ut-ras/rm_electrical-supercap_v2/UT Robomasters – Supercap System Overview.pptx

## UT Robomasters – Supercap System

Egan Wang (ew23776)
Presented 2/10/2026

## Power OR-ing

Power

Time

90W

Objectives:
- Draw excess power from battery in low-load periods
- Provide supplementary power to robot during high-load periods
- Avoid exceeding 90W power budget

## Supercaps

598-DSF117Q3R0
0-3V
110F

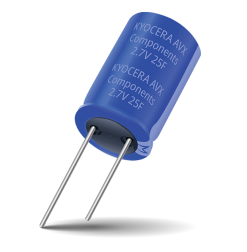
[picture p1: figure]

Objectives:
- Draw excess power from battery in low-load periods
- Provide supplementary power to robot during high-load periods
- Avoid exceeding 90W power budget

x4

## General Design & Problem Statement

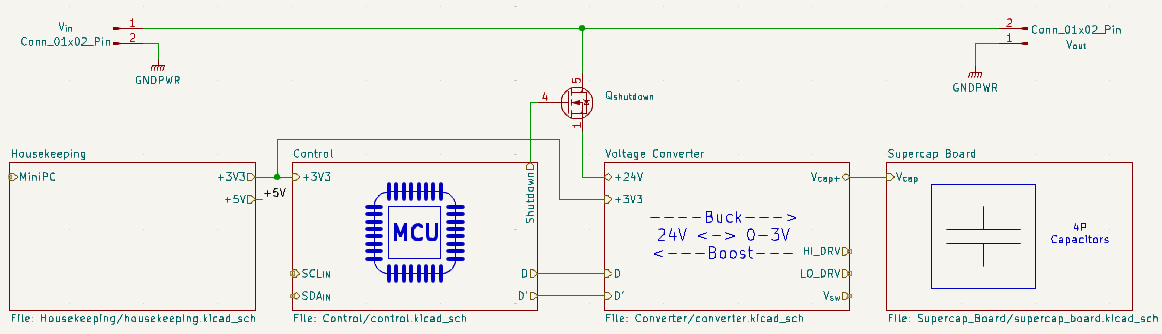
[picture p2: figure]

Problem Statement

Can directly control: duty cycle
Want to control: current coming from battery, set constant
Inputs: voltages, currents

## Converter Design – “Full-bridge Buck Converter”

- Voltage gain of 2D-1 when operated as shown in diagram
- Avoids extreme duty cycles for conversion from 22-26V to 0-3V
- Should be bidirectional

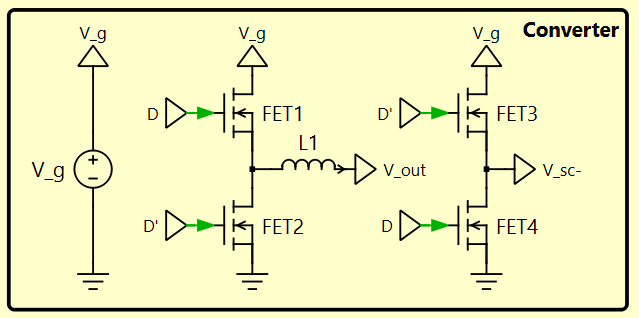
[picture p3: figure]

## Controls Design

- Assumes converter to be ideal transformer
- Closed-loop system to set battery current equal to reference calculated using 90W power budget and battery voltage measurement
- Specific design of compensator still under development

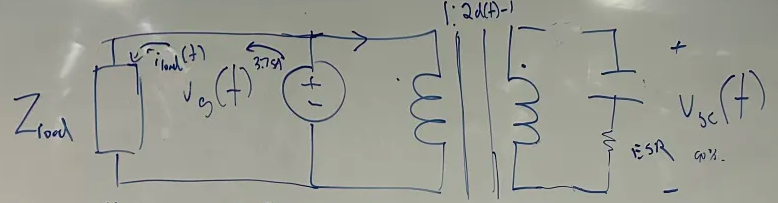
[picture p4: figure]

## Kalman Filtering – Current Sensing

- Create linearized model of circuit to calculate supercap voltage and input current
- Reduce noise of input measurements
- Requires profiling to determine if useful
