ut-ras/rm_electrical-supercap_v2/UT Robomasters – Supercap Power Stage Modeling.pptx

## UT Robomasters – Supercap Power Stage Modeling

Supercap Technical Lead: Egan Wang (ew23776)
Contributing Members: Timothy Yeap, Ethan Chu, Heath Luebsen

## PLECS Analysis: Toy Models

Toy Model Simulation as of Making These Slides

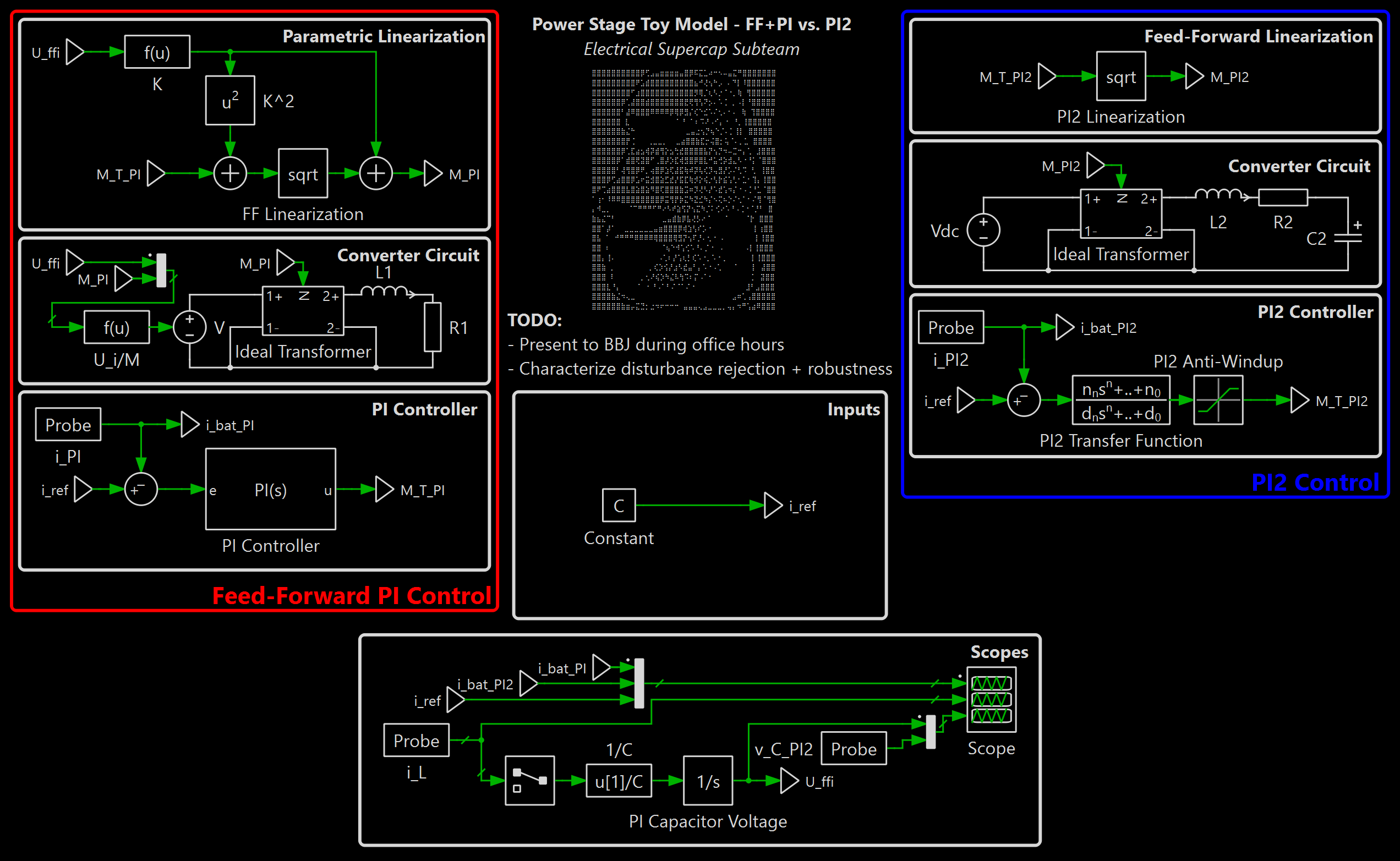
[picture p5: figure]

Power Stage Simulation - Toy Model.plecs

In case you didn’t know yet, this is what everything is about

In GitHub repository, under Sims_and_Design folder

Message me (Egan) if you don’t understand a section of this model

## List of Topics Relevant to This Presentation

Make sure you have at least basic knowledge of these concepts so that you can understand the content in this presentation:
- SRA calculations
- Ideal transformer modeling
- Laplace transforms
- Transfer functions and closed-loop systems
Make sure you are very familiar with these concepts:
- KVL and KCL
- Algebraic manipulation
- Differential and integral calculus

## Section 1: Basics of The Converter

- take notes if you have to

## Overview of Topology

- H-Bridge Converter
- 4 switches
- 2 half-bridges
- Full-bridge analogue to buck converter
- Voltage across switched nodes can be +Vg, 0, or +Vg

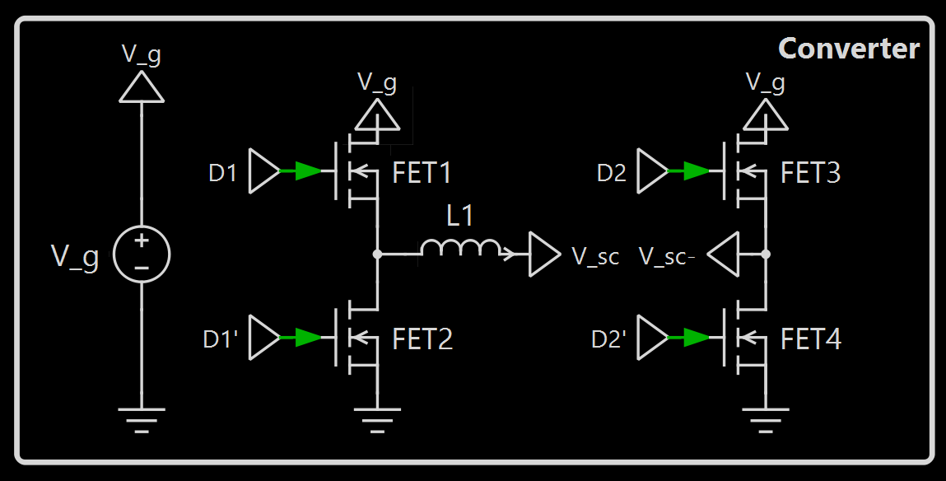
[picture p6: figure]

1 high, 2 low

1 high, 2 high

+

+Vg

+

0

1 low, 2 low

1 low, 2 high

+

0

+

-Vg

Possible Voltages

## Duty Cycle Control

- Half-bridges 1 and 2 are independent
- Both high and both low result in 0 voltage across switch nodes
- Duty ratios <2.5% and >97.5% are risky because MOSFETs take time to turn on and off
- H-bridge topology allows finer control
- Control scheme shown on right
- Duty cycle “seen” across switch nodes labelled as M(t)

Halfway point (50% duty cycle)

Half-bridge 1 duty ratio: 0.5 + doff(t)
Half-bridge 2 duty ratio: 0.5 – doff(t)
Duty cycle “seen” by inductive tank: 2*doff(t)

Scope Reading

Half-bridge 1
Half-bridge 2

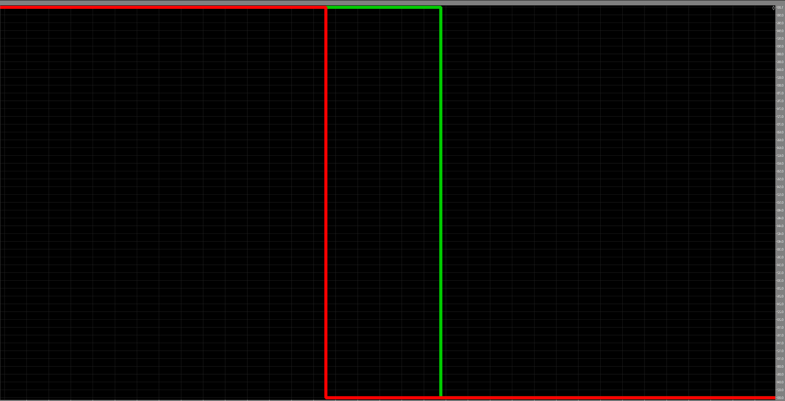
[picture p7: figure]

doff(t)

doff(t)

## Transformer Equivalent

- Use SRA analysis and derive KCL- and KVL-like equations
- Convert into loops and create ideal transformer model of circuit with gain 1:M(t)
- Transformer model will be useful for reflection math tricks

Ideal Transformer Model

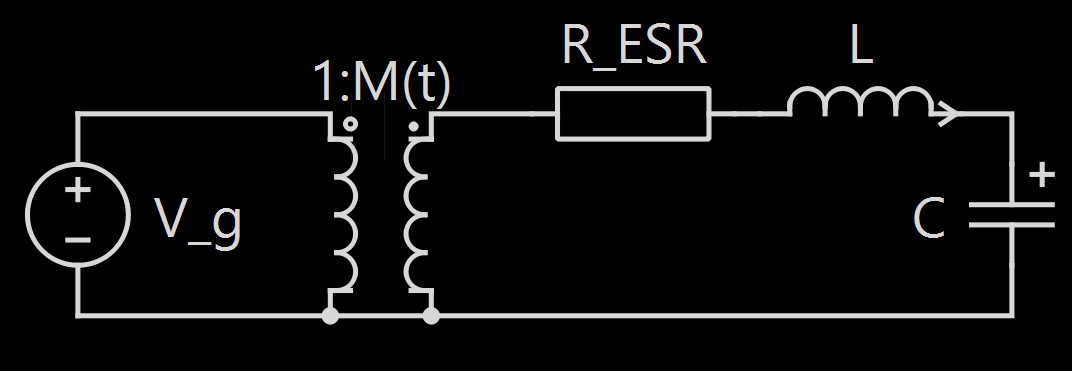
[picture p8: figure]

Voltage/Current Source Model

read it if you don’t know what transformer reflection is

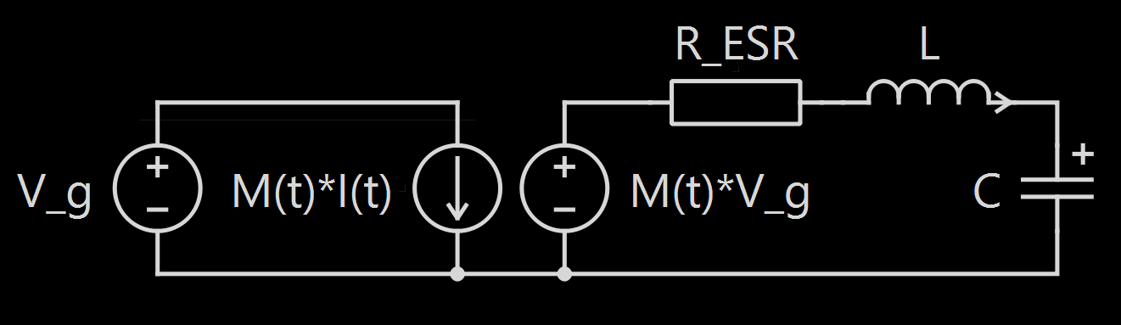
[picture p9: figure]

## Capacitor Feed-Forward Correction

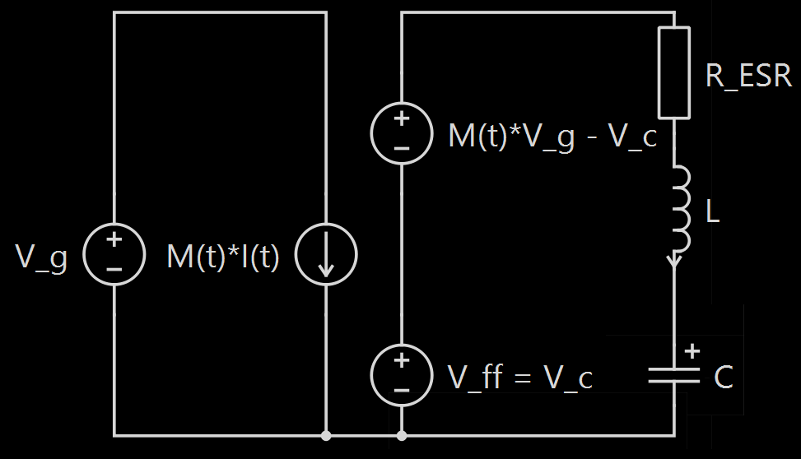
[picture p10: figure]

Separated Voltages

- Split the voltage source on the right into a Vc(t) component and remainder
- Remainder voltage has to be equal to voltage across RL branch
- Current is conserved - take note of the current/voltage behavior of the transformer
- “Cut out” the capacitor and focus on the RL branch
- Even though Vc(t) is time-variant, it changes very slowly and can be treated as constant
- Remember to adjust the voltage source on the left side to compensate – reflect the new voltage source by dividing by M(t)

Isolated RL Branch

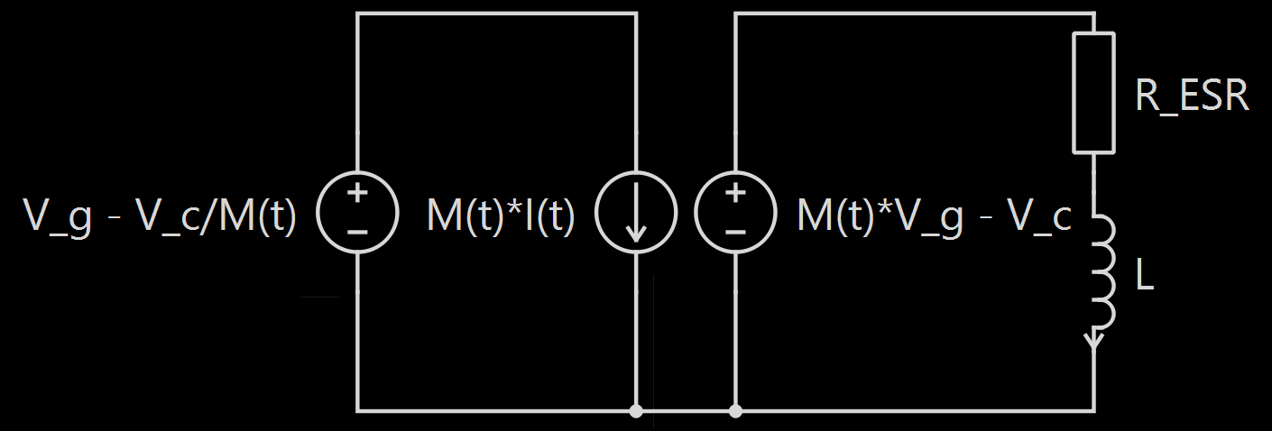
[picture p11: figure]

## Battery Current Reflection

Complete Toy Model

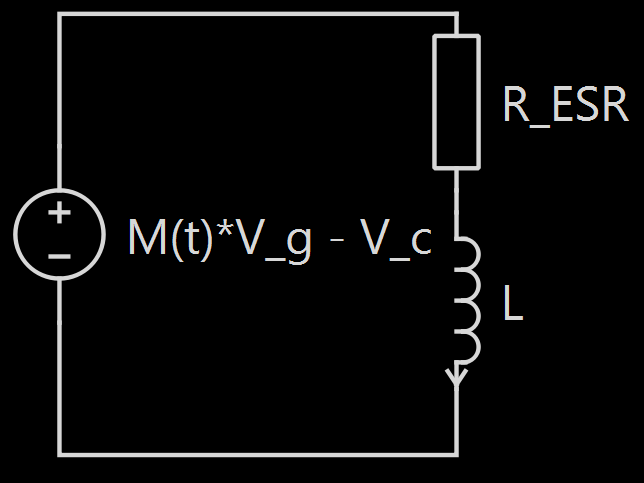
[picture p12: figure]

- Reflect the voltage source across the transformer
- In previous diagram, this is basically already done
- Battery current needs to be scaled by turns ratio
- We have our toy model!
- Write the KVL equation*:
- M(t)∗V_g −V_c =(R_(ESR))/(M(t))∗I_(bat) (t)+L/(M(t))∗d/(dt)I_(bat) (t)
- *before you ask, yes, this calculation ignores the (dM(t))/(dt) term that appears when doing the product rule for d/(dt)I_(RL) (t) . It is possible to account for this by doing another pair of transformer voltage/current reflections, but this presentation is long enough, and we find out that the term is negligible anyway. Consider this an exercise for the reader to prove, if you will.

IRL(t) = Ibat(t)/M(t)

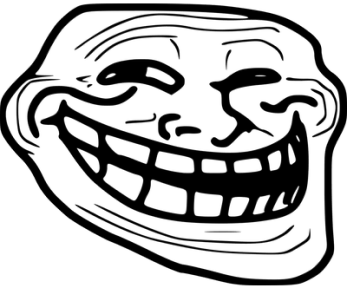
[picture p13: figure]
trollface - Wiktionary, the free dictionary

## Algebraic Manipulation & Linearization

From the equation:
M(t)∗V_g −V_c =(R_(ESR))/(M(t))∗I_(bat) (t)+L/(M(t))∗d/(dt)I_(bat) (t)
Multiply by M(t):
M(t)^2 ∗V_g −M(t)∗V_c =R_(ESR) ∗I_(bat) (t)+L∗d/(dt)I_(bat) (t)
This is quite the nasty equation. It has quadratic terms and a derivative. Let’s define a new variable for the LHS of the equation,
M_T (t)=M(t)^2 −M(t)∗(V_c)/(V_g)
labelled MT(t) due to being roughly equivalent to the “transformer reflection” of the voltage gain M(t).
We complete the square and rewrite:
M_T (t)=(M(t)−(V_c)/(2V_g))^2 −((V_c)/(2V_g))^2

We can then define an auxiliary variable:
M_T (t)=(M(t)−K_T )^2 −K_T^2 ,K_T =(V_c)/(2V_g)
Rewrite the KVL equation:
V_g ∗M_T (t)=R_(ESR) ∗I_(bat) (t)+L∗d/(dt)I_(bat) (t)
By encapsulating the quadratic term within a new variable, we now have only additions, scalar multiplications, and derivatives – the equation is linear! We can now convert to s-domain:
V_g ∗M_T (s)=R_(ESR) ∗I_(bat) (s)+sL∗I_(bat) (s)
Rewrite as a transfer function:
G_(I_(bat) ,M_T) (s)=(V_g)/(sL+R)
We have a proper transfer function now!

## Overall System Design – FF+PI

We go back to our definition of MT(t):
M_T (t)=(M(t)−K_T )^2 −K_T^2 ,K_T =(V_c)/(2V_g)
Solve for M(t):
M(t)=K_T ±√(M_T (t)+K_T^2)
We will be using the solution with both terms added. (The subtractive solution produces identical behavior. Proof is left as exercise to the reader.)
We can thus design our system as a linear black box composed of the linearization above combined with the physical circuitry.

u(t)⇔M_T (s)

Linearization + Circuit

I_(bat) (s)
=G_(I_(bat) ,M_T) (s)∗M_T (s)
=(V_g)/(sL+R)M_T (s)

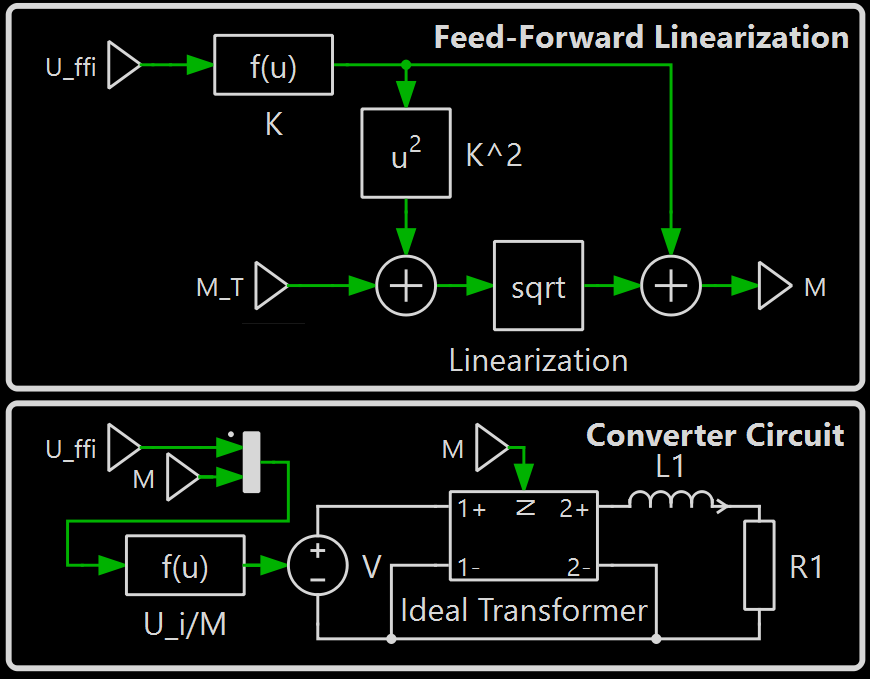
[picture p14: figure]

## Alternative Design – PI² Control

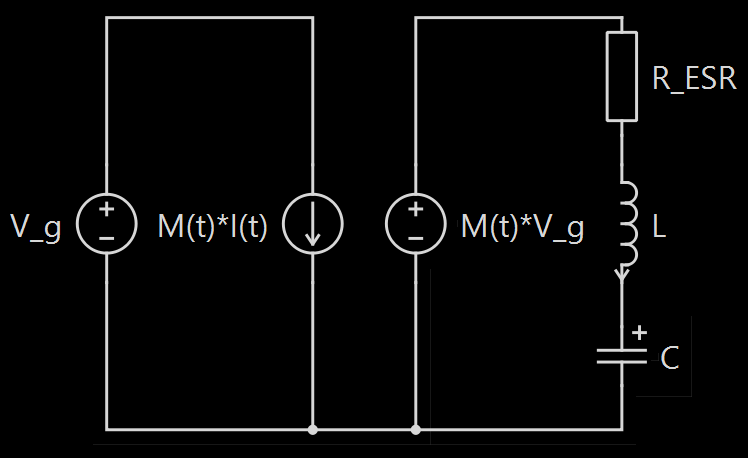
[picture p15: figure]

Singular RLC Branch

- Math trick of defining auxiliary variable can be done earlier
- No need to split apart voltage source on right side of transformer
- Reflect battery current to right side once again
- New toy model appears analogous to the one in the FF+PI model
- Write new KVL loop equation*:
- M(t)∗V_g =(R_(ESR))/(M(t))∗I_(bat) (t)+L/(M(t))∗d/(dt)I_(bat) (t)+1/(C∗M(t))∫ I_(bat) (t)dt
- *Remember that caveat in small print from before? Exercise for the reader: can we ignore this imperfection in our calculus now?

Complete Toy Model

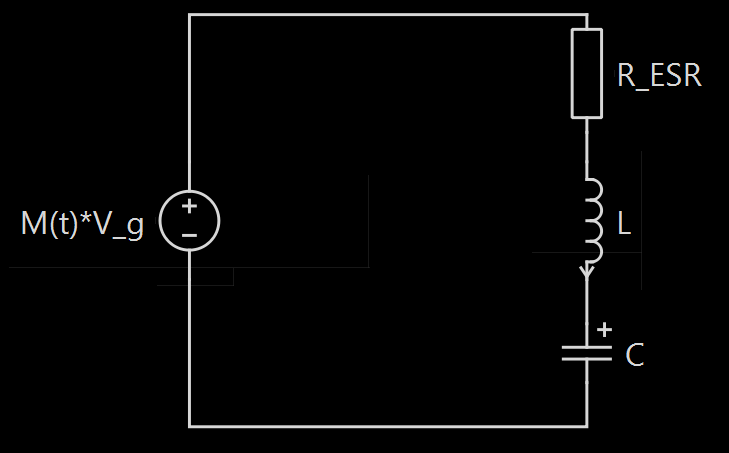
[picture p16: figure]

IRL(t) = Ibat(t)/M(t)

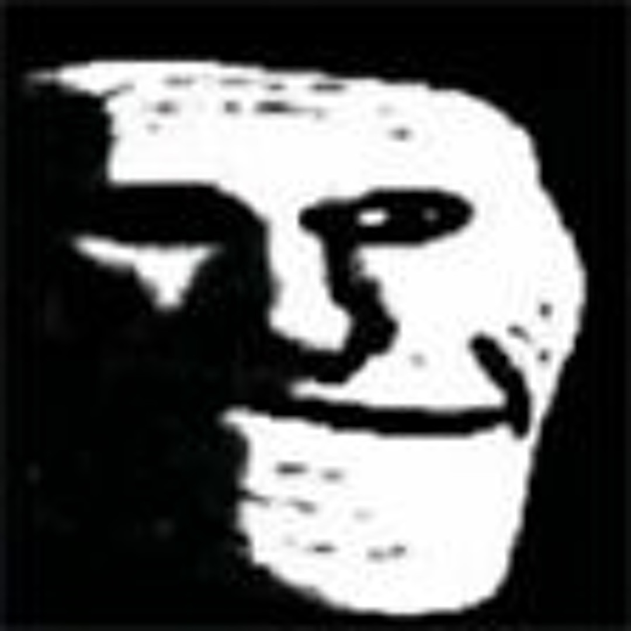
[picture p17: figure]
Stream i miss LSDvlad trolldespair (old hardtekk mix) by Flerian | Listen online for free on SoundCloud

## PI² Control Linearization

From the equation:
M(t)∗V_g =(R_(ESR))/(M(t))∗I_(bat) (t)+L/(M(t))∗d/(dt)I_(bat) (t)+1/(C∗M(t))∫ I_(bat) (t)dt
Multiply by M(t):
M(t)^2 ∗V_g =R_(ESR) ∗I_(bat) (t)+L∗d/(dt)I_(bat) (t)+1/C∫ I_(bat) (t)dt
Our algebra trick is a lot simpler now, and we don’t need to complete the square or define a new auxiliary variable:
M_T (t)=M(t)^2 , M(t)= ±√(M_T (t))
Our KVL equation is now:
V_g ∗M_T (t)=R_(ESR) ∗I_(bat) (t)+L∗d/(dt)I_(bat) (t)+1/C∫ I_(bat) (t)dt
Converting to s-domain:
V_g ∗M_T (s)=R_(ESR) ∗I_(bat) (s)+sL∗I_(bat) (s)+1/(sC)∗I_(bat) (s)

Rewrite as a transfer function:
G_(I_(bat) ,M_T) (s)=(sV_g C)/(s^2 LC+sRC+1)
A little messier, but this is once again a proper transfer function. Note the factor of s in the numerator.
Once again, we can combine the MT(t) to M(t) transformation and the electrical circuitry together and treat it as a singular linear system.
While I was able to skip over many steps since the approach is similar, this idea of PI² control seems to be significantly simpler, even if the transfer function looks more complicated. So why not use this method? Let’s test them out…

## Time-Domain Simulation (0s<t<100s)

Response to 3.75A step input
FF+PI performance is in green
PI² performance is in red

Constant Target Current

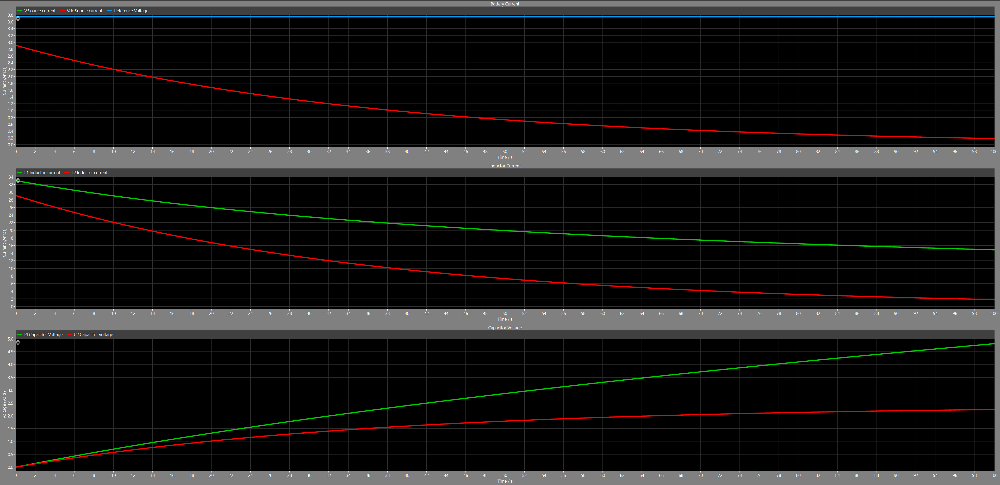
[picture p18: figure]

You can’t see it here, but the FF+PI current waveform is overlapping the target current

## Time-Domain Analysis

- Remember that asterisk? What we did was assume that
- 1/C∫ (I_(bat) (t))/(M(t))dt=1/(C∗M(t))∫ I_(bat) (t)dt
- We can’t actually do this since M(t) is not a scalar value, and this has come back to bite us. Notice that this integral term corresponds precisely to the voltage term that was accounted for with a feed-forward signal!
- Therefore, going forward, our best bet is to stick with FF+PI control.
- Note: If y’all can figure out a way to get a more accurate representation of the system and get a feasible implementation of PI² control, please let me know

## Addendum: On Feed-Forward Systems

In general, feed-forward systems are a way to perform disturbance rejection, where extraneous signals that result from interactions of the system with itself and surroundings (known as disturbances) have their undesirable effects minimized. This particular approach directly measures the quantity in question (capacitor voltage) and subtracts it – pretty intuitive.
A question I answered and found pertinent to include: Why not feed-forward the inductor current? The inductor current is the “through” variable for the entire RLC branch, so performing feed-forward cancellation would result in a controlled current of 0.

## Section 2: Reverse Charging and Boost Mode

- PLECs moment

## Overall System Review: Reverse Charging

- Whole system works as parallel sources
- Nodes between battery, converter, and load use KCL to divide current
- No qualitative distinction between forward charging (storing excess energy) and reverse charging (releasing needed energy)
- System must work seamlessly between both forward and reverse to allow current control behavior

Battery

Load

Converter

Basic Full System Model

## Reverse Charging: Maximum Reverse Current

- Formula for M(t) has limits:
- M(t)=K_T ±√(M_T (t)+K_T^2)
- M_T (t)<−K_T^2 results in non-real M(t)
- Sets limit on maximum reverse current using M_T (t) math trick
- Minimum M_T (t) corresponds to M(t)=K_T , greater than minimum M(t) realizable
- Look back on model with RL branch – possible to attain higher reverse current?
- I_(bat) (t)=I_L (t)∗M(t)<0 requires either I_L (t)<0, M(t)>0 or I_L (t)>0, M(t)<0

Negative current means current flows into battery
Either current flows in reverse from inductor or transformer polarity flips

Isolated RL Branch

## Maximum Reverse Current, Continued

I_L (t)>0, M(t)<0

I_L (t)<0, M(t)>0

1 high, 2 low

1 high, 2 high

+

+Vg

+

0

1 low, 2 low

1 low, 2 high

+

0

+

-Vg

M(t)<0 corresponds to a change to −V_g regime
Current flowing out of capacitor results in negative inductor current
Thus I_L (t)<0, M(t)<0 , I_(bat) (t)>0
Reverse charging not possible!

Possible Voltages

Isolated RL Branch

I_L (t)<0 corresponds to negative inductor current
Steady-state negative inductor current requires M(t)∗V_g −V_c <0 due to RL branch impedance
Thus M(t)∗V_g <V_c , M(t)>0 , I_(bat) (t)<0
Reverse charging is possible!

## Maximum Reverse Current, Continued

To find steady-state maximum reverse current, we approximate the inductor as having 0 impedance. Negative voltage across resistor in RL branch causes negative current which is then reflected across ideal transformer. We can thus derive an expression for reverse current:
I_(bat) (t)=(V_G ∗M(t)^2 −V_C ∗M(t))/R
Apply optimization for maximum reverse current:
I_(bat,max) =(V_C^2)/(4V_G R),M(t)=(V_C)/(2V_G)=K
A familiar constant appears! Let’s see if a corresponding M_T (t) appears:
M_T (t)=(M(t)−K_T )^2 −K_T^2
∴M_T (t)=−K_T^2
This is precisely the minimum value we saw earlier!

This conclusion tells us that our control scheme should (at least theoretically) work in with both forward and reverse currents. All we need to do is make sure that M_T (t) never drops below its minimum value of −K_T^2 , and we should be able to see a smooth transition between the two domains!
To find out, we simply leave everything as-is and see what happens when we set the reference current to a negative value.

## Time-Domain Simulation (0s<t<????)

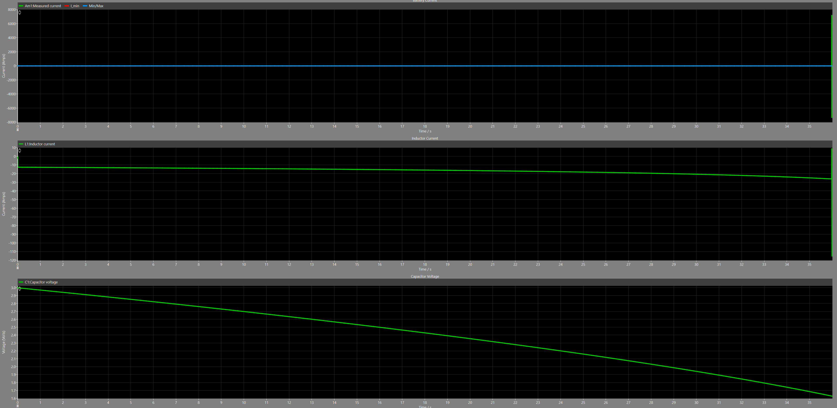
[picture p19: figure]
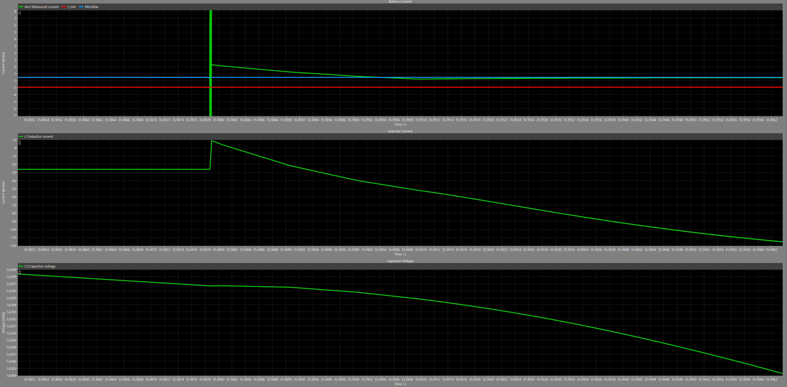
[picture p20: figure]

## Modeling Schema – State-Space Model

Start with KCL and KVL equations for RLC branch:
M(t)∗V_g (t)−R∗i(t)−v_c (t)−L∗(di(t))/(dt)=0
i(t)=C∗(dv_c (t))/(dt)
Rearrange to solve for derivates of state variables ( i(t), v_c (t) ) and output i_(bat) (t) :
d/(dt)[i(t)v_c (t)]=[1/L∗(M(t)∗V_g (t)−R∗i(t)−v_c (t))1/C∗i(t)]
i_(bat) =M(t)∗i(t)
Note the combination of state variables into a state vector – this forms the state-space model. Take integral of both sides of first equation to arrive at new mathematical model of system (bottom image)

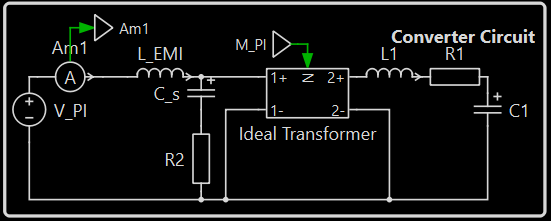
[picture p21: figure]
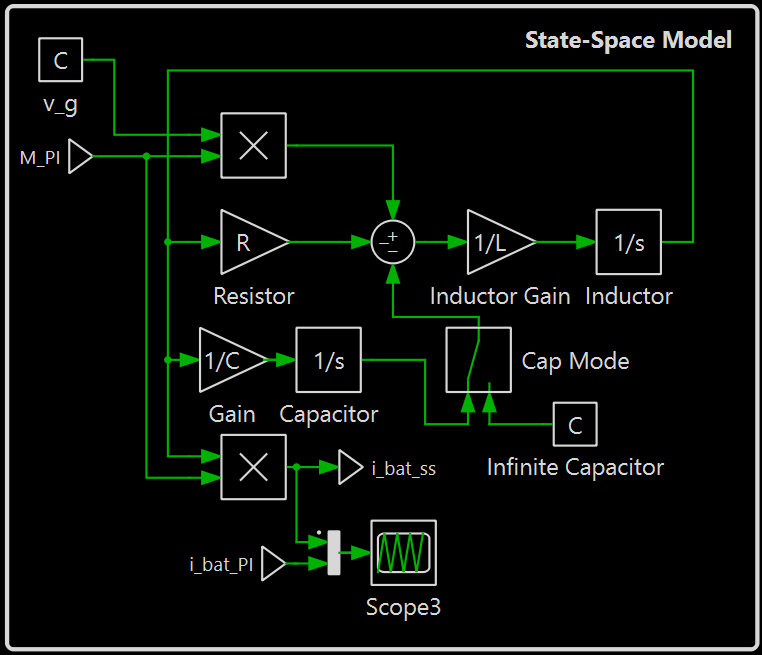
[picture p22: figure]

KVL

## New Time-Domain Simulation (0<t<100)

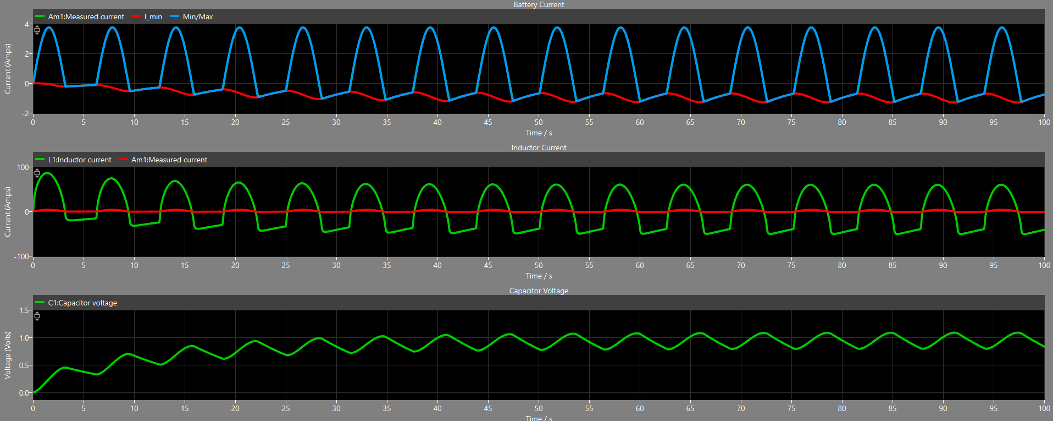
[picture p23: figure]

With this new model, everything works!

## Addendum: Resistance and Inductor Characteristics

3/28/2026:

4/1/2026:

First-order estimates for R approximate its value at 83 mΩ, making the maximum reverse current roughly 1.2A at full capacitor charge. Considering that the maximum reverse current scales with stored capacitor voltage and the capacitor is not expected to be at full charge during operation, this results in even lower maximum reverse current during expected operation conditions.
To ameliorate this limitation, increasing reverse current would require lower resistance across the RL branch, the lion’s share of which is from the inductor. Maximizing copper area and mitigating skin effects are of utmost importance to optimize performance.

The switched-cycle average model used to calculate maximum reverse current uses switch-cycle average voltages and currents for its modeling of system dynamics, meaning it disregards effects at the converter’s 120kHz switching frequency. Average signals can be treated as low-frequency and skin effects can be discarded.
Experimentally, the inductor was rewound to optimize DC resistance instead of AC resistance and a new resistance value of 4 mΩ was measured.

## Section 3: Disturbance Rejection & Robustness

- alright guys ill need yall to pitch in now

## Sources of Inaccuracies: Examples

Average Inductor Current

<iL(t)>

Inductor current graph:

Resistance

R

First-order calculation:
R_(eq) =2∗R_(on) +R_L +(R_C)/4

All dependent on temperature

<iL(t)> is not even directly measurable*

Noise on each switch transition

Current ripple introduces AC component

(+ R_(board) )
PCB trace resistances are hard to measure

<iL(t)>

iL(t)

MOSFET resistance dependent on gate voltage

Inductor resistance dependent on frequency due to skin effect**

Both signals and system parameters will not behave exactly as in the model

*It is possible to get a good guess of <iL(t)> by measuring exactly between switch transitions. However, these transitions can appear arbitrarily close together due to the soft-starting capability of the H-bridge, and the AC component of the signal will introduce extra complications beyond this simplified model.
**While frequency is fixed for this application, the LCR meter in the solar lab only measures impedance at 100kHz, so it’s possible for measurement error to creep in as a result.

## Disturbance Rejection - Noise

- Linear systems can be represented by block diagrams and transfer functions
- Disturbances enter at different points of the loop
- Control disturbance W(s) , sensor noise N(s) , rounding error D(s) all considered disturbances
- Simplify feedback to single disturbance source with unity feedback
- Rounding error ignored/bundled into sensor noise
- Note that controller cannot tell the difference between N(s)∗H(s) and R(s)

W(s)

Linear System With Noise

R(s)

+

+

PI Controller
D(s)

+

Plant
G(s)

Y(s)

Scaling
H(s)

+

Sensor gain
H^(−1) (s)

D(s)

N(s)

W(s)

Simplified UFB System

R(s)

PI Controller
D(s)

Plant
G(s)

Y(s)

+

+

+

N(s)∗H(s)

## Disturbance Rejection – Full Model

w(t)

Full UFB System

e(s)

PI Controller
D(s)

M_T (s)

Linearized Plant
G_(iM_T) (s)

Linearization
M_T (t)→M(t)

M(t)

Plant
G_(iM) (t)

I_(ref) (s)

+

+

I_(bat) (s)

I_(bat,sense) (s)

+

N(s)∗H(s)

Key Takeaway: Disturbance w(t) is inserted into the nonlinear control signal M(t) and cannot be analyzed using typical tools
Can trivially calculate transfer function (I_(bat) (s))/(N(s))=H(s)∗(D(s)G_(iM_T) (s))/(1+D(s)G_(iM_T) (s))

## Model Robustness - Sensitivity

- Definition: Change in output behavior of a system relative to change in parameter
- Relative change determined in proportion to parameter size
- Can use simple calculus and algebra
- Very useful metric to evaluate robustness of closed-loop control systems
- Accounts for numerical stability issues like small-difference-of-large-numbers and division by small numbers

S_G^T =((ΔT)/T)/((ΔG)/G)
S_G^T =(ΔT)/(ΔG)∗G/T
S_G^T =(dT)/(dG)∗G/T

“Sensitivity of T to G”

Can be done relative to the entire plant G(s) or to specific parameters in the closed-loop system

## Sensitivity

S_(V_g)^T =(sL+R)/(sL+R+DV_g)
S_R^T =R/(sL+R+DV_g)
S_L^T =(sL)/(sL+R+DV_g)

R=0.08233Ω
V_g =24V
L=28.306μF
K_p =2.13422
K_i =6207.54

E_(V_g) =R/(K_i V_g)
E_R =R/(K_i V_g)
E_L =0

E_(V_g) =0.55262∗10^(−6)
E_R =0.55262∗10^(−6)
E_L =0

## Sensor White Noise

It was empirically found that the MSPM0-G3507 12-bit ADC’s error has SD of 14 (decimal).

SD_E _(reading) =1/(gain_(sensor))∗3.3/4095∗14

SD_(E_(i, Inductor)) =(1000 A)/(80 V)∗(3.3 V)/4095∗14=0.141 A

SD_(E_(i, Battery)) =(1000 A)/(132 V)∗(3.3 V)/4095∗14=0.0855 A

SD_(E_(v,Capacitor)) =(10 V)/(11 V)∗(3.3V)/4095∗14=0.0103 V

SD_(E_(v,Battery)) =(8 V)/(1 V)∗(3.3 V)/4095∗14=0.0903 V
