ut-ras/rm_electrical-supercap_v2/Sims_and_Design/Sensitivity Equations (RM Electrical).pdf

SVg

T =

sL + R
sL + R + DVg

SR

T = −

R
R + sL + DVg

SL

T = −

sL
R + sL + DVG
