ut-ras/rm_electrical-supercap_v2/Sims_and_Design/Pi Filter/PI Filter Values (RM_Electrical '26).xlsx

L | C | R | a | L (uH) | C (uF) | R (kΩ) | f (Hz) | 1/(RC)
2.7e-05 | 1.007e-05 | 1317.074 | 48780443.13 | 27 | 10.07 | 1.317074 | 7763877.628 | 75.39809146
2.7e-05 | 1.044e-05 | 1270.396162 | 47051634.33 | 27 | 10.44 | 1.270396162 | 7488721.045 | 75.39808718
2.7e-05 | 1.066e-05 | 1244.177897 | 46080587.46 | 27 | 10.66 | 1.244177897 | 7334169.579 | 75.39808464
2.7e-05 | 1.088e-05 | 1219.019929 | 45148810.88 | 27 | 10.88 | 1.219019929 | 7185868.356 | 75.39808209
2.7e-05 | 1.108e-05 | 1197.015996 | 44333850.39 | 27 | 11.08 | 1.197015996 | 7056159.541 | 75.39807977
2.7e-05 | 1.109e-05 | 1195.936633 | 44293873.97 | 27 | 11.09 | 1.195936633 | 7049796.908 | 75.39807966
2.7e-05 | 1.197e-05 | 1108.014958 | 41037515.65 | 27 | 11.97 | 1.108014958 | 6531516.099 | 75.39806948
2.7e-05 | 1.248e-05 | 1062.735584 | 39360501.79 | 27 | 12.48 | 1.062735584 | 6264603.182 | 75.39806357
2.7e-05 | 1.264e-05 | 1049.283261 | 38862267.59 | 27 | 12.64 | 1.049283261 | 6185304.407 | 75.39806172
2.7e-05 | 1.267e-05 | 1046.798775 | 38770249.59 | 27 | 12.67 | 1.046798775 | 6170658.856 | 75.39806137
2.7e-05 | 1.271e-05 | 1043.504371 | 38648234.65 | 27 | 12.71 | 1.043504371 | 6151239.001 | 75.39806091
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
