ut-ras/rm_electrical-supercap_v2/Sims_and_Design/Pi Filter/pi_filter_solutions.xlsx

L_uH | C_uF | R_kOhm | f_Hz | zero | gain
2 | 10.1980198 | 1.300538387 | 8624463.833 | 75.39819926 | 0.9999998841
2 | 10.2070207 | 1.299391528 | 8616858.486 | 75.39819925 | 0.999999884
2 | 11.04410441 | 1.200904651 | 7963746.962 | 75.39819853 | 0.9999998744
2 | 11.05310531 | 1.199926715 | 7957261.827 | 75.39819852 | 0.9999998743
2 | 11.06210621 | 1.198950372 | 7950787.244 | 75.39819852 | 0.9999998742
2 | 12.05220522 | 1.100455581 | 7297623.243 | 75.39819767 | 0.999999863
2 | 12.06120612 | 1.099634346 | 7292177.256 | 75.39819766 | 0.9999998629
2 | 12.07020702 | 1.098814335 | 7286739.391 | 75.39819765 | 0.9999998628
2 | 13.25832583 | 1.000346262 | 6633752.561 | 75.39819663 | 0.9999998493
2 | 13.26732673 | 0.9996676008 | 6629252.051 | 75.39819663 | 0.9999998492
2.383838384 | 10.1980198 | 1.300538416 | 7235778.979 | 75.39819758 | 0.9999998618
2.383838384 | 10.2070207 | 1.299391557 | 7229398.221 | 75.39819757 | 0.9999998617
2.383838384 | 11.04410441 | 1.20090468 | 6681448.723 | 75.39819672 | 0.9999998503
2.383838384 | 11.05310531 | 1.199926744 | 6676007.804 | 75.39819671 | 0.9999998502
2.383838384 | 11.06210621 | 1.198950401 | 6670575.739 | 75.3981967 | 0.9999998501
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
