ut-ras/rm_electrical-supercap_v2/Sims_and_Design/Power Consumption, Efficiency.xlsx

+3V3 |  | Total Current: | 117.5mA | +12V |  | Total Current: | 75.9mA | 24+V |  | Total Current: | 0mA | Total Power Draw: | 1.3W | 0.05A @ 24V
Component | Supply Current | Quantity | Sum Current | Component | Supply Current | Quantity | Sum Current | Component | Supply Current | Quantity | Sum Current | Switching frequency: | Gate charge:
U_iL | 0.0055 | 1 | 0.0055 | MOSFET | 0.0171 | 4 | 0.0684 | U_vc | 8e-09 | 1 | 8e-09 | 150000 | 1.14e-07
U_ig | 0.012 | 1 | 0.012 | Gate Driver | 0.00375 | 2 | 0.0075 | U_vg | 2.8e-09 | 1 | 2.8e-09
MSPM0 | 0.1 | 1 | 0.1
Best: | N7803-1PV |  |  | Best: | P7812B-1000 |  |  | Best: | SCT01F12S3V3
+1V65 Reference Voltage Circuit
Label | Value | Units | Procedure
Desired Vz | 1.65 | volts | 1) pick a desired reference voltage Vz (volts)
Vref | 1.233 | volts | LM4041 parameter
R1 | 47 | kohm | 2) choose a standard resistance value (kohm)
best R2 | 15.89537713 | kohm | 2.5) Note this value for binning imperfect resistances
Pick R2 | 16 | kohm | 3) pick a standard value for R2 close to best R2
Actual Vref | 1.652744681 | volts | Vz=Vref(1+R2/R1)
Vs | 3.3 | volts | V supply
Rin | 10 | kohm | 4) estimate input impedence on Vz (e.g., to DAC)
Iz | 0.08 | mA | LM4041 parameter
Iref | 0.02623404255 | mA | Vz/(R1+R2), Ohms Law, current through R1,R2
IL | 0.1652744681 | mA | Vz/Rin, Ohms Law, current through Rin
I total | 0.2715085106 | mA | Iz+Iref+IL
max Rs | 6.067048562 | kohm | (Vs-Vz)/Itotal
 | 5.6 | kohm | 5) choose Rs less than max Rs
