ut-ras/rm_electrical-supercap_v2/Sims_and_Design/Inductor Design & Selection/3A Isat.xlsx

Selected | Order Code | Series | Size | Spec | Type | L0 | RDC,typ | IR | Isat | fres | Vop | L | W | HMax | Top | Shielded | AEC-Q | Automotive | Material | Assembling Technology | EmptyProperty
 | 74437529203681 | WE-HCF | 2920 Round | https://www.we-online.com/katalog/en/datasheet/74437529203681 | Single | 0.00068 | 0.1183 | 4.3 | 3 | 1133000 | 250 | 0.025 | 0.028 | 0.0205 | 125 | Shielded | 1 | FALSE | MnZn | SMT
 | 74437529203471 | WE-HCF | 2920 Round | https://www.we-online.com/katalog/en/datasheet/74437529203471 | Single | 0.00047 | 0.08345 | 5.2 | 3.7 | 1695000 | 250 | 0.025 | 0.028 | 0.0205 | 125 | Shielded | 1 | FALSE | MnZn | SMT
 | 74437529203331 | WE-HCF | 2920 Round | https://www.we-online.com/katalog/en/datasheet/74437529203331 | Single | 0.00033 | 0.07045 | 5.75 | 4.3 | 2395000 | 250 | 0.025 | 0.028 | 0.0205 | 125 | Shielded | 1 | FALSE | MnZn | SMT
 | 74437529203221 | WE-HCF | 2920 Round | https://www.we-online.com/katalog/en/datasheet/74437529203221 | Single | 0.00022 | 0.03645 | 8.15 | 5.3 | 2818000 | 250 | 0.025 | 0.028 | 0.0205 | 125 | Shielded | 1 | FALSE | MnZn | SMT
 | 74437429203151 | WE-HCF | 2920 Litz | https://www.we-online.com/katalog/en/datasheet/74437429203151 | Single | 0.00015 | 0.03885 | 7.9 | 7.8 | 3758000 | 250 | 0.025 | 0.028 | 0.0205 | 125 | Shielded | 1 | FALSE | MnZn | SMT
 | 74437529203151 | WE-HCF | 2920 Round | https://www.we-online.com/katalog/en/datasheet/74437529203151 | Single | 0.00015 | 0.0306 | 9 | 7.2 | 3186000 | 250 | 0.025 | 0.028 | 0.0205 | 125 | Shielded | 1 | FALSE | MnZn | SMT
 | 74437636351012 | WE-HCFT | 3635 | https://www.we-online.com/katalog/en/datasheet/74437636351012 | Single | 0.00011 | 0.00628 | 23.7 | 27.2 | 5106750.313 | 400 | 0.036 | 0.0357 | 0.0342 | 155 | Shielded | 0 | FALSE | Metal Alloy | THT
 | 7447707101 | WE-PD | 1280 | https://www.we-online.com/katalog/en/datasheet/7447707101 | Single | 0.0001 | 0.105 | 2.1 | 3.5 | 4300000 | 120 | 0.012 | 0.012 | 0.008 | 150 | Shielded | 1 | FALSE | MnZn / NiZn | SMT
 | 7447709101 | WE-PD | 1210 | https://www.we-online.com/katalog/en/datasheet/7447709101 | Single | 0.0001 | 0.1 | 2.5 | 3.1 | 4300000 | 120 | 0.012 | 0.012 | 0.01 | 125 | Shielded | 1 | TRUE | NiZn | SMT
 | 744373965101 | WE-LHMI | 1365 | https://www.we-online.com/katalog/en/datasheet/744373965101 | Single | 0.0001 | 0.1408 | 3.2 | 6.8 | 2400000 | 120 | 0.0135 | 0.0125 | 0.0065 | 125 | Shielded | 1 | FALSE | Iron Powder | SMT
 | 7447231101 | WE-TI | 1018 | https://www.we-online.com/katalog/en/datasheet/7447231101 | Single | 0.0001 | 0.075 | 2.6 | 3.1 | 3577319.5 | 120 | 0.01 | 0.01 | 0.019 | 125 | Unshielded | No | FALSE | NiZn | THT
 | 74437429203101 | WE-HCF | 2920 Litz | https://www.we-online.com/katalog/en/datasheet/74437429203101 | Single | 0.0001 | 0.0359 | 8.2 | 9.7 | 4260000 | 250 | 0.025 | 0.028 | 0.0205 | 125 | Shielded | 1 | FALSE | MnZn | SMT
 | 74437529203101 | WE-HCF | 2920 Round | https://www.we-online.com/katalog/en/datasheet/74437529203101 | Single | 0.0001 | 0.0229 | 10.5 | 9.4 | 4260000 | 250 | 0.025 | 0.028 | 0.0205 | 125 | Shielded | 1 | FALSE | MnZn | SMT
 | 7447709820 | WE-PD | 1210 | https://www.we-online.com/katalog/en/datasheet/7447709820 | Single | 8.2e-05 | 0.0905 | 2.75 | 3.4 | 4500000 | 120 | 0.012 | 0.012 | 0.01 | 125 | Shielded | 1 | TRUE | NiZn | SMT
 | 74435588200 | WE-HCI | 2212 | https://www.we-online.com/katalog/en/datasheet/74435588200 | Single | 8.2e-05 | 0.0304 | 6.6 | 8.5 | 5000000 | 80 | 0.0225 | 0.022 | 0.0124 | 125 | Shielded | 1 | FALSE | MnZn | SMT
 | 784373170820 | WE-LHCA | 1770 | https://www.we-online.com/katalog/en/datasheet/784373170820 | Single | 8.2e-05 | 0.09 | 4.9 | 9.6 | 2633700 | 120 | 0.01745 | 0.01695 | 0.007 | 155 | Shielded | 0 | TRUE | Metal Alloy | SMT
 | 7447707680 | WE-PD | 1280 | https://www.we-online.com/katalog/en/datasheet/7447707680 | Single | 6.8e-05 | 0.078 | 2.45 | 4.2 | 5500000 | 120 | 0.012 | 0.012 | 0.008 | 150 | Shielded | 1 | FALSE | MnZn / NiZn | SMT
 | 7447709680 | WE-PD | 1210 | https://www.we-online.com/katalog/en/datasheet/7447709680 | Single | 6.8e-05 | 0.0686 | 3.2 | 3.6 | 6000000 | 120 | 0.012 | 0.012 | 0.01 | 125 | Shielded | 1 | TRUE | NiZn | SMT
 | 74435586800 | WE-HCI | 2212 | https://www.we-online.com/katalog/en/datasheet/74435586800 | Single | 6.8e-05 | 0.0273 | 6.9 | 9.5 | 5800000 | 80 | 0.0225 | 0.022 | 0.0124 | 125 | Shielded | 1 | FALSE | MnZn | SMT
 | 74437349680 | WE-LHMI | 7050 | https://www.we-online.com/katalog/en/datasheet/74437349680 | Single | 6.8e-05 | 0.386 | 1.65 | 3.8 | 3500000 | 120 | 0.0073 | 0.0066 | 0.005 | 125 | Shielded | 1 | FALSE | Iron Powder | SMT
 | 7447480680 | WE-TI | 1014 | https://www.we-online.com/katalog/en/datasheet/7447480680 | Single | 6.8e-05 | 0.063 | 2.9 | 3.5 | 6071060.577 | 120 | 0.01 | 0.01 | 0.0145 | 125 | Unshielded | No | FALSE | NiZn | THT
 | 744870680 | WE-DD | 1280 | https://www.we-online.com/katalog/en/datasheet/744870680 | Coupled | 6.8e-05 | 0.17 | 1.35 | 3 |  | 80 | 0.012 | 0.012 | 0.0085 | 125 | Shielded | No | FALSE | NiZn | SMT
 | 74437429203680 | WE-HCF | 2920 Litz | https://www.we-online.com/katalog/en/datasheet/74437429203680 | Single | 6.8e-05 | 0.0222 | 10.8 | 10.7 | 5309000 | 250 | 0.025 | 0.028 | 0.0205 | 125 | Shielded | 1 | FALSE | MnZn | SMT
 | 74437529203680 | WE-HCF | 2920 Round | https://www.we-online.com/katalog/en/datasheet/74437529203680 | Single | 6.8e-05 | 0.0103 | 16 | 10.6 | 5663000 | 250 | 0.025 | 0.028 | 0.0205 | 125 | Shielded | 1 | FALSE | MnZn | SMT
 | 7447706680 | WE-PD | 1260 | https://www.we-online.com/katalog/en/datasheet/7447706680 | Single | 6.8e-05 | 0.082 | 2.3 | 3 | 6500000 | 120 | 0.012 | 0.012 | 0.006 | 150 | Shielded | 1 | FALSE | MnZn / NiZn | SMT
 | 784373680680 | WE-LHCA | 1040 | https://www.we-online.com/katalog/en/datasheet/784373680680 | Single | 6.8e-05 | 0.215 | 2.6 | 4.85 | 4124700 | 120 | 0.01085 | 0.01 | 0.004 | 155 | Shielded | 0 | TRUE | Metal Alloy | SMT
 | 784373170680 | WE-LHCA | 1770 | https://www.we-online.com/katalog/en/datasheet/784373170680 | Single | 6.8e-05 | 0.075 | 5.9 | 8.2 | 2334000 | 120 | 0.01745 | 0.01695 | 0.007 | 155 | Shielded | 0 | TRUE | Metal Alloy | SMT
 | 7443783533650 | WE-HCFT | 3533 | https://www.we-online.com/katalog/en/datasheet/7443783533650 | Single | 6.5e-05 | 0.01313 | 17.2 | 26.6 | 4282000 | 250 | 0.0345 | 0.036 | 0.035 | 125 | Shielded | 1 | FALSE | MnZn | THT
 | 74437636356203 | WE-HCFT | 3635 | https://www.we-online.com/katalog/en/datasheet/74437636356203 | Single | 6.2e-05 | 0.00522 | 26.3 | 43.1 | 6194997.856 | 400 | 0.036 | 0.0357 | 0.0342 | 155 | Shielded | 0 | FALSE | Metal Alloy | THT
 | 744770156 | WE-PD | 1280 | https://www.we-online.com/katalog/en/datasheet/744770156 | Single | 5.6e-05 | 0.059 | 2.8 | 3 | 7100000 | 120 | 0.012 | 0.012 | 0.008 | 125 | Shielded | 1 | TRUE | NiZn | SMT
 | 74437636355602 | WE-HCFT | 3635 | https://www.we-online.com/katalog/en/datasheet/74437636355602 | Single | 5.6e-05 | 0.00319 | 32.8 | 36.9 | 7413102.413 | 400 | 0.036 | 0.0357 | 0.0342 | 155 | Shielded | 0 | FALSE | Metal Alloy | THT
 | 784373680560 | WE-LHCA | 1040 | https://www.we-online.com/katalog/en/datasheet/784373680560 | Single | 5.6e-05 | 0.17 | 3 | 5.5 | 4419100 | 120 | 0.01085 | 0.01 | 0.004 | 155 | Shielded | 0 | TRUE | Metal Alloy | SMT
 | 784373170560 | WE-LHCA | 1770 | https://www.we-online.com/katalog/en/datasheet/784373170560 | Single | 5.6e-05 | 0.052 | 7.1 | 10.3 | 2633200 | 120 | 0.01745 | 0.01695 | 0.007 | 155 | Shielded | 0 | TRUE | Metal Alloy | SMT
 | 744770147 | WE-PD | 1280 | https://www.we-online.com/katalog/en/datasheet/744770147 | Single | 4.7e-05 | 0.053 | 3 | 3.3 | 7900000 | 120 | 0.012 | 0.012 | 0.008 | 125 | Shielded | 1 | TRUE | NiZn | SMT
 | 7447707470 | WE-PD | 1280 | https://www.we-online.com/katalog/en/datasheet/7447707470 | Single | 4.7e-05 | 0.055 | 2.9 | 5.1 | 7200000 | 120 | 0.012 | 0.012 | 0.008 | 150 | Shielded | 1 | FALSE | MnZn / NiZn | SMT
 | 7447709470 | WE-PD | 1210 | https://www.we-online.com/katalog/en/datasheet/7447709470 | Single | 4.7e-05 | 0.0459 | 3.8 | 4.5 | 6500000 | 120 | 0.012 | 0.012 | 0.01 | 125 | Shielded | 1 | TRUE | NiZn | SMT
 | 74435574700 | WE-HCI | 1890 | https://www.we-online.com/katalog/en/datasheet/74435574700 | Single | 4.7e-05 | 0.0335 | 6.4 | 7 | 7500000 | 80 | 0.0183 | 0.0182 | 0.0092 | 125 | Shielded | 1 | FALSE | MnZn | SMT
 | 74435584700 | WE-HCI | 2212 | https://www.we-online.com/katalog/en/datasheet/74435584700 | Single | 4.7e-05 | 0.0192 | 8.4 | 12 | 6500000 | 80 | 0.0225 | 0.022 | 0.0124 | 125 | Shielded | 1 | FALSE | MnZn | SMT
 | 7443634700 | WE-HCF | 2013 | https://www.we-online.com/katalog/en/datasheet/7443634700 | Single | 4.7e-05 | 0.0122 | 12.8 | 8.5 | 9157462.861 | 150 | 0.0208 | 0.0205 | 0.0145 | 125 | Shielded | 1 | FALSE | MnZn | SMT
 | 7443783533470 | WE-HCFT | 3533 | https://www.we-online.com/katalog/en/datasheet/7443783533470 | Single | 4.7e-05 | 0.0118 | 19.3 | 32.3 | 5103000 | 250 | 0.0345 | 0.036 | 0.035 | 125 | Shielded | 1 | FALSE | MnZn | THT
 | 7443763540470 | WE-HCFT | 3540 | https://www.we-online.com/katalog/en/datasheet/7443763540470 | Single | 4.7e-05 | 0.00567 | 32 | 31 | 6081000 | 250 | 0.041 | 0.036 | 0.035 | 125 | Shielded | 1 | FALSE | MnZn | THT
 | 74437429203470 | WE-HCF | 2920 Litz | https://www.we-online.com/katalog/en/datasheet/74437429203470 | Single | 4.7e-05 | 0.0193 | 11.65 | 13.5 | 7499000 | 250 | 0.025 | 0.028 | 0.0205 | 125 | Shielded | 1 | FALSE | MnZn | SMT
 | 74437529203470 | WE-HCF | 2920 Round | https://www.we-online.com/katalog/en/datasheet/74437529203470 | Single | 4.7e-05 | 0.0088 | 17.5 | 13 | 6725000 | 250 | 0.025 | 0.028 | 0.0205 | 125 | Shielded | 1 | FALSE | MnZn | SMT
 | 74437349470 | WE-LHMI | 7050 | https://www.we-online.com/katalog/en/datasheet/74437349470 | Single | 4.7e-05 | 0.29 | 1.9 | 3.4 | 7300000 | 120 | 0.0073 | 0.0066 | 0.005 | 125 | Shielded | 1 | FALSE | Iron Powder | SMT
 | 74437368470 | WE-LHMI | 1040 | https://www.we-online.com/katalog/en/datasheet/74437368470 | Single | 4.7e-05 | 0.145 | 2.95 | 6.7 | 5000000 | 120 | 0.011 | 0.01 | 0.0042 | 125 | Shielded | 1 | FALSE | Iron Powder | SMT
 | 744373965470 | WE-LHMI | 1365 | https://www.we-online.com/katalog/en/datasheet/744373965470 | Single | 4.7e-05 | 0.0746 | 4.4 | 13.1 | 3800000 | 120 | 0.0135 | 0.0125 | 0.0065 | 125 | Shielded | 1 | FALSE | Iron Powder | SMT
 | 7447471470 | WE-TIS | 1111 | https://www.we-online.com/katalog/en/datasheet/7447471470 | Single | 4.7e-05 | 0.086 | 2.3 | 3 | 6450000 | 120 | 0.0105 | 0.0105 | 0.0115 | 125 | Shielded | 1 | FALSE | NiZn | THT
 | 744873470 | WE-DD | 1280 | https://www.we-online.com/katalog/en/datasheet/744873470 | Coupled | 4.7e-05 | 0.11 | 2.02 | 3.1 |  | 80 | 0.012 | 0.012 | 0.0085 | 125 | Shielded | No | FALSE | NiZn | SMT
 | 744870470 | WE-DD | 1280 | https://www.we-online.com/katalog/en/datasheet/744870470 | Coupled | 4.7e-05 | 0.125 | 1.45 | 3.1 |  | 80 | 0.012 | 0.012 | 0.0085 | 125 | Shielded | No | FALSE | NiZn | SMT
 | 7448709470 | WE-DD | 1210 | https://www.we-online.com/katalog/en/datasheet/7448709470 | Coupled | 4.7e-05 | 0.106 | 1.9 | 3.6 |  | 80 | 0.012 | 0.012 | 0.0105 | 125 | Shielded | No | FALSE | NiZn | SMT
 | 7447706470 | WE-PD | 1260 | https://www.we-online.com/katalog/en/datasheet/7447706470 | Single | 4.7e-05 | 0.0612 | 2.7 | 3.6 | 7500000 | 120 | 0.012 | 0.012 | 0.006 | 150 | Shielded | 1 | FALSE | MnZn / NiZn | SMT
 | 7448990470 | WE-MCRI | 1090 | https://www.we-online.com/katalog/en/datasheet/7448990470 | Coupled | 4.7e-05 | 0.216 | 2.3 | 6 | 4500000 | 60 | 0.011 | 0.0102 | 0.009 | 125 | Shielded | No | FALSE | Iron Powder | SMT
 | 7448991470 | WE-MCRI | 1040 | https://www.we-online.com/katalog/en/datasheet/7448991470 | Coupled | 4.7e-05 | 0.312 | 1.5 | 4.4 | 3900000 | 60 | 0.011 | 0.0102 | 0.0041 | 125 | Shielded | No | FALSE | Iron Powder | SMT
 | 7448992470 | WE-MCRI | 1090HL | https://www.we-online.com/katalog/en/datasheet/7448992470 | Coupled | 4.7e-05 | 0.206 | 2.9 | 4.5 | 4100000 | 60 | 0.0115 | 0.01 | 0.009 | 125 | Shielded | No | FALSE | Metal Alloy | SMT
 | 784373680470 | WE-LHCA | 1040 | https://www.we-online.com/katalog/en/datasheet/784373680470 | Single | 4.7e-05 | 0.14 | 3.4 | 5.85 | 5143730 | 120 | 0.01085 | 0.01 | 0.004 | 155 | Shielded | 0 | TRUE | Metal Alloy | SMT
 | 784373170470 | WE-LHCA | 1770 | https://www.we-online.com/katalog/en/datasheet/784373170470 | Single | 4.7e-05 | 0.048 | 7.5 | 13.05 | 3159400 | 120 | 0.01745 | 0.01695 | 0.007 | 155 | Shielded | 0 | TRUE | Metal Alloy | SMT
 | 784373865470 | WE-LHCA | 1365 | https://www.we-online.com/katalog/en/datasheet/784373865470 | Single | 4.7e-05 | 0.072 | 5.1 | 6.5 | 4566400 | 120 | 0.01345 | 0.0126 | 0.0065 | 155 | Shielded | 0 | TRUE | Metal Alloy | SMT
 | 7843763540470 | WE-HCFAT | 3540 | https://www.we-online.com/katalog/en/datasheet/7843763540470 | Single | 4.7e-05 | 0.00567 | 32 | 31 | 7737927.104 | 80 | 0.0315 | 0.036 | 0.041 | 150 | Shielded | 1 | TRUE | MnZn | THT
 | 744770139 | WE-PD | 1280 | https://www.we-online.com/katalog/en/datasheet/744770139 | Single | 3.9e-05 | 0.047 | 3.3 | 3.6 | 8200000 | 120 | 0.012 | 0.012 | 0.008 | 125 | Shielded | 1 | TRUE | NiZn | SMT
 | 7447709390 | WE-PD | 1210 | https://www.we-online.com/katalog/en/datasheet/7447709390 | Single | 3.9e-05 | 0.0439 | 4.1 | 5 | 6000000 | 120 | 0.012 | 0.012 | 0.01 | 125 | Shielded | 1 | TRUE | NiZn | SMT
 | 74437636353703 | WE-HCFT | 3635 | https://www.we-online.com/katalog/en/datasheet/74437636353703 | Single | 3.7e-05 | 0.00319 | 32.8 | 56.3 | 8874514.926 | 400 | 0.036 | 0.0357 | 0.0342 | 155 | Shielded | 0 | FALSE | Metal Alloy | THT
 | 744771133 | WE-PD | 1260 | https://www.we-online.com/katalog/en/datasheet/744771133 | Single | 3.3e-05 | 0.049 | 2.8 | 3 | 10000000 | 120 | 0.012 | 0.012 | 0.006 | 125 | Shielded | 1 | FALSE | NiZn | SMT
 | 744770133 | WE-PD | 1280 | https://www.we-online.com/katalog/en/datasheet/744770133 | Single | 3.3e-05 | 0.044 | 3.6 | 3.9 | 8500000 | 120 | 0.012 | 0.012 | 0.008 | 125 | Shielded | 1 | TRUE | NiZn | SMT
 | 7447707330 | WE-PD | 1280 | https://www.we-online.com/katalog/en/datasheet/7447707330 | Single | 3.3e-05 | 0.0465 | 3.15 | 6.1 | 8300000 | 120 | 0.012 | 0.012 | 0.008 | 150 | Shielded | 1 | FALSE | MnZn / NiZn | SMT
 | 7447709330 | WE-PD | 1210 | https://www.we-online.com/katalog/en/datasheet/7447709330 | Single | 3.3e-05 | 0.0368 | 4.2 | 5.5 | 8500000 | 120 | 0.012 | 0.012 | 0.01 | 125 | Shielded | 1 | TRUE | NiZn | SMT
 | 7447704330 | WE-PD | 1510 | https://www.we-online.com/katalog/en/datasheet/7447704330 | Single | 3.3e-05 | 0.035 | 5.2 | 6 | 8000000 | 120 | 0.015 | 0.0155 | 0.0095 | 125 | Shielded | 1 | FALSE | NiZn | SMT
 | 7443551331 | WE-HCI | 1365 | https://www.we-online.com/katalog/en/datasheet/7443551331 | Single | 3.3e-05 | 0.0305 | 6.6 | 5.5 | 11000000 | 80 | 0.0132 | 0.0128 | 0.0065 | 155 | Shielded | 1 | FALSE | WE-PERM | SMT
 | 74435573300 | WE-HCI | 1890 | https://www.we-online.com/katalog/en/datasheet/74435573300 | Single | 3.3e-05 | 0.0217 | 8.7 | 9 | 9500000 | 80 | 0.0183 | 0.0182 | 0.0092 | 125 | Shielded | 1 | FALSE | MnZn | SMT
 | 74435583300 | WE-HCI | 2212 | https://www.we-online.com/katalog/en/datasheet/74435583300 | Single | 3.3e-05 | 0.0132 | 10.6 | 15 | 8000000 | 80 | 0.0225 | 0.022 | 0.0124 | 125 | Shielded | 1 | FALSE | MnZn | SMT
 | 7443633300 | WE-HCF | 2013 | https://www.we-online.com/katalog/en/datasheet/7443633300 | Single | 3.3e-05 | 0.0114 | 13.3 | 11 | 11199341.15 | 150 | 0.0208 | 0.0205 | 0.0145 | 125 | Shielded | 1 | FALSE | MnZn | SMT
 | 74436413300 | WE-HCF | 2815 | https://www.we-online.com/katalog/en/datasheet/74436413300 | Single | 3.3e-05 | 0.00133 | 44 | 6 | 6290000 | 250 | 0.0274 | 0.0191 | 0.0154 | 125 | Shielded | 1 | FALSE | MnZn | SMT
 | 7443643300 | WE-HCF | 2818 | https://www.we-online.com/katalog/en/datasheet/7443643300 | Single | 3.3e-05 | 0.0024 | 34.95 | 11.5 | 7000000 | 250 | 0.0274 | 0.0191 | 0.0185 | 125 | Shielded | 1 | FALSE | MnZn | SMT
 | 7443783533330 | WE-HCFT | 3533 | https://www.we-online.com/katalog/en/datasheet/7443783533330 | Single | 3.3e-05 | 0.009 | 22 | 39.2 | 6081000 | 250 | 0.0345 | 0.036 | 0.035 | 125 | Shielded | 1 | FALSE | MnZn | THT
 | 7443763540330 | WE-HCFT | 3540 | https://www.we-online.com/katalog/en/datasheet/7443763540330 | Single | 3.3e-05 | 0.00567 | 32 | 38.9 | 6836000 | 250 | 0.041 | 0.036 | 0.035 | 125 | Shielded | 1 | FALSE | MnZn | THT
 | 78439370330 | WE-XHMA | 1510 | https://www.we-online.com/katalog/en/datasheet/78439370330 | Single | 3.3e-05 | 0.018 | 10.8 | 18.15 | 5000000 | 120 | 0.0164 | 0.0154 | 0.011 | 125 | Shielded | 1 | TRUE | Hyperflux | SMT
 | 74439369330 | WE-XHMI | 1090 | https://www.we-online.com/katalog/en/datasheet/74439369330 | Single | 3.3e-05 | 0.0362 | 7.1 | 11.7 | 7000000 | 120 | 0.0116 | 0.0105 | 0.0091 | 125 | Shielded | 1 | FALSE | Hyperflux | SMT
 | 74439370330 | WE-XHMI | 1510 | https://www.we-online.com/katalog/en/datasheet/74439370330 | Single | 3.3e-05 | 0.018 | 10.8 | 18.15 | 5000000 | 120 | 0.0164 | 0.0154 | 0.011 | 125 | Shielded | 1 | FALSE | Hyperflux | SMT
 | 74437349330 | WE-LHMI | 7050 | https://www.we-online.com/katalog/en/datasheet/74437349330 | Single | 3.3e-05 | 0.173 | 2.45 | 4.75 | 7360000 | 120 | 0.0073 | 0.0066 | 0.005 | 125 | Shielded | 1 | FALSE | Iron Powder | SMT
 | 74437368330 | WE-LHMI | 1040 | https://www.we-online.com/katalog/en/datasheet/74437368330 | Single | 3.3e-05 | 0.092 | 3.75 | 7.4 | 6000000 | 120 | 0.011 | 0.01 | 0.0042 | 125 | Shielded | 1 | FALSE | Iron Powder | SMT
 | 744373965330 | WE-LHMI | 1365 | https://www.we-online.com/katalog/en/datasheet/744373965330 | Single | 3.3e-05 | 0.0487 | 5.45 | 13.2 | 4400000 | 120 | 0.0135 | 0.0125 | 0.0065 | 125 | Shielded | 1 | FALSE | Iron Powder | SMT
 | 7447471330 | WE-TIS | 1111 | https://www.we-online.com/katalog/en/datasheet/7447471330 | Single | 3.3e-05 | 0.057 | 3 | 3.6 | 9850000 | 120 | 0.0105 | 0.0105 | 0.0115 | 125 | Shielded | 1 | FALSE | NiZn | THT
 | 744873330 | WE-DD | 1280 | https://www.we-online.com/katalog/en/datasheet/744873330 | Coupled | 3.3e-05 | 0.087 | 2.25 | 3.9 |  | 80 | 0.012 | 0.012 | 0.0085 | 125 | Shielded | No | FALSE | NiZn | SMT
 | 7448709330 | WE-DD | 1210 | https://www.we-online.com/katalog/en/datasheet/7448709330 | Coupled | 3.3e-05 | 0.08 | 2 | 4.4 |  | 80 | 0.012 | 0.012 | 0.0105 | 125 | Shielded | No | FALSE | NiZn | SMT
 | 74437429203330 | WE-HCF | 2920 Litz | https://www.we-online.com/katalog/en/datasheet/74437429203330 | Single | 3.3e-05 | 0.0153 | 13.25 | 16.3 | 7999000 | 250 | 0.025 | 0.028 | 0.0205 | 125 | Shielded | 1 | FALSE | MnZn | SMT
 | 74437529203330 | WE-HCF | 2920 Round | https://www.we-online.com/katalog/en/datasheet/74437529203330 | Single | 3.3e-05 | 0.0069 | 20.05 | 15.4 | 7079000 | 250 | 0.025 | 0.028 | 0.0205 | 125 | Shielded | 1 | FALSE | MnZn | SMT
 | 7447706330 | WE-PD | 1260 | https://www.we-online.com/katalog/en/datasheet/7447706330 | Single | 3.3e-05 | 0.0508 | 3 | 4.2 | 9200000 | 120 | 0.012 | 0.012 | 0.006 | 150 | Shielded | 1 | FALSE | MnZn / NiZn | SMT
 | 7448990330 | WE-MCRI | 1090 | https://www.we-online.com/katalog/en/datasheet/7448990330 | Coupled | 3.3e-05 | 0.13 | 2.9 | 6.8 | 5500000 | 60 | 0.011 | 0.0102 | 0.009 | 125 | Shielded | No | FALSE | Iron Powder | SMT
 | 7448991330 | WE-MCRI | 1040 | https://www.we-online.com/katalog/en/datasheet/7448991330 | Coupled | 3.3e-05 | 0.207 | 2.05 | 5 | 4700000 | 60 | 0.011 | 0.0102 | 0.0041 | 125 | Shielded | No | FALSE | Iron Powder | SMT
 | 7448992330 | WE-MCRI | 1090HL | https://www.we-online.com/katalog/en/datasheet/7448992330 | Coupled | 3.3e-05 | 0.128 | 3.6 | 6.4 | 5200000 | 60 | 0.0115 | 0.01 | 0.009 | 125 | Shielded | No | FALSE | Metal Alloy | SMT
 | 784373680330 | WE-LHCA | 1040 | https://www.we-online.com/katalog/en/datasheet/784373680330 | Single | 3.3e-05 | 0.087 | 4.1 | 6.5 | 6153400 | 120 | 0.01085 | 0.01 | 0.004 | 155 | Shielded | 0 | TRUE | Metal Alloy | SMT
 | 784373170330 | WE-LHCA | 1770 | https://www.we-online.com/katalog/en/datasheet/784373170330 | Single | 3.3e-05 | 0.03 | 9.1 | 15.6 | 3830300 | 120 | 0.01745 | 0.01695 | 0.007 | 155 | Shielded | 0 | TRUE | Metal Alloy | SMT
 | 784373865330 | WE-LHCA | 1365 | https://www.we-online.com/katalog/en/datasheet/784373865330 | Single | 3.3e-05 | 0.06 | 5.7 | 8.45 | 5951470 | 120 | 0.01345 | 0.0126 | 0.0065 | 155 | Shielded | 0 | TRUE | Metal Alloy | SMT
 | 7843763540330 | WE-HCFAT | 3540 | https://www.we-online.com/katalog/en/datasheet/7843763540330 | Single | 3.3e-05 | 0.00567 | 32 | 38.9 | 8933959.212 | 80 | 0.0315 | 0.036 | 0.041 | 150 | Shielded | 1 | TRUE | MnZn | THT
 | 74437632313002 | WE-HCFT | 3231 | https://www.we-online.com/katalog/en/datasheet/74437632313002 | Single | 3e-05 | 0.00242 | 30.8 | 48.7 | 11377905.18 | 300 | 0.032 | 0.032 | 0.03 | 155 | Shielded | 0 | FALSE | Metal Alloy | THT
 | 74437632313003 | WE-HCFT | 3231 | https://www.we-online.com/katalog/en/datasheet/74437632313003 | Single | 3e-05 | 0.00311 | 32.2 | 62.6 | 9573314.142 | 300 | 0.0322 | 0.0315 | 0.0305 | 155 | Shielded | 0 | FALSE | Metal Alloy | THT
 | 7447714270 | WE-PD | 1050 | https://www.we-online.com/katalog/en/datasheet/7447714270 | Single | 2.7e-05 | 0.063 | 2.6 | 3.4 | 13966934.87 | 120 | 0.01 | 0.01 | 0.005 | 150 | Shielded | 1 | FALSE | MnZn / NiZn | SMT
 | 744771127 | WE-PD | 1260 | https://www.we-online.com/katalog/en/datasheet/744771127 | Single | 2.7e-05 | 0.037 | 3.3 | 3.5 | 11600000 | 120 | 0.012 | 0.012 | 0.006 | 125 | Shielded | 1 | FALSE | NiZn | SMT
 | 744770127 | WE-PD | 1280 | https://www.we-online.com/katalog/en/datasheet/744770127 | Single | 2.7e-05 | 0.031 | 4.2 | 4.3 | 10000000 | 120 | 0.012 | 0.012 | 0.008 | 125 | Shielded | 1 | TRUE | NiZn | SMT
 | 7447709270 | WE-PD | 1210 | https://www.we-online.com/katalog/en/datasheet/7447709270 | Single | 2.7e-05 | 0.03 | 4.6 | 5.8 | 8000000 | 120 | 0.012 | 0.012 | 0.01 | 125 | Shielded | 1 | TRUE | NiZn | SMT
 | 7447798271 | WE-PDF | 1064 | https://www.we-online.com/katalog/en/datasheet/7447798271 | Single | 2.7e-05 | 0.0376 | 4.3 | 3.1 | 15000000 | 120 | 0.0102 | 0.0102 | 0.0064 | 150 | Shielded | No | FALSE | NiZn | SMT
 | 7447714270 | WE-PD | 1050 | https://www.we-online.com/katalog/en/datasheet/7447714270 | Single | 2.7e-05 | 0.063 | 2.6 | 3.4 | 13966934.87 | 120 | 0.01 | 0.01 | 0.005 | 150 | Shielded | 1 | FALSE | MnZn / NiZn | SMT
 | 744771127 | WE-PD | 1260 | https://www.we-online.com/katalog/en/datasheet/744771127 | Single | 2.7e-05 | 0.037 | 3.3 | 3.5 | 11600000 | 120 | 0.012 | 0.012 | 0.006 | 125 | Shielded | 1 | FALSE | NiZn | SMT
 | 744770127 | WE-PD | 1280 | https://www.we-online.com/katalog/en/datasheet/744770127 | Single | 2.7e-05 | 0.031 | 4.2 | 4.3 | 10000000 | 120 | 0.012 | 0.012 | 0.008 | 125 | Shielded | 1 | TRUE | NiZn | SMT
 | 7447709270 | WE-PD | 1210 | https://www.we-online.com/katalog/en/datasheet/7447709270 | Single | 2.7e-05 | 0.03 | 4.6 | 5.8 | 8000000 | 120 | 0.012 | 0.012 | 0.01 | 125 | Shielded | 1 | TRUE | NiZn | SMT
 | 7447798271 | WE-PDF | 1064 | https://www.we-online.com/katalog/en/datasheet/7447798271 | Single | 2.7e-05 | 0.0376 | 4.3 | 3.1 | 15000000 | 120 | 0.0102 | 0.0102 | 0.0064 | 150 | Shielded | No | FALSE | NiZn | SMT
 | 74437636352702 | WE-HCFT | 3635 | https://www.we-online.com/katalog/en/datasheet/74437636352702 | Single | 2.7e-05 | 0.00148 | 49.3 | 52.1 | 10334001.37 | 400 | 0.036 | 0.0357 | 0.0342 | 155 | Shielded | 0 | FALSE | Metal Alloy | THT
 | 7447798241 | WE-PDF | 1064 | https://www.we-online.com/katalog/en/datasheet/7447798241 | Single | 2.4e-05 | 0.035 | 4.5 | 3.25 | 16000000 | 120 | 0.0102 | 0.0102 | 0.0064 | 150 | Shielded | No | FALSE | NiZn | SMT
 | 74404084220 | WE-LQS | 8040 | https://www.we-online.com/katalog/en/datasheet/74404084220 | Single | 2.2e-05 | 0.069 | 2.1 | 3 | 15000000 | 120 | 0.008 | 0.008 | 0.0042 | 125 | Semi Shielded | 1 | FALSE | NiZn | SMT
 | 744874220 | WE-DD | 1260 | https://www.we-online.com/katalog/en/datasheet/744874220 | Coupled | 2.2e-05 | 0.067 | 2.47 | 3.3 |  | 80 | 0.012 | 0.012 | 0.0065 | 125 | Shielded | No | FALSE | NiZn | SMT
 | 74441521220 | WE-HIDA | 1521 | https://www.we-online.com/katalog/en/datasheet/74441521220 | Dual | 2.2e-05 | 0.0136 | 7 | 7 | 11571966.91 | 80 | 0.0145 | 0.021 | 0.0152 | 125 | Shielded | 1 | FALSE | MnZn | THT
 | 7447714220 | WE-PD | 1050 | https://www.we-online.com/katalog/en/datasheet/7447714220 | Single | 2.2e-05 | 0.042 | 3 | 3.6 | 14500000 | 120 | 0.01 | 0.01 | 0.005 | 150 | Shielded | 1 | FALSE | MnZn / NiZn | SMT
 | 7447715220 | WE-PD | 1245 | https://www.we-online.com/katalog/en/datasheet/7447715220 | Single | 2.2e-05 | 0.045 | 2.9 | 3.1 | 15500000 | 120 | 0.012 | 0.012 | 0.0045 | 125 | Shielded | 1 | FALSE | NiZn | SMT
 | 744771122 | WE-PD | 1260 | https://www.we-online.com/katalog/en/datasheet/744771122 | Single | 2.2e-05 | 0.03 | 3.5 | 3.7 | 13000000 | 120 | 0.012 | 0.012 | 0.006 | 125 | Shielded | 1 | FALSE | NiZn | SMT
 | 744770122 | WE-PD | 1280 | https://www.we-online.com/katalog/en/datasheet/744770122 | Single | 2.2e-05 | 0.029 | 4.6 | 5 | 12000000 | 120 | 0.012 | 0.012 | 0.008 | 125 | Shielded | 1 | TRUE | NiZn | SMT
 | 7447707220 | WE-PD | 1280 | https://www.we-online.com/katalog/en/datasheet/7447707220 | Single | 2.2e-05 | 0.0315 | 4 | 7.4 | 10200000 | 120 | 0.012 | 0.012 | 0.008 | 150 | Shielded | 1 | FALSE | MnZn / NiZn | SMT
 | 7447709220 | WE-PD | 1210 | https://www.we-online.com/katalog/en/datasheet/7447709220 | Single | 2.2e-05 | 0.0233 | 5.3 | 6.5 | 10000000 | 120 | 0.012 | 0.012 | 0.01 | 125 | Shielded | 1 | TRUE | NiZn | SMT
 | 7447704220 | WE-PD | 1510 | https://www.we-online.com/katalog/en/datasheet/7447704220 | Single | 2.2e-05 | 0.025 | 6.2 | 7.2 | 11500000 | 120 | 0.015 | 0.0155 | 0.0095 | 125 | Shielded | 1 | FALSE | NiZn | SMT
 | 7447798221 | WE-PDF | 1064 | https://www.we-online.com/katalog/en/datasheet/7447798221 | Single | 2.2e-05 | 0.033 | 4.7 | 3.5 | 17000000 | 120 | 0.0102 | 0.0102 | 0.0064 | 150 | Shielded | No | FALSE | NiZn | SMT
 | 7443551221 | WE-HCI | 1365 | https://www.we-online.com/katalog/en/datasheet/7443551221 | Single | 2.2e-05 | 0.0247 | 7.1 | 6.5 | 14000000 | 80 | 0.0132 | 0.0128 | 0.0065 | 155 | Shielded | 1 | FALSE | WE-PERM | SMT
 | 74435572200 | WE-HCI | 1890 | https://www.we-online.com/katalog/en/datasheet/74435572200 | Single | 2.2e-05 | 0.0146 | 10.9 | 11 | 10500000 | 80 | 0.0183 | 0.0182 | 0.0092 | 125 | Shielded | 1 | FALSE | MnZn | SMT
 | 74435582200 | WE-HCI | 2212 | https://www.we-online.com/katalog/en/datasheet/74435582200 | Single | 2.2e-05 | 0.007 | 15.6 | 18 | 8500000 | 80 | 0.0225 | 0.022 | 0.0124 | 125 | Shielded | 1 | FALSE | MnZn | SMT
 | 7443632200 | WE-HCF | 2013 | https://www.we-online.com/katalog/en/datasheet/7443632200 | Single | 2.2e-05 | 0.01065 | 13.8 | 15 | 15500553.5 | 150 | 0.0208 | 0.0205 | 0.0145 | 125 | Shielded | 1 | FALSE | MnZn | SMT
 | 74436412200 | WE-HCF | 2815 | https://www.we-online.com/katalog/en/datasheet/74436412200 | Single | 2.2e-05 | 0.00133 | 44 | 9.5 | 8060000 | 250 | 0.0274 | 0.0191 | 0.0154 | 125 | Shielded | 1 | FALSE | MnZn | SMT
 | 7443642200 | WE-HCF | 2818 | https://www.we-online.com/katalog/en/datasheet/7443642200 | Single | 2.2e-05 | 0.0024 | 34.95 | 18 | 9000000 | 250 | 0.0274 | 0.0191 | 0.0185 | 125 | Shielded | 1 | FALSE | MnZn | SMT
 | 7443783533220 | WE-HCFT | 3533 | https://www.we-online.com/katalog/en/datasheet/7443783533220 | Single | 2.2e-05 | 0.008 | 23.2 | 49.4 | 8147000 | 250 | 0.0345 | 0.036 | 0.035 | 125 | Shielded | 1 | FALSE | MnZn | THT
 | 7443763540220 | WE-HCFT | 3540 | https://www.we-online.com/katalog/en/datasheet/7443763540220 | Single | 2.2e-05 | 0.00263 | 40.6 | 42 | 9157000 | 250 | 0.041 | 0.036 | 0.035 | 125 | Shielded | 1 | FALSE | MnZn | THT
 | 78439370220 | WE-XHMA | 1510 | https://www.we-online.com/katalog/en/datasheet/78439370220 | Single | 2.2e-05 | 0.0125 | 13.35 | 22.35 | 7000000 | 120 | 0.0164 | 0.0154 | 0.01 | 125 | Shielded | 1 | TRUE | Hyperflux | SMT
 | 744393305220 | WE-XHMI | 5050 | https://www.we-online.com/katalog/en/datasheet/744393305220 | Single | 2.2e-05 | 0.075 | 3.5 | 4 | 10000000 | 80 | 0.00555 | 0.00535 | 0.0051 | 125 | Shielded | 1 | FALSE | Hyperflux | SMT
 | 74439358220 | WE-XHMI | 8080 | https://www.we-online.com/katalog/en/datasheet/74439358220 | Single | 2.2e-05 | 0.0307 | 7.1 | 8.3 | 8000000 | 120 | 0.0088 | 0.0083 | 0.008 | 125 | Shielded | 1 | FALSE | Hyperflux | SMT
 | 74439369220 | WE-XHMI | 1090 | https://www.we-online.com/katalog/en/datasheet/74439369220 | Single | 2.2e-05 | 0.021 | 9.7 | 13.8 | 8000000 | 120 | 0.0116 | 0.0105 | 0.0091 | 125 | Shielded | 1 | FALSE | Hyperflux | SMT
 | 74439370220 | WE-XHMI | 1510 | https://www.we-online.com/katalog/en/datasheet/74439370220 | Single | 2.2e-05 | 0.0125 | 13.35 | 22.35 | 7000000 | 120 | 0.0164 | 0.0154 | 0.01 | 125 | Shielded | 1 | FALSE | Hyperflux | SMT
 | 744393605220 | WE-XHMI P | 1010 | https://www.we-online.com/katalog/en/datasheet/744393605220 | Single | 2.2e-05 | 0.0187 | 11.6 | 15.5 | 6000000 | 120 | 0.0113 | 0.01 | 0.01 | 150 | Shielded | 0 | FALSE | Metal Alloy | SMT
 | 744393465220 | WE-XHMI P | 6060 | https://www.we-online.com/katalog/en/datasheet/744393465220 | Single | 2.2e-05 | 0.042 | 5.3 | 6.7 | 8000000 | 80 | 0.0066 | 0.0064 | 0.0061 | 150 | Shielded | 0 | FALSE | Metal Alloy | SMT
 | 74437346220 | WE-LHMI | 7030 | https://www.we-online.com/katalog/en/datasheet/74437346220 | Single | 2.2e-05 | 0.165 | 2.5 | 5.95 | 9920000 | 120 | 0.0073 | 0.0066 | 0.003 | 125 | Shielded | 1 | FALSE | Iron Powder | SMT
 | 74437349220 | WE-LHMI | 7050 | https://www.we-online.com/katalog/en/datasheet/74437349220 | Single | 2.2e-05 | 0.14 | 2.75 | 8.5 | 7920000 | 120 | 0.0073 | 0.0066 | 0.005 | 125 | Shielded | 1 | FALSE | Iron Powder | SMT
 | 74437368220 | WE-LHMI | 1040 | https://www.we-online.com/katalog/en/datasheet/74437368220 | Single | 2.2e-05 | 0.064 | 4.5 | 10.8 | 7000000 | 120 | 0.011 | 0.01 | 0.0042 | 125 | Shielded | 1 | FALSE | Iron Powder | SMT
 | 744373965220 | WE-LHMI | 1365 | https://www.we-online.com/katalog/en/datasheet/744373965220 | Single | 2.2e-05 | 0.0345 | 6.5 | 13.9 | 5400000 | 120 | 0.0135 | 0.0125 | 0.0065 | 125 | Shielded | 1 | FALSE | Iron Powder | SMT
 | 744750460220 | WE-FAMI | 1215 | https://www.we-online.com/katalog/en/datasheet/744750460220 | Single | 2.2e-05 | 0.0124 | 6.9 | 7.5 | 10300000 | 80 | 0.0128 | 0.0128 | 0.0158 | 125 | Shielded | No | FALSE | Ferrite / Metal Alloy | THT
 | 744750420220 | WE-FAMI | 1280 | https://www.we-online.com/katalog/en/datasheet/744750420220 | Single | 2.2e-05 | 0.0309 | 4.1 | 6.7 | 12137564.06 | 80 | 0.0128 | 0.0128 | 0.009 | 125 | Shielded | No | FALSE | Ferrite / Metal Alloy | THT
 | 744750560220 | WE-FAMI | 1415 | https://www.we-online.com/katalog/en/datasheet/744750560220 | Single | 2.2e-05 | 0.0126 | 7.7 | 8.9 | 8946627.781 | 80 | 0.0148 | 0.0148 | 0.0158 | 125 | Shielded | No | FALSE | Ferrite / Metal Alloy | THT
 | 7447720220 | WE-TI | 8095 | https://www.we-online.com/katalog/en/datasheet/7447720220 | Single | 2.2e-05 | 0.046 | 3 | 3.3 | 13176776.86 | 120 | 0.0078 | 0.0078 | 0.01 | 125 | Unshielded | No | FALSE | NiZn | THT
 | 7447471220 | WE-TIS | 1111 | https://www.we-online.com/katalog/en/datasheet/7447471220 | Single | 2.2e-05 | 0.035 | 3.8 | 4.4 | 16270000 | 120 | 0.0105 | 0.0105 | 0.0115 | 125 | Shielded | 1 | FALSE | NiZn | THT
 | 78404084220 | WE-LQSA | 8040 | https://www.we-online.com/katalog/en/datasheet/78404084220 | Single | 2.2e-05 | 0.071 | 3.2 | 3.2 | 14626963.27 | 120 | 0.008 | 0.008 | 0.0042 | 150 | Semi Shielded | 0 | TRUE | NiZn | SMT
 | 7847714220 | WE-PDA | 1050 | https://www.we-online.com/katalog/en/datasheet/7847714220 | Single | 2.2e-05 | 0.048 | 3.22 | 3.4 |  |  | 0.01 | 0.01 | 0.005 | 150 | Shielded | 0 | TRUE | MnZn / NiZn | SMT
 | 784771220 | WE-PDA | 1260 | https://www.we-online.com/katalog/en/datasheet/784771220 | Single | 2.2e-05 | 0.0335 | 3.2 | 3.5 | 14922129.8 | 80 | 0.012 | 0.012 | 0.0063 | 125 | Shielded | 1 | TRUE | NiZn | SMT
 | 7448709220 | WE-DD | 1210 | https://www.we-online.com/katalog/en/datasheet/7448709220 | Coupled | 2.2e-05 | 0.064 | 3.5 | 5 |  | 80 | 0.012 | 0.012 | 0.0105 | 125 | Shielded | No | FALSE | NiZn | SMT
 | 744873220 | WE-DD | 1280 | https://www.we-online.com/katalog/en/datasheet/744873220 | Coupled | 2.2e-05 | 0.058 | 2.79 | 5 |  | 80 | 0.012 | 0.012 | 0.0085 | 125 | Shielded | No | FALSE | NiZn | SMT
 | 744871220 | WE-DD | 1260 | https://www.we-online.com/katalog/en/datasheet/744871220 | Coupled | 2.2e-05 | 0.067 | 1.85 | 3 |  | 80 | 0.012 | 0.012 | 0.0065 | 125 | Shielded | No | FALSE | NiZn | SMT
 | 744870220 | WE-DD | 1280 | https://www.we-online.com/katalog/en/datasheet/744870220 | Coupled | 2.2e-05 | 0.062 | 2.45 | 5.2 |  | 80 | 0.012 | 0.012 | 0.0085 | 125 | Shielded | No | FALSE | NiZn | SMT
 | 74437529203220 | WE-HCF | 2920 Round | https://www.we-online.com/katalog/en/datasheet/74437529203220 | Single | 2.2e-05 | 0.0049 | 24.05 | 21.7 | 9000000 | 250 | 0.025 | 0.028 | 0.0205 | 125 | Shielded | 1 | FALSE | MnZn | SMT
 | 7447706220 | WE-PD | 1260 | https://www.we-online.com/katalog/en/datasheet/7447706220 | Single | 2.2e-05 | 0.0343 | 3.7 | 5.2 | 11000000 | 120 | 0.012 | 0.012 | 0.006 | 150 | Shielded | 1 | FALSE | MnZn / NiZn | SMT
 | 7448990220 | WE-MCRI | 1090 | https://www.we-online.com/katalog/en/datasheet/7448990220 | Coupled | 2.2e-05 | 0.095 | 3.4 | 8.1 | 6500000 | 60 | 0.011 | 0.0102 | 0.009 | 125 | Shielded | No | FALSE | Iron Powder | SMT
 | 7448991220 | WE-MCRI | 1040 | https://www.we-online.com/katalog/en/datasheet/7448991220 | Coupled | 2.2e-05 | 0.144 | 2.2 | 6.1 | 5800000 | 60 | 0.011 | 0.0102 | 0.0041 | 125 | Shielded | No | FALSE | Iron Powder | SMT
 | 7448992220 | WE-MCRI | 1090HL | https://www.we-online.com/katalog/en/datasheet/7448992220 | Coupled | 2.2e-05 | 0.093 | 4.2 | 7.7 | 7200000 | 60 | 0.0115 | 0.01 | 0.009 | 125 | Shielded | No | FALSE | Metal Alloy | SMT
 | 7444211415220 | WE-HIDA | 1415 | https://www.we-online.com/katalog/en/datasheet/7444211415220 | Dual | 2.2e-05 | 0.0148 | 5.7 | 7 | 10870906.08 | 80 | 0.014 | 0.0155 | 0.016 | 125 | Shielded | 1 | FALSE | MnZn | THT
 | 7444011480220 | WE-HIDA | 1480 | https://www.we-online.com/katalog/en/datasheet/7444011480220 | Single | 2.2e-05 | 0.01 | 8 | 6.5 | 10442773.15 | 80 | 0.014 | 0.008 | 0.016 | 125 | Shielded | 1 | FALSE | MnZn | THT
 | 7444011715220 | WE-HIDA | 1715 | https://www.we-online.com/katalog/en/datasheet/7444011715220 | Single | 2.2e-05 | 0.007 | 10 | 12 | 12755364.69 | 80 | 0.0175 | 0.015 | 0.0195 | 125 | Shielded | 1 | FALSE | MnZn | THT
 | 7444013119220 | WE-HIDA | 3119 | https://www.we-online.com/katalog/en/datasheet/7444013119220 | Single | 2.2e-05 | 0.0053 | 10 | 33 | 10273407.4 | 80 | 0.031 | 0.019 | 0.035 | 125 | Shielded | 1 | FALSE | MnZn | THT
 | 74434301008220 | WE-LHMD | 1008 | https://www.we-online.com/katalog/en/datasheet/74434301008220 | Dual | 2.2e-05 | 0.104 | 3.473 | 13 | 6429958.632 | 120 | 0.011 | 0.01 | 0.0042 | 125 | Shielded | 1 | TRUE | Iron Powder | SMT
 | 74434301213220 | WE-LHMD | 1213 | https://www.we-online.com/katalog/en/datasheet/74434301213220 | Dual | 2.2e-05 | 0.05 | 5.337 | 15 | 5612028.406 | 120 | 0.0138 | 0.01285 | 0.0065 | 125 | Shielded | 1 | TRUE | Iron Powder | SMT
 | 74437632312202 | WE-HCFT | 3231 | https://www.we-online.com/katalog/en/datasheet/74437632312202 | Single | 2.2e-05 | 0.00181 | 36.9 | 56.2 | 12795025.64 | 300 | 0.032 | 0.032 | 0.03 | 155 | Shielded | 0 | FALSE | Metal Alloy | THT
 | 784373680220 | WE-LHCA | 1040 | https://www.we-online.com/katalog/en/datasheet/784373680220 | Single | 2.2e-05 | 0.059 | 5.2 | 7.5 | 7774500 | 120 | 0.01085 | 0.01 | 0.004 | 155 | Shielded | 0 | TRUE | Metal Alloy | SMT
 | 784373865220 | WE-LHCA | 1365 | https://www.we-online.com/katalog/en/datasheet/784373865220 | Single | 2.2e-05 | 0.035 | 7.1 | 10.75 | 5951470 | 120 | 0.01345 | 0.0126 | 0.0065 | 155 | Shielded | 0 | TRUE | Metal Alloy | SMT
 | 784373460220 | WE-LHCA | 7030 | https://www.we-online.com/katalog/en/datasheet/784373460220 | Single | 2.2e-05 | 0.163 | 2.5 | 4.5 | 10486400 | 120 | 0.00695 | 0.0066 | 0.003 | 155 | Shielded | 0 | TRUE | Metal Alloy | SMT
 | 784373170220 | WE-LHCA | 1770 | https://www.we-online.com/katalog/en/datasheet/784373170220 | Single | 2.2e-05 | 0.022 | 10.9 | 17.15 | 4941800 | 120 | 0.01745 | 0.01695 | 0.007 | 155 | Shielded | 0 | TRUE | Metal Alloy | SMT
 | 7843763540220 | WE-HCFAT | 3540 | https://www.we-online.com/katalog/en/datasheet/7843763540220 | Single | 2.2e-05 | 0.00263 | 40.6 | 42 | 10486423.83 | 80 | 0.0315 | 0.036 | 0.041 | 150 | Shielded | 1 | TRUE | MnZn | THT
 | 7447720200 | WE-TI | 8095 | https://www.we-online.com/katalog/en/datasheet/7447720200 | Single | 2e-05 | 0.044 | 3.1 | 3.5 | 15402000 | 120 | 0.0078 | 0.0078 | 0.01 | 125 | Unshielded | No | FALSE | NiZn | THT
 | 7843332000 | WE-CHSA | 1011 | https://www.we-online.com/katalog/en/datasheet/7843332000 | Single | 2e-05 | 0.0508 | 4.3 | 7 | 20754056.2 | 80 | 0.0106 | 0.0106 | 0.011 | 150 | Shielded | 0 | TRUE | MnZn | SMT
 | 7843322000 | WE-CHSA | 1212 | https://www.we-online.com/katalog/en/datasheet/7843322000 | Single | 2e-05 | 0.0359 | 5.4 | 7 | 18836000 | 80 | 0.0122 | 0.0122 | 0.01175 | 150 | Shielded | 0 | TRUE | MnZn | SMT
