ut-ras/rm_electrical-supercap_v2/Sims_and_Design/Inductor Design & Selection/Power_Inductor.xlsx

Search Type | Inductance Lower (μH) | Inductance Upper (μH)
Search for L @ I | 0.001 | 10000
Part Number | L nominal (μH) | Isat @ 25°C (A) | Irms 40°C rise @ 25°C (A) | DCR typ @ 25°C (mΩ) | Max Temp Rating (°C) | Voltage Rating (V) | Length (mm) | Width (mm) | Height (mm) | Mount | Shielded | Core material | AEC grade | Price ($)
XGL3020-101 | 0.1 | 14.8 | 28 | 2 | 165 | 80 | 3.2 | 3.2 | 2 | SM | Yes | Composite | 1 | $0.65
KTA3030-131 | 0.13 | 36 | 31.8 | 1.4 | 165 | 100 | 3.4 | 3.2 | 3.2 | SM | Yes | Composite | 1 | $0.67
KTA3030-241 | 0.24 | 26.5 | 23.6 | 2.5 | 165 | 100 | 3.4 | 3.2 | 3.2 | SM | Yes | Composite | 1 | $0.67
KTA3030-391 | 0.39 | 20 | 16.3 | 4.6 | 165 | 100 | 3.4 | 3.2 | 3.2 | SM | Yes | Composite | 1 | $0.67
KTA3030-400 | 0.04 | 56 | 41.6 | 0.83 | 165 | 100 | 3.4 | 3.2 | 3.2 | SM | Yes | Composite | 1 | $0.67
KTA3030-620 | 0.062 | 50 | 41.6 | 0.83 | 165 | 100 | 3.4 | 3.2 | 3.2 | SM | Yes | Composite | 1 | $0.67
KTA3030-820 | 0.082 | 46 | 31.8 | 1.4 | 165 | 100 | 3.4 | 3.2 | 3.2 | SM | Yes | Composite | 1 | $0.67
XGL3509-900 | 0.09 | 13.9 | 13.8 | 5.9 | 165 | 80 | 3.65 | 3.35 | 0.9 | SM | Yes | Composite | 1 | $0.63
XGL3510-900 | 0.09 | 14.7 | 17.4 | 4.5 | 165 | 80 | 3.65 | 3.35 | 1 | SM | Yes | Composite | 1 | $0.63
XEL3515-151 | 0.15 | 12.5 | 17.5 | 4.8 | 165 | 80 | 3.65 | 3.35 | 1.5 | SM | Yes | Composite | 1 | $0.66
XEL3515-720 | 0.072 | 16 | 23.6 | 2.9 | 165 | 80 | 3.65 | 3.35 | 1.5 | SM | Yes | Composite | 1 | $0.66
XGL3515-101 | 0.1 | 16.8 | 23.4 | 2.4 | 165 | 80 | 3.65 | 3.35 | 1.5 | SM | Yes | Composite | 1 | $0.63
XGL3515-181 | 0.18 | 12.4 | 20.4 | 3.5 | 165 | 80 | 3.65 | 3.35 | 1.5 | SM | Yes | Composite | 1 | $0.63
XGL3515-900 | 0.09 | 17.8 | 26.6 | 2.2 | 165 | 80 | 3.65 | 3.35 | 1.5 | SM | Yes | Composite | 1 | $0.63
XEL3520-131 | 0.13 | 13.8 | 25.4 | 3.5 | 165 | 80 | 3.65 | 3.35 | 2 | SM | Yes | Composite | 1 | $0.69
XEL3520-700 | 0.07 | 18.5 | 27.2 | 2.4 | 165 | 80 | 3.65 | 3.35 | 2 | SM | Yes | Composite | 1 | $0.69
XGL3520-101 | 0.1 | 15.9 | 26.2 | 2.3 | 165 | 80 | 3.65 | 3.35 | 2 | SM | Yes | Composite | 1 | $0.66
XGL3530-101 | 0.1 | 16.5 | 27.5 | 2.1 | 165 | 80 | 3.65 | 3.35 | 3 | SM | Yes | Composite | 1 | $0.66
SLR4040-220 | 0.022 | 78 | 40 | 0.32 | 125 |  | 4 | 4 | 4 | SM | Yes | Ferrite |  | $0.80
SLR4040-500 | 0.05 | 39 | 40 | 0.32 | 125 |  | 4 | 4 | 4 | SM | Yes | Ferrite |  | $0.80
SLR4040-650 | 0.065 | 31 | 40 | 0.32 | 125 |  | 4 | 4 | 4 | SM | Yes | Ferrite |  | $0.80
XEL4012-221 | 0.22 | 16 | 9 | 9.7 | 165 | 80 | 4.3 | 4.3 | 1.2 | SM | Yes | Composite | 1 | $0.69
XEL4012-920 | 0.092 | 24 | 16.5 | 5.2 | 165 | 80 | 4.3 | 4.3 | 1.2 | SM | Yes | Composite | 1 | $0.69
XEL4012V-221 | 0.22 | 16 | 9 | 9.7 | 165 | 120 | 4.3 | 4.3 | 1.2 | SM | Yes | Composite | 1 | $0.72
XEL4012V-920 | 0.092 | 24 | 16.5 | 5.2 | 165 | 120 | 4.3 | 4.3 | 1.2 | SM | Yes | Composite | 1 | $0.72
XGL4012-330 | 0.033 | 31.5 | 32 | 1.2 | 165 | 80 | 4.3 | 4.3 | 1.2 | SM | Yes | Composite | 1 | $0.66
XEL4014-221 | 0.22 | 18.2 | 12 | 7.5 | 165 | 80 | 4.3 | 4.3 | 1.4 | SM | Yes | Composite | 1 | $0.64
XEL4014-331 | 0.33 | 14.6 | 9 | 9.9 | 165 | 80 | 4.3 | 4.3 | 1.4 | SM | Yes | Composite | 1 | $0.64
XEL4014V-221 | 0.22 | 18.2 | 12 | 7.5 | 165 | 120 | 4.3 | 4.3 | 1.4 | SM | Yes | Composite | 1 | $0.72
XEL4014V-331 | 0.33 | 14.6 | 9 | 9.9 | 165 | 120 | 4.3 | 4.3 | 1.4 | SM | Yes | Composite | 1 | $0.72
XGL4015-101 | 0.1 | 24.5 | 25.9 | 1.8 | 165 | 80 | 4.3 | 4.3 | 1.5 | SM | Yes | Composite | 1 | $0.65
XGL4015-121 | 0.12 | 22 | 20.2 | 2.3 | 165 | 80 | 4.3 | 4.3 | 1.5 | SM | Yes | Composite | 1 | $0.65
XGL4015-301 | 0.3 | 12.9 | 15.3 | 4.7 | 165 | 80 | 4.3 | 4.3 | 1.5 | SM | Yes | Composite | 1 | $0.65
XGL4018-121 | 0.12 | 24.5 | 27.2 | 1.6 | 165 | 80 | 4.3 | 4.3 | 1.8 | SM | Yes | Composite | 1 | $0.65
XGL4018-221 | 0.22 | 16.1 | 21.7 | 2.6 | 165 | 80 | 4.3 | 4.3 | 1.8 | SM | Yes | Composite | 1 | $0.65
XGL4018-271 | 0.27 | 14.7 | 18.4 | 3.3 | 165 | 80 | 4.3 | 4.3 | 1.8 | SM | Yes | Composite | 1 | $0.65
XGL4018-361 | 0.36 | 12 | 16.4 | 4.3 | 165 | 80 | 4.3 | 4.3 | 1.8 | SM | Yes | Composite | 1 | $0.65
XGL4018-471 | 0.47 | 11.4 | 15.2 | 5.1 | 165 | 80 | 4.3 | 4.3 | 1.8 | SM | Yes | Composite | 1 | $0.65
XAL4020-221 | 0.22 | 18.7 | 16.8 | 5.8 | 165 | 60 | 4.3 | 4.3 | 2.1 | SM | Yes | Composite | 1 | $0.70
XAL4020-401 | 0.4 | 12.5 | 14 | 7.6 | 165 | 60 | 4.3 | 4.3 | 2.1 | SM | Yes | Composite | 1 | $0.70
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
SLC7649S-700 | 0.07 | 65 | 74 | 0.17 | 125 |  | 7.6 | 6.95 | 4.9 | SM | Yes | Ferrite | 3 | $0.58
XGL7015-102 | 1 | 13.2 | 14.1 | 10.3 | 165 | 80 | 8 | 8 | 1.5 | SM | Yes | Composite | 1 | $0.81
XGL7015-201 | 0.2 | 33 | 24.8 | 3 | 165 | 80 | 8 | 8 | 1.5 | SM | Yes | Composite | 1 | $0.81
XGL7015-381 | 0.38 | 23.2 | 20.4 | 4.3 | 165 | 80 | 8 | 8 | 1.5 | SM | Yes | Composite | 1 | $0.81
XGL7015-561 | 0.56 | 17.7 | 17.6 | 6.3 | 165 | 80 | 8 | 8 | 1.5 | SM | Yes | Composite | 1 | $0.81
XGL7015-821 | 0.82 | 14.6 | 14.7 | 9.4 | 165 | 80 | 8 | 8 | 1.5 | SM | Yes | Composite | 1 | $0.81
XAL7020-102 | 1 | 18 | 11 | 9.8 | 165 | 60 | 8 | 8 | 2 | SM | Yes | Composite | 1 | $0.92
XAL7020-122 | 1.2 | 17.6 | 10 | 11.5 | 165 | 60 | 8 | 8 | 2 | SM | Yes | Composite | 1 | $0.92
XAL7020-151 | 0.15 | 46 | 24 | 1.9 | 165 | 60 | 8 | 8 | 2 | SM | Yes | Composite | 1 | $0.92
XAL7020-152 | 1.5 | 15 | 9 | 17.6 | 165 | 60 | 8 | 8 | 2 | SM | Yes | Composite | 1 | $0.92
XAL7020-222 | 2.2 | 13.6 | 7 | 28.7 | 165 | 60 | 8 | 8 | 2 | SM | Yes | Composite | 1 | $0.92
XAL7020-271 | 0.27 | 30 | 21 | 2.9 | 165 | 60 | 8 | 8 | 2 | SM | Yes | Composite | 1 | $0.92
XAL7020-331 | 0.33 | 28 | 20 | 4 | 165 | 60 | 8 | 8 | 2 | SM | Yes | Composite | 1 | $0.92
XAL7020-471 | 0.47 | 24.3 | 17 | 5.3 | 165 | 60 | 8 | 8 | 2 | SM | Yes | Composite | 1 | $0.92
XAL7020-681 | 0.68 | 22.3 | 13 | 7.9 | 165 | 60 | 8 | 8 | 2 | SM | Yes | Composite | 1 | $0.92
XAL7030-102 | 1 | 28 | 21.8 | 4.5 | 165 | 60 | 8 | 8 | 3.1 | SM | Yes | Composite | 1 | $0.93
XAL7030-152 | 1.5 | 23.5 | 15 | 7.6 | 165 | 60 | 8 | 8 | 3.1 | SM | Yes | Composite | 1 | $0.93
XAL7030-161 | 0.16 | 60 | 32.5 | 1.1 | 165 | 60 | 8 | 8 | 3.1 | SM | Yes | Composite | 1 | $0.93
XAL7030-222 | 2.2 | 18 | 12.9 | 13.7 | 165 | 60 | 8 | 8 | 3.1 | SM | Yes | Composite | 1 | $0.93
XAL7030-272 | 2.7 | 12.8 | 11.4 | 15.7 | 165 | 60 | 8 | 8 | 3.1 | SM | Yes | Composite | 1 | $0.93
XAL7030-301 | 0.3 | 41 | 27.6 | 1.8 | 165 | 60 | 8 | 8 | 3.1 | SM | Yes | Composite | 1 | $0.93
XAL7030-332 | 3.3 | 12.3 | 10 | 19.5 | 165 | 60 | 8 | 8 | 3.1 | SM | Yes | Composite | 1 | $0.93
XAL7030-601 | 0.6 | 36 | 23 | 3 | 165 | 60 | 8 | 8 | 3.1 | SM | Yes | Composite | 1 | $0.93
XGL7030-102 | 1 | 21 | 22.9 | 3.8 | 165 | 80 | 8 | 8 | 3.1 | SM | Yes | Composite | 1 | $0.89
XGL7030-152 | 1.5 | 17.6 | 19.3 | 5.3 | 165 | 80 | 8 | 8 | 3.1 | SM | Yes | Composite | 1 | $0.89
XGL7030-222 | 2.2 | 14.5 | 16.3 | 7.3 | 165 | 80 | 8 | 8 | 3.1 | SM | Yes | Composite | 1 | $0.89
XGL7030-241 | 0.24 | 46 | 37.2 | 1.1 | 165 | 80 | 8 | 8 | 3.1 | SM | Yes | Composite | 1 | $0.89
XGL7030-332 | 3.3 | 12 | 13.8 | 10.4 | 165 | 80 | 8 | 8 | 3.1 | SM | Yes | Composite | 1 | $0.89
XGL7030-471 | 0.47 | 32 | 29.4 | 1.9 | 165 | 80 | 8 | 8 | 3.1 | SM | Yes | Composite | 1 | $0.89
XGL7030-681 | 0.68 | 27 | 26 | 2.5 | 165 | 80 | 8 | 8 | 3.1 | SM | Yes | Composite | 1 | $0.89
XAL7070-102 | 1 | 34.8 | 25 | 2.6 | 165 | 60 | 8 | 7.7 | 7 | SM | Yes | Composite | 1 | $1.41
XAL7070-122 | 1.2 | 31.2 | 21.6 | 3.1 | 165 | 60 | 8 | 7.7 | 7 | SM | Yes | Composite | 1 | $1.41
XAL7070-161 | 0.16 | 78 | 36.1 | 0.75 | 165 | 60 | 8 | 7.7 | 7 | SM | Yes | Composite | 1 | $1.41
XAL7070-182 | 1.8 | 25 | 21 | 4 | 165 | 60 | 8 | 7.7 | 7 | SM | Yes | Composite | 1 | $1.41
XAL7070-222 | 2.2 | 19.6 | 17.8 | 5.7 | 165 | 60 | 8 | 7.7 | 7 | SM | Yes | Composite | 1 | $1.41
XAL7070-301 | 0.3 | 55.6 | 33.4 | 1.1 | 165 | 60 | 8 | 7.7 | 7 | SM | Yes | Composite | 1 | $1.41
XAL7070-332 | 3.3 | 19.4 | 15.1 | 8.6 | 165 | 60 | 8 | 7.7 | 7 | SM | Yes | Composite | 1 | $1.41
XAL7070-472 | 4.7 | 15.2 | 13.6 | 13 | 165 | 60 | 8 | 7.7 | 7 | SM | Yes | Composite | 1 | $1.41
XAL7070-551 | 0.55 | 43 | 29 | 1.4 | 165 | 60 | 8 | 7.7 | 7 | SM | Yes | Composite | 1 | $1.41
XAL7070-562 | 5.6 | 13 | 11.4 | 13.7 | 165 | 60 | 8 | 7.7 | 7 | SM | Yes | Composite | 1 | $1.41
XAL7070-651 | 0.65 | 40 | 26.5 | 1.8 | 165 | 60 | 8 | 7.7 | 7 | SM | Yes | Composite | 1 | $1.41
XAL7070-682 | 6.8 | 12.8 | 9.2 | 17.8 | 165 | 60 | 8 | 7.7 | 7 | SM | Yes | Composite | 1 | $1.41
XAL7070-801 | 0.8 | 37.8 | 25.8 | 2.1 | 165 | 60 | 8 | 7.7 | 7 | SM | Yes | Composite | 1 | $1.41
SER8050-451 | 0.45 | 31.1 | 11.7 | 3.2 | 125 |  | 8.8 | 8.5 | 5 | SM | Yes | Ferrite |  | $0.99
XAL8080-102 | 1 | 31.3 | 34.1 | 2.1 | 165 | 60 | 8.8 | 8.3 | 8 | SM | Yes | Composite | 1 | $3.62
XAL8080-222 | 2.2 | 24 | 21.5 | 4.1 | 165 | 60 | 8.8 | 8.3 | 8 | SM | Yes | Composite | 1 | $3.62
XAL8080-472 | 4.7 | 17.4 | 14.6 | 8.9 | 165 | 60 | 8.8 | 8.3 | 8 | SM | Yes | Composite | 1 | $3.62
XAL8080-681 | 0.68 | 43 | 37 | 1.4 | 165 | 60 | 8.8 | 8.3 | 8 | SM | Yes | Composite | 1 | $3.62
XAL8080-682 | 6.8 | 14 | 11.3 | 13.2 | 165 | 60 | 8.8 | 8.3 | 8 | SM | Yes | Composite | 1 | $3.62
XAL8080-841 | 0.84 | 41 | 35 | 1.6 | 165 | 60 | 8.8 | 8.3 | 8 | SM | Yes | Composite | 1 | $3.62
XAR7030-102 | 1 | 28 | 14 | 4.5 | 165 |  | 9 | 9 | 5 | SM | Yes | Composite |  | $1.53
XAR7030-132 | 1.3 | 23.5 | 11 | 7.6 | 165 |  | 9 | 9 | 5 | SM | Yes | Composite |  | $1.53
XAR7030-161 | 0.16 | 60 | 18.6 | 1.3 | 165 |  | 9 | 9 | 5 | SM | Yes | Composite |  | $1.53
XAR7030-222 | 2.2 | 18 | 8.7 | 13.7 | 165 |  | 9 | 9 | 5 | SM | Yes | Composite |  | $1.53
XAR7030-272 | 2.7 | 12.8 | 7.1 | 15.7 | 165 |  | 9 | 9 | 5 | SM | Yes | Composite |  | $1.53
XAR7030-301 | 0.3 | 41 | 18.6 | 1.8 | 165 |  | 9 | 9 | 5 | SM | Yes | Composite |  | $1.53
XAR7030-332 | 3.3 | 12.3 | 6.5 | 19.5 | 165 |  | 9 | 9 | 5 | SM | Yes | Composite |  | $1.53
XAR7030-472 | 4.7 | 10.1 | 5.7 | 26.1 | 165 |  | 9 | 9 | 5 | SM | Yes | Composite |  | $1.53
XAR7030-501 | 0.5 | 36 | 17.5 | 3 | 165 |  | 9 | 9 | 5 | SM | Yes | Composite |  | $1.53
SLV9080-101 | 0.1 | 73 | 54.5 | 0.19 | 125 |  | 9.15 | 6.4 | 8.5 | SM | Yes | Ferrite | 3 | Quote
SLV9080-121 | 0.12 | 60 | 54.5 | 0.19 | 125 |  | 9.15 | 6.4 | 8.5 | SM | Yes | Ferrite | 3 | Quote
SLV9080-151 | 0.15 | 47 | 54.5 | 0.19 | 125 |  | 9.15 | 6.4 | 8.5 | SM | Yes | Ferrite | 3 | Quote
SLV9080-181 | 0.18 | 41 | 54.5 | 0.19 | 125 |  | 9.15 | 6.4 | 8.5 | SM | Yes | Ferrite | 3 | Quote
SLV9080-201 | 0.2 | 37 | 54.5 | 0.19 | 125 |  | 9.15 | 6.4 | 8.5 | SM | Yes | Ferrite | 3 | Quote
SLV9080-500 | 0.05 | 120 | 54.5 | 0.19 | 125 |  | 9.15 | 6.4 | 8.5 | SM | Yes | Ferrite | 3 | Quote
SLV9080-700 | 0.07 | 94 | 54.5 | 0.19 | 125 |  | 9.15 | 6.4 | 8.5 | SM | Yes | Ferrite | 3 | Quote
SLR7010-101 | 0.1 | 113 | 92 | 0.17 | 145 |  | 10 | 7 | 10 | SM | Yes | Ferrite | 2 | $0.90
SLR7010-121 | 0.12 | 98 | 92 | 0.17 | 145 |  | 10 | 7 | 10 | SM | Yes | Ferrite | 2 | $0.90
SLR7010-151 | 0.15 | 75 | 92 | 0.17 | 145 |  | 10 | 7 | 10 | SM | Yes | Ferrite | 2 | $0.90
SLR7010-201 | 0.2 | 62 | 92 | 0.17 | 145 |  | 10 | 7 | 10 | SM | Yes | Ferrite | 2 | $0.90
SLR7010-251 | 0.25 | 44 | 92 | 0.17 | 145 |  | 10 | 7 | 10 | SM | Yes | Ferrite | 2 | $0.90
SLR7010-331 | 0.33 | 32 | 92 | 0.17 | 145 |  | 10 | 7 | 10 | SM | Yes | Ferrite | 2 | $0.90
SLR1050A-101 | 0.1 | 78 | 77.1 | 0.39 | 125 |  | 10.2 | 7 | 4.95 | SM | Yes | Ferrite |  | $0.54
SLR1050A-121 | 0.12 | 65 | 77.1 | 0.39 | 125 |  | 10.2 | 7 | 4.95 | SM | Yes | Ferrite |  | $0.54
SLR1050A-151 | 0.15 | 51 | 77.1 | 0.39 | 125 |  | 10.2 | 7 | 4.95 | SM | Yes | Ferrite |  | $0.54
SLR1050A-221 | 0.22 | 35 | 77.1 | 0.39 | 125 |  | 10.2 | 7 | 4.95 | SM | Yes | Ferrite |  | $0.54
SLR1050A-850 | 0.085 | 86 | 77.1 | 0.39 | 125 |  | 10.2 | 7 | 4.95 | SM | Yes | Ferrite |  | $0.54
SLR1050B-101 | 0.1 | 78 | 67.2 | 0.47 | 125 |  | 10.2 | 7 | 4.95 | SM | Yes | Ferrite |  | $0.54
SLR1050B-121 | 0.12 | 65 | 67.2 | 0.47 | 125 |  | 10.2 | 7 | 4.95 | SM | Yes | Ferrite |  | $0.54
SLR1050B-151 | 0.15 | 51 | 67.2 | 0.47 | 125 |  | 10.2 | 7 | 4.95 | SM | Yes | Ferrite |  | $0.54
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
SLV1211-121 | 0.12 | 105 | 60 | 0.125 | 85 |  | 12.2 | 6.2 | 11.3 | SM | Yes | Ferrite |  | Quote
SLV1211-161 | 0.16 | 77 | 60 | 0.125 | 85 |  | 12.2 | 6.2 | 11.3 | SM | Yes | Ferrite |  | Quote
SLV1211-181 | 0.18 | 69 | 60 | 0.125 | 85 |  | 12.2 | 6.2 | 11.3 | SM | Yes | Ferrite |  | Quote
SLV1211-201 | 0.2 | 59 | 60 | 0.125 | 85 |  | 12.2 | 6.2 | 11.3 | SM | Yes | Ferrite |  | Quote
SLV1211-700 | 0.07 | 152 | 60 | 0.125 | 85 |  | 12.2 | 6.2 | 11.3 | SM | Yes | Ferrite |  | Quote
MSS1278-142 | 1.4 | 30.6 | 10 | 8.8 | 125 |  | 12.3 | 12.3 | 8.05 | SM | Yes | Ferrite | 3 | $0.77
MSS1278H-821 | 0.82 | 31 | 10.5 | 3.7 | 165 | 400 | 12.3 | 12.3 | 8.05 | SM | Yes | Ferrite | 1 | $0.89
MSS1278T-102 | 1 | 36.8 | 10.1 | 6.3 | 165 |  | 12.3 | 12.3 | 8.05 | SM | Yes | Ferrite | 1 | $0.89
SER1360-102 | 1 | 33.5 | 13 | 2.4 | 125 |  | 13 | 12.9 | 5.8 | SM | Yes | Ferrite | 3 | $0.90
SER1360-331 | 0.33 | 43 | 16.9 | 0.77 | 125 |  | 13 | 12.9 | 5.8 | SM | Yes | Ferrite | 3 | $0.90
DO3340H-271 | 0.27 | 56 | 30 | 1.3 | 125 |  | 13.21 | 9.91 | 11.94 | SM | No | Ferrite | 3 | $1.24
DO3340H-471 | 0.47 | 44 | 22.5 | 1.8 | 125 |  | 13.21 | 9.91 | 11.94 | SM | No | Ferrite | 3 | $1.24
SLC1480-111 | 0.11 | 130 | 83 | 0.18 | 125 |  | 13.46 | 12.95 | 8 | SM | Yes | Ferrite |  | $0.95
SLC1480-131 | 0.13 | 112 | 83 | 0.18 | 125 |  | 13.46 | 12.95 | 8 | SM | Yes | Ferrite |  | $0.95
SLC1480-151 | 0.15 | 97 | 83 | 0.18 | 125 |  | 13.46 | 12.95 | 8 | SM | Yes | Ferrite |  | $0.95
SLC1480-171 | 0.17 | 90 | 83 | 0.18 | 125 |  | 13.46 | 12.95 | 8 | SM | Yes | Ferrite |  | $0.95
SLC1480-201 | 0.2 | 76 | 83 | 0.18 | 125 |  | 13.46 | 12.95 | 8 | SM | Yes | Ferrite |  | $0.95
SLC1480-231 | 0.23 | 67 | 83 | 0.18 | 125 |  | 13.46 | 12.95 | 8 | SM | Yes | Ferrite |  | $0.95
SLC1480-261 | 0.26 | 61 | 83 | 0.18 | 125 |  | 13.46 | 12.95 | 8 | SM | Yes | Ferrite |  | $0.95
SLC1480-301 | 0.3 | 52 | 83 | 0.18 | 125 |  | 13.46 | 12.95 | 8 | SM | Yes | Ferrite |  | $0.95
SLC1480-321 | 0.32 | 48 | 83 | 0.18 | 125 |  | 13.46 | 12.95 | 8 | SM | Yes | Ferrite |  | $0.95
SLC1480-441 | 0.44 | 35 | 83 | 0.18 | 125 |  | 13.46 | 12.95 | 8 | SM | Yes | Ferrite |  | $0.95
MLC1555-551 | 0.55 | 35.7 | 22.3 | 1.3 | 125 |  | 13.8 | 13.2 | 5.6 | SM | Yes | Powdered iron | 3 | $1.12
CU8838 | 1 | 63 | 26 | 1.8 | 125 |  | 14 | 13.2 | 6.5 | SM | Yes | Powdered iron |  | $1.43
MLC1565-142 | 1.4 | 30.1 | 19.9 | 2.2 | 125 |  | 14 | 13.2 | 6.5 | SM | Yes | Powdered iron | 3 | $1.26
MLC1565-451 | 0.45 | 54 | 25.6 | 0.864 | 125 |  | 14 | 13.2 | 6.5 | SM | Yes | Powdered iron | 3 | $1.26
MLC1565-501 | 0.5 | 38.1 | 26.9 | 0.864 | 125 |  | 14 | 13.2 | 6.5 | SM | Yes | Powdered iron | 3 | $1.26
MLC1565-801 | 0.8 | 47.4 | 24.6 | 1.2 | 125 |  | 14 | 13.2 | 6.5 | SM | Yes | Powdered iron | 3 | $1.26
XAL1350-132 | 1.3 | 56 | 32 | 2.5 | 165 | 60 | 14.2 | 13.2 | 5 | SM | Yes | Composite | 1 | $3.33
XAL1350-222 | 2.2 | 46 | 24 | 4.2 | 165 | 60 | 14.2 | 13.2 | 5 | SM | Yes | Composite | 1 | $3.33
XAL1350-302 | 3 | 37 | 21 | 5.9 | 165 | 60 | 14.2 | 13.2 | 5 | SM | Yes | Composite | 1 | $3.33
XAL1350-631 | 0.63 | 74 | 38 | 1.5 | 165 | 60 | 14.2 | 13.2 | 5 | SM | Yes | Composite | 1 | $3.33
XAL1350-931 | 0.93 | 60 | 33 | 2 | 165 | 60 | 14.2 | 13.2 | 5 | SM | Yes | Composite | 1 | $3.33
XGL1313-103 | 10 | 23 | 26 | 5.5 | 165 | 60 | 15.2 | 13.6 | 13 | SM | Yes | Composite | 1 | $2.70
XGL1313-152 | 1.5 | 53 | 48.7 | 1 | 165 | 60 | 15.2 | 13.6 | 13 | SM | Yes | Composite | 1 | $2.70
XGL1313-153 | 15 | 17.5 | 21.3 | 8 | 165 | 60 | 15.2 | 13.6 | 13 | SM | Yes | Composite | 1 | $2.70
XGL1313-222 | 2.2 | 46 | 45.1 | 1.4 | 165 | 60 | 15.2 | 13.6 | 13 | SM | Yes | Composite | 1 | $2.70
XGL1313-223 | 22 | 15.4 | 17.2 | 11.6 | 165 | 60 | 15.2 | 13.6 | 13 | SM | Yes | Composite | 1 | $2.70
XGL1313-332 | 3.3 | 40 | 39.7 | 2 | 165 | 60 | 15.2 | 13.6 | 13 | SM | Yes | Composite | 1 | $2.70
XGL1313-472 | 4.7 | 35 | 36.7 | 2.5 | 165 | 60 | 15.2 | 13.6 | 13 | SM | Yes | Composite | 1 | $2.70
XGL1313-682 | 6.8 | 26.5 | 31 | 3.8 | 165 | 60 | 15.2 | 13.6 | 13 | SM | Yes | Composite | 1 | $2.70
XGL1313-822 | 8.2 | 25 | 28.7 | 4.4 | 165 | 60 | 15.2 | 13.6 | 13 | SM | Yes | Composite | 1 | $2.70
ZE2652-AE | 2.2 | 44 | 46.5 | 1.3 | 165 | 60 | 15.2 | 13.6 | 13 | SM | Yes | Composite | 1 | Quote
SER1408-301 | 0.3 | 53 | 42 | 0.48 | 165 |  | 15.24 | 12 | 8.26 | SM | Yes | Ferrite | 1 | $2.62
SER1408-501 | 0.5 | 31.4 | 42 | 0.48 | 165 |  | 15.24 | 12 | 8.26 | SM | Yes | Ferrite | 1 | $2.62
SER1412-102 | 1 | 32.2 | 37 | 1.3 | 165 |  | 15.24 | 12 | 12.66 | SM | Yes | Ferrite | 1 | $2.36
SER1412-301 | 0.3 | 106 | 37 | 1.3 | 165 |  | 15.24 | 12 | 12.66 | SM | Yes | Ferrite | 1 | $2.36
SER1412-501 | 0.5 | 62.5 | 37 | 1.3 | 165 |  | 15.24 | 12 | 12.66 | SM | Yes | Ferrite | 1 | $2.36
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
SER2012-681 | 0.68 | 85 | 35 | 1.4 | 125 |  | 19.69 | 19.56 | 11.94 | SM | Yes | Ferrite | 3 | $1.46
SER2012-801 | 0.8 | 75 | 35 | 1.4 | 125 |  | 19.69 | 19.56 | 11.94 | SM | Yes | Ferrite | 3 | $1.46
SER2012-901 | 0.9 | 69 | 35 | 1.4 | 125 |  | 19.69 | 19.56 | 11.94 | SM | Yes | Ferrite | 3 | $1.46
SER2013-102 | 1 | 68 | 30 | 1.7 | 125 |  | 19.69 | 19.56 | 12.95 | SM | Yes | Ferrite | 3 | $1.94
SER2013-122 | 1.2 | 58 | 30 | 1.7 | 125 |  | 19.69 | 19.56 | 12.95 | SM | Yes | Ferrite | 3 | $1.94
SER2013-202 | 2 | 40 | 30 | 1.7 | 125 |  | 19.69 | 19.56 | 12.95 | SM | Yes | Ferrite | 3 | $1.94
SER2013-681 | 0.68 | 98 | 30 | 1.7 | 125 |  | 19.69 | 19.56 | 12.95 | SM | Yes | Ferrite | 3 | $1.94
SER2013-801 | 0.8 | 85 | 30 | 1.7 | 125 |  | 19.69 | 19.56 | 12.95 | SM | Yes | Ferrite | 3 | $1.94
SER2013-901 | 0.9 | 73 | 30 | 1.7 | 125 |  | 19.69 | 19.56 | 12.95 | SM | Yes | Ferrite | 3 | $1.94
SER2014-102 | 1 | 70 | 27 | 1.9 | 125 |  | 19.69 | 19.56 | 13.97 | SM | Yes | Ferrite | 3 | $1.57
SER2014-122 | 1.2 | 63 | 27 | 1.9 | 125 |  | 19.69 | 19.56 | 13.97 | SM | Yes | Ferrite | 3 | $1.57
SER2014-202 | 2 | 45 | 27 | 1.9 | 125 |  | 19.69 | 19.56 | 13.97 | SM | Yes | Ferrite | 3 | $1.57
SER2014-801 | 0.8 | 98 | 27 | 1.9 | 125 |  | 19.69 | 19.56 | 13.97 | SM | Yes | Ferrite | 3 | $1.57
SER2014-901 | 0.9 | 87 | 27 | 1.9 | 125 |  | 19.69 | 19.56 | 13.97 | SM | Yes | Ferrite | 3 | $1.57
DO5040H-282 | 2.8 | 33.4 | 12.1 | 4.7 | 125 |  | 22.35 | 16.25 | 12 | SM | No | Ferrite | 3 | $1.50
AGM2222-103 | 10 | 37 | 30 | 2.1 | 165 |  | 23 | 23 | 23 | TH | Yes | Powdered iron | 1 | $5.73
AGM2222-192 | 1.9 | 110 | 54 | 0.62 | 165 |  | 23 | 23 | 23 | TH | Yes | Powdered iron | 1 | $5.73
AGM2222-222 | 2.2 | 84 | 54 | 0.62 | 165 |  | 23 | 23 | 23 | TH | Yes | Powdered iron | 1 | $5.73
AGM2222-282 | 2.8 | 93.5 | 47 | 0.74 | 165 |  | 23 | 23 | 23 | TH | Yes | Powdered iron | 1 | $5.73
AGM2222-322 | 3.2 | 71 | 47 | 0.74 | 165 |  | 23 | 23 | 23 | TH | Yes | Powdered iron | 1 | $5.73
AGM2222-392 | 3.9 | 80 | 45 | 0.77 | 165 |  | 23 | 23 | 23 | TH | Yes | Powdered iron | 1 | $5.73
AGM2222-432 | 4.3 | 57 | 45 | 0.77 | 165 |  | 23 | 23 | 23 | TH | Yes | Powdered iron | 1 | $5.73
AGM2222-512 | 5.1 | 71 | 40 | 1.1 | 165 |  | 23 | 23 | 23 | TH | Yes | Powdered iron | 1 | $5.73
AGM2222-562 | 5.6 | 55 | 40 | 1.1 | 165 |  | 23 | 23 | 23 | TH | Yes | Powdered iron | 1 | $5.73
AGM2222-652 | 6.5 | 62 | 35 | 1.8 | 165 |  | 23 | 23 | 23 | TH | Yes | Powdered iron | 1 | $5.73
AGM2222-712 | 7.1 | 46 | 35 | 1.8 | 165 |  | 23 | 23 | 23 | TH | Yes | Powdered iron | 1 | $5.73
AGM2222-802 | 8 | 56 | 32 | 1.7 | 165 |  | 23 | 23 | 23 | TH | Yes | Powdered iron | 1 | $5.73
AGM2222-882 | 8.8 | 42 | 32 | 1.7 | 165 |  | 23 | 23 | 23 | TH | Yes | Powdered iron | 1 | $5.73
VER2923-103 | 10 | 37 | 26 | 2.3 | 125 |  | 27.08 | 16.97 | 22.74 | TH | Yes | Ferrite |  | $3.56
VER2923-332 | 3.3 | 108 | 26 | 2.3 | 125 |  | 27.08 | 16.97 | 22.74 | TH | Yes | Ferrite |  | $3.56
VER2923-472 | 4.7 | 72 | 26 | 2.3 | 125 |  | 27.08 | 16.97 | 22.74 | TH | Yes | Ferrite |  | $3.56
VER2923-682 | 6.8 | 56 | 26 | 2.3 | 125 |  | 27.08 | 16.97 | 22.74 | TH | Yes | Ferrite |  | $3.56
HA3588 | 10 | 37 | 26 | 2.3 | 125 |  | 27.08 | 16.97 | 22.76 | TH | Yes | Ferrite |  | $4.23
AGP2923-103 | 10 | 37 | 26 | 2.3 | 180 |  | 27.43 | 16.97 | 23.75 | TH | Yes | Ferrite | 1 | $3.69
AGP2923-332 | 3.3 | 108 | 26 | 2.3 | 180 |  | 27.43 | 16.97 | 23.75 | TH | Yes | Ferrite | 1 | $3.69
AGP2923-472 | 4.7 | 72 | 26 | 2.3 | 180 |  | 27.43 | 16.97 | 23.75 | TH | Yes | Ferrite | 1 | $3.69
AGP2923-682 | 6.8 | 56 | 26 | 2.3 | 180 |  | 27.43 | 16.97 | 23.75 | TH | Yes | Ferrite | 1 | $3.69
SER2915H-222 | 2.2 | 100 | 30 | 1.9 | 125 |  | 27.94 | 27.9 | 15.36 | SM | Yes | Ferrite | 3 | $2.34
SER2915H-332 | 3.3 | 68.4 | 30 | 1.9 | 125 |  | 27.94 | 27.9 | 15.36 | SM | Yes | Ferrite | 3 | $2.34
SER2915H-472 | 4.7 | 50.1 | 30 | 1.9 | 125 |  | 27.94 | 27.9 | 15.36 | SM | Yes | Ferrite | 3 | $2.34
SER2915H-682 | 6.8 | 36.2 | 30 | 1.9 | 125 |  | 27.94 | 27.9 | 15.36 | SM | Yes | Ferrite | 3 | $2.34
SER2915L-152 | 1.5 | 100 | 30 | 1.5 | 125 |  | 27.94 | 27.9 | 15.36 | SM | Yes | Ferrite | 3 | $2.26
SER2915L-222 | 2.2 | 84.8 | 30 | 1.5 | 125 |  | 27.94 | 27.9 | 15.36 | SM | Yes | Ferrite | 3 | $2.26
SER2915L-332 | 3.3 | 57 | 30 | 1.5 | 125 |  | 27.94 | 27.9 | 15.36 | SM | Yes | Ferrite | 3 | $2.26
SER2915L-472 | 4.7 | 39 | 30 | 1.5 | 125 |  | 27.94 | 27.9 | 15.36 | SM | Yes | Ferrite | 3 | $2.26
SER2918H-103 | 10 | 32.1 | 28 | 2.6 | 125 |  | 27.94 | 27.9 | 17.78 | SM | Yes | Ferrite | 3 | $3.18
SER2918H-332 | 3.3 | 93.6 | 28 | 2.6 | 125 |  | 27.94 | 27.9 | 17.78 | SM | Yes | Ferrite | 3 | $3.18
SER2918H-472 | 4.7 | 62.4 | 28 | 2.6 | 125 |  | 27.94 | 27.9 | 17.78 | SM | Yes | Ferrite | 3 | $3.18
SER2918H-682 | 6.8 | 45.9 | 28 | 2.6 | 125 |  | 27.94 | 27.9 | 17.78 | SM | Yes | Ferrite | 3 | $3.18
SER3018H-103 | 10 | 32.1 | 28 | 2.6 | 125 | 400 | 27.94 | 27.94 | 17.78 | SM | Yes | Ferrite |  | $2.85
SER3018H-332 | 3.3 | 93.6 | 28 | 2.6 | 125 | 400 | 27.94 | 27.94 | 17.78 | SM | Yes | Ferrite |  | $2.85
SER3018H-472 | 4.7 | 62.4 | 28 | 2.6 | 125 | 400 | 27.94 | 27.94 | 17.78 | SM | Yes | Ferrite |  | $2.85
SER3018H-682 | 6.8 | 45.9 | 28 | 2.6 | 125 | 400 | 27.94 | 27.94 | 17.78 | SM | Yes | Ferrite |  | $2.85
MA5172 | 10 | 45 | 8.2 | 23.4 | 125 |  | 28.6 | 12.3 | 28.6 | TH | Yes | Powdered iron |  | $3.83
MA5173 | 7 | 54 |  | 19.3 |  |  | 28.6 | 12.3 | 28.6 | TH | Yes | Powdered iron |  | $2.87
ED0006 | 20 | 36 | 7.2 | 37.8 | 125 |  | 32 | 15 | 32 | TH | Yes | Ferrite |  | $3.12
AGP4233-103 | 10 | 63 | 34 | 2.8 | 165 |  | 40.3 | 36.8 | 28 | TH | Yes | Ferrite | 1 | $9.35
AGP4233-153 | 15 | 49 | 34 | 2.8 | 165 |  | 40.3 | 36.8 | 28 | TH | Yes | Ferrite | 1 | $9.35
AGP4233-223 | 22 | 36.6 | 34 | 2.8 | 165 |  | 40.3 | 36.8 | 28 | TH | Yes | Ferrite | 1 | $9.35
AGP4233-332 | 3.3 | 98 | 44 | 0.67 | 165 |  | 40.3 | 36.8 | 28 | TH | Yes | Ferrite | 1 | $9.35
AGP4233-562 | 5.6 | 67 | 44 | 0.67 | 165 |  | 40.3 | 36.8 | 28 | TH | Yes | Ferrite | 1 | $9.35
AGP4233-682 | 6.8 | 102 | 34 | 2.8 | 165 |  | 40.3 | 36.8 | 28 | TH | Yes | Ferrite | 1 | $9.35
Link to results page: | https://www.coilcraft.com/en-us/tools/power-inductor-finder/
