ut-ras/rm_electrical-supercap_v2/Fabrication_and_Testing/Bringup_Guide/Fall 2026 Bringup Notes.txt

XT30 Footprint are wrong
+ - labels on minipc XT30 are swapped
Both voltage regulators works as expected
No test point for voltage regulators
Better clarity on Launchpad orientation
Gate drivers are working
