ut-ras/rm_electrical-supercap_v2/Fabrication_and_Testing/Bringup_Guide/Bringup_Guide.pdf

# Bringup Guide

Egan Wang

September 15, 2026

# Contents

1 Before Beginning | 2
2 Voltage Regulators | 4
3 Gate Driver Functionality | 6
4 Open-Loop Power Stage Testing | 8
5 Closed-Loop Control | 9

1

# Chapter 1

# Before Beginning

The goal of this paper is to provide a summary of the procedures required to fabricate the supercapacitor system and validate function. At the time of the writing of this document, this author will not be in Austin for the duration of the supercapacitor system’s fabrication and testing, making direct supervision impossible. While videocalls and frequent communication can allow for an indirect approach to system bringup, the associated requirement for synchronicity causes reduced responsiveness due to internet latency as well as difficulties in scheduling testing time. By creating documentation for testing procedures, this document will both improve procedural efficiency as well as create institutional knowledge for future Robomaster teams to reference.

## 1.1 Priorities

While a smooth system bringup is both not impossible and ideal, shortcomings in design and in procedure can force tradeoffs to be made. Following is a list of the priorities to be made when following the instructions in this document:

1. Safety. This item is trivial. The supercapacitor system can store a maximum of 2 kJ of energy at full charge, sufficient to cause serious injury in the case of a failure. Furthermore, supercapacitor failures in particular carry the risk of hydrogen explosions in both overheating and overvoltage scenarios [1]. Utmost care should be taken to protect Robomaster team members from harm in every circumstance.
2. Overall Robot Functionality. The supercapacitor system should not impede the functionality of the other system functions within the robot, including during failure modes. Given that the supercapacitor converter PCB routes chassis power from the PMM to the rest of the robot, this concern is particularly salient.
3. Discharging Behavior. The supercapacitor system is designed first and foremost to supplement battery power in situations where battery power

2

alone is not sufficient to meet the energy demands of the chassis. A supercapacitor system capable of charging but not discharging functionality is no better than no supercapacitor system at all.

4. Full Supercapacitor System Functionality. The importance of this priority is obvious, notable only in its relative position in this list.
5. Efficiency. Further improvements to aspects of the design can be considered at this point.

This prioritization should serve as a guide for handling situations in which this guide does not provide a clear answer. Great care should be taken to ensure that a lower priority does not take precedence over a higher priority.

## 1.2 Requirements for Testing

At the time of this writing, system fabrication and characterization is expected to occur during 2026 summer, with the solar power labs in the EER being closed to students. The Texas Inventionworks Center in the same building will still be open, but its facilities may yet be limited. Following is a list of required equipment for fabrication and testing:

| 2 channels of 24VDC power to simulate +24V and MiniPC from the PMM
| A 2-channel oscilloscope with either:
| – 1 set of differential probes – 2 oscilloscope channels with a ”Math” functionality
| Hot air soldering station
| Soldering iron
| Supplemental soldering equipment (wire cutters/strippers, tweezers)

Each Chapter of this work will include a list of required parts to be used for that specific Chapter, allowing fabrication and testing to begin even without all parts arriving.
The following equipment is not required, but its presence will greatly ease the fabrication process:
| A multimeter
| A 4-channel oscilloscope instead of a 2-channel oscilloscope
| A current measurement oscilloscope probe
| Passive oscilloscope probes
| A 3V3-capable signal generator (2 synchronized channels even better)

3

# Chapter 2

# Voltage Regulators

Being the components that power the rest of the system, the voltage regulators’ proper function must be confirmed before other components can be connected to their outputs. It should be noted that this Chapter can be completed second instead of first in the case of shipping delays for the voltage regulator. Refer to Section 2.2 for testing before gate drivers and Section 2.3 for if testing and integration must occur after the steps of Chapter 3 are completed.

## 2.1 Required Components

Component Name | Component Number | Quantity
Horizontal XT30 input connector | - | 2
12V voltage regulator | P7812B-1000 | 1
3V3 voltage regulator | P7803B-1000 | 1

## 2.2 Bringup With PCB Connection

1. Solder horizontal XT30 connectors to MiniPC and Vin
2. Solder regulators to board
3. Supply +24V to MiniPC and Vin, confirm 12V and 3V3 voltage regulator output

## 2.3 Bringup Without PCB Connection

1. Attach power supply to voltage regulators via alligator clips or other solderless attachment
2. Confirm 12V and 3V3 voltage regulator output
3. Solder regulators to PCB

4

4. Solder horizontal XT30 connectors to PCB

5

# Chapter 3

# Gate Driver Functionality

The next most common cause of failure in a power converter comes from shootthrough, which occurs when both switches in a half-bridge are on simultaneously, resulting in a short between input voltage and ground. (Not good!) This Chapter will focus on ensuring proper gate driver functionality to prevent switch failures.

## 3.1 Required Components

Component Name | Component Number | Quantity
Gate Driver | NCP5109ADR2G | 2
Bootstrap Diode | V1P22HM3 A/H | 2
Bootstrap Capacitor | MAJCT168BB7105KTEA01 | 2
Decoupling Capacitor | CL10A475KO8NNNC | 2
MOSFET | IQDH35N03LM5CGSC | 4
2x10 Pin Header | TODO: add part number | 1

## 3.2 Procedure: Fabrication Without Switches

Gate drivers are fickle creatures. Some devices will work with incomplete bootstrap circuitry, some don’t, and some require the MOSFETs to be installed too. Expect to be chained to the oscilloscope.

1. Solder gate drivers, bootstrap capacitors/diodes, and decoupling capacitors to PCB. (Make sure bootstrap diodes are installed in the correct direction!)
2. Depending on regulator status:
(a) If regulators are not installed, jumper +12V to DC power supply set to 12VDC output.

6

(b) If regulators are installed, connect Vin to DC power supply set to 24VDC output.
3. Depending on MCU status:
(a) If MCU is available, solder 2x10 header pin to top side of board and connect MCU.
(b) If MCU is unavailable, temporarily connect signal generator to Lin and Hin nets.
4. Configure the signal output (MCU or signal generator) to output a 50% duty cycle square wave at 120kHz. (If possible, make Hin and Lin complementary square waves.)

Measure the output of each gate driver.

## 3.3 Gate Driver Bringup: Debugging

It is quite likely that the gate driver does not operate properly. Unfortunately, it is not feasible to include specific instructions for every possible issue that could arise during gate driver debugging. Consider the following:

| Read the datasheet!
| Some gate drivers are ”too smart for their own good” and do not function unless connected to a MOSFET to drive. Try attaching the MOSFETs as a first resort.
| Make sure the bootstrap diodes are oriented correctly!
| Check part numbers and ensure that all component values match.
| Check if input signals are staying consistent.
| Gate drivers can take suprising amounts of current. Ensure the DC power supply isn’t current-limited.

Anything beyond this will have to be improvised. Make hypotheses, read datasheets, and devise experiments to make progress towards successful gate driver function. It would be particularly helpful to understand gate driver loops and the inner workings of gate drivers, especially the level shifters that allow high-side operation.

7

# Chapter 4

# Open-Loop Power Stage Testing

Time to test the power stage.

## 4.1 Required Components

Component Name | Component Number | Quantity
Power Inductor (ETD44 Core) | - | 1
Filter Inductor (ETD29 Core) | - | 1
Filter Capacitor | GRM188R6YA106MA73D | 4
Filter Resistor | ERJ-H3QD3R30V | 1
Current Sensor | ACS71240KEXBLT-010B3 | 1

## 4.2 Separate DC Load

8

# Chapter 5

# Closed-Loop Control

Closed-loop control brings it all together.

9

# Bibliography

[1] K. Mazloomian, T. R. Dore, M. Buckwell, L. Bird, P. R. Shearing, and T. S. Miller, “Supercapacitor safety: Temperature driven instability and failure of electrochemical double layer capacitors,” Energy Storage Materials, vol. 76, p. 104115, 2025. [Online]. Available: https://www.sciencedirect.com/science/article/pii/S2405829725001151

10
