ut-ras/rm_electrical-supercap_v2/KiCAD/Supercap.kicad_pcb

## KiCad design KiCAD/Supercap.kicad_pcb (2026-11-11)

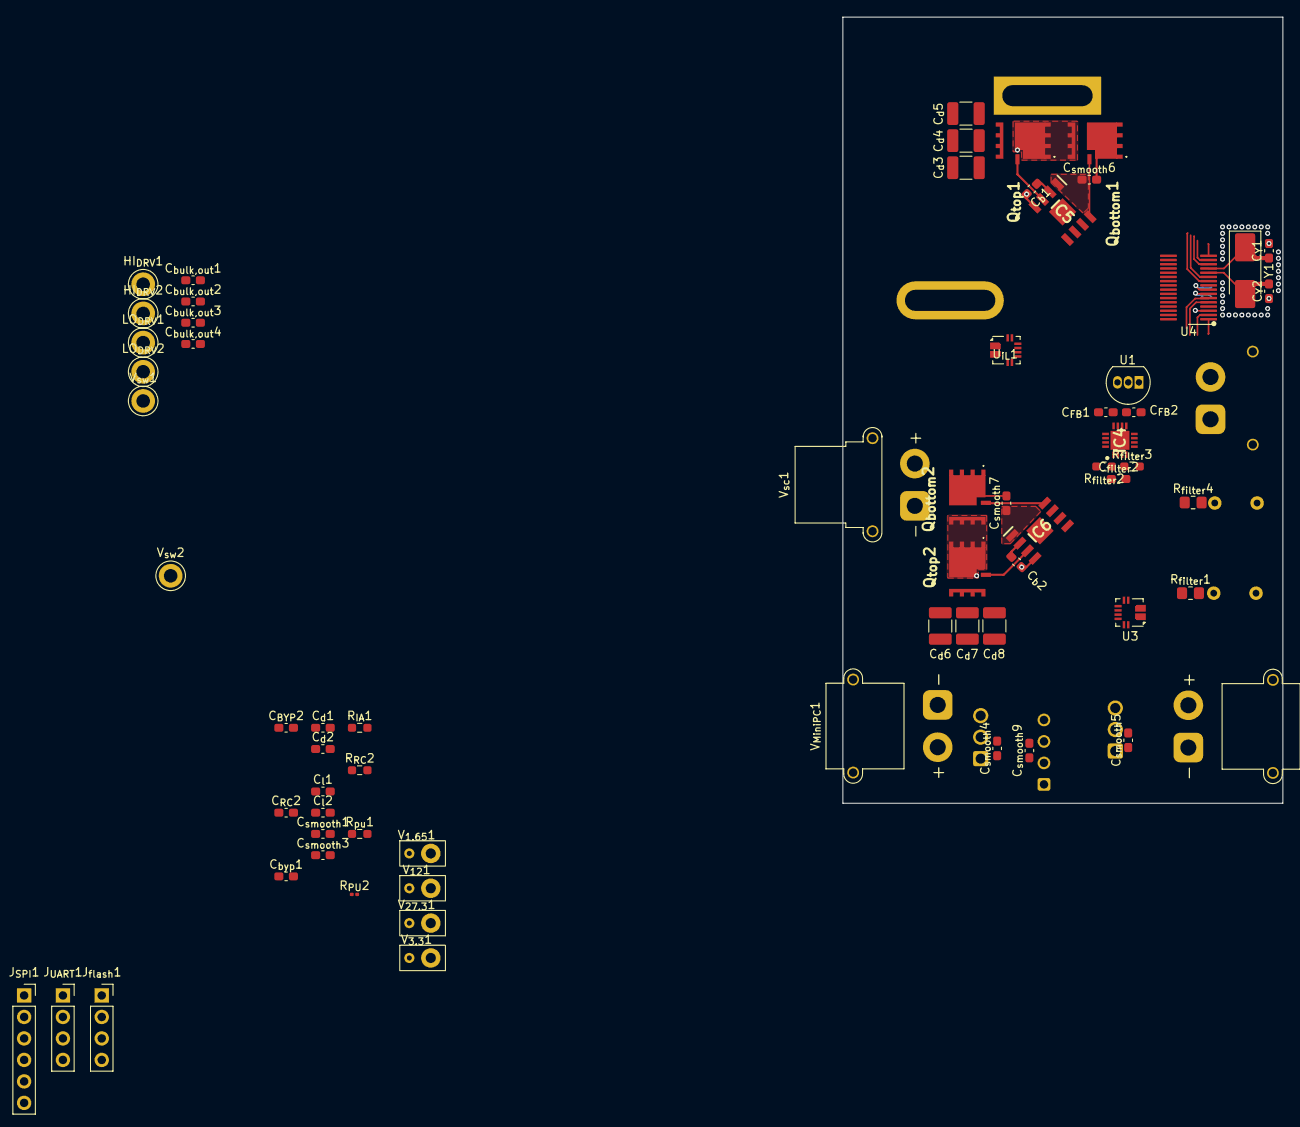
[picture p25: board KiCAD/Supercap.kicad_pcb from above]

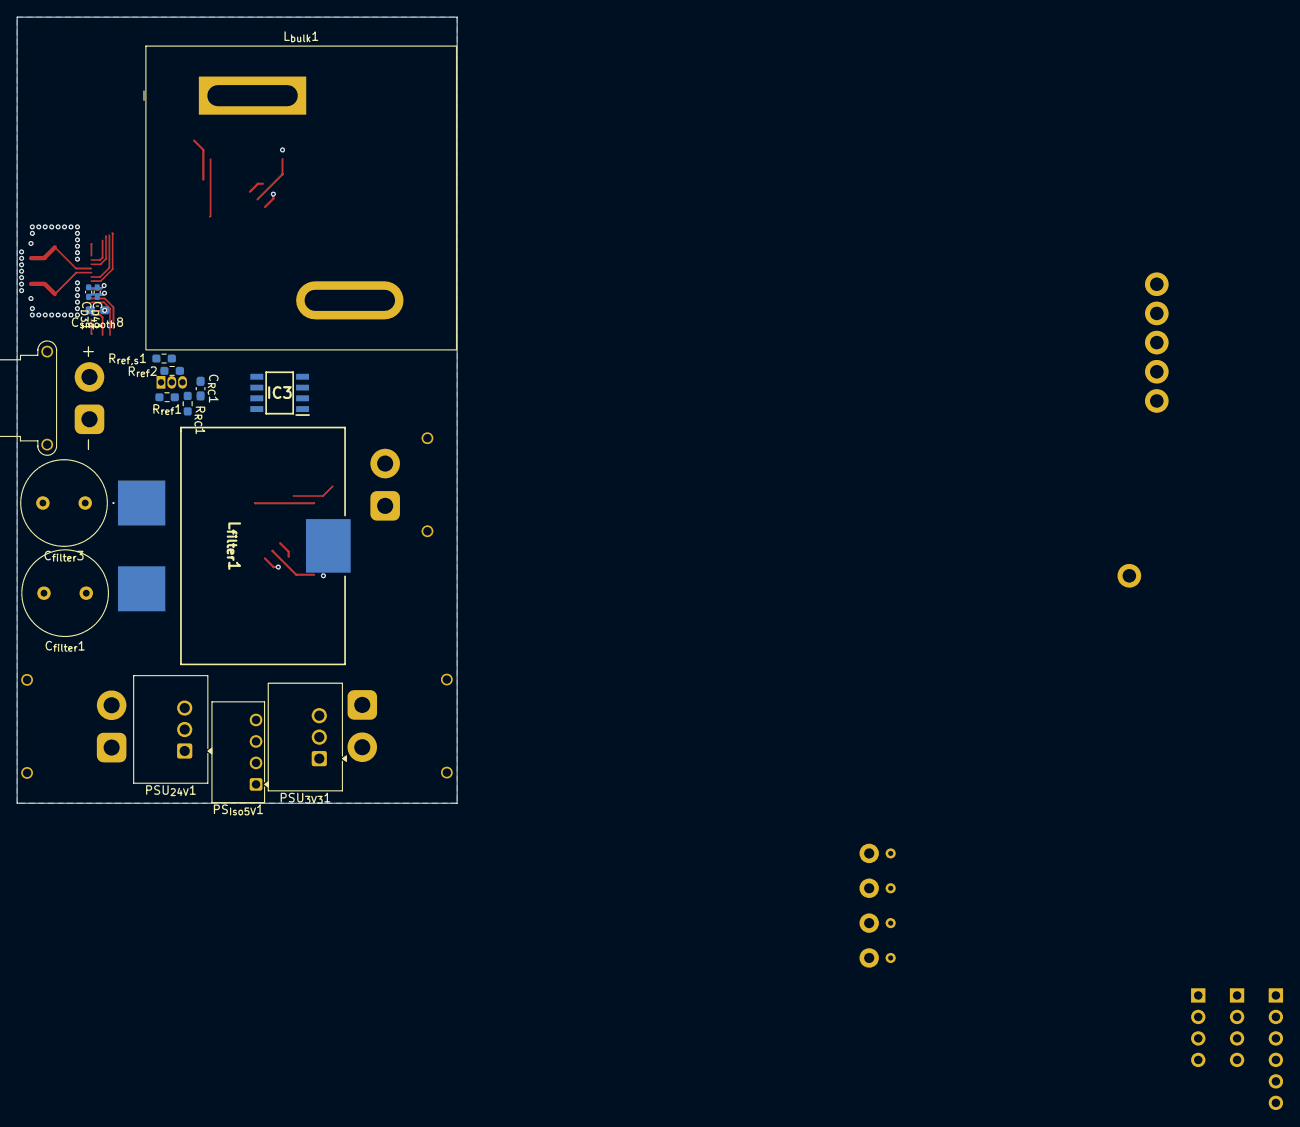
[picture p26: board KiCAD/Supercap.kicad_pcb from below]

Board: 4 copper layers, 52.0 x 92.9 mm, 84 parts (17 on the bottom side), 42 nets.

Parts:
C_{BYP}2: 0.1u; C_0603_1608Metric_Pad1.08x0.95mm_HandSolder
C_{D3}1: 100n; C_0402_1005Metric_Pad0.74x0.62mm_HandSolder
C_{D4}1: 10u; C_0402_1005Metric_Pad0.74x0.62mm_HandSolder
C_{FB}1, C_{FB}2: 100p; C_0603_1608Metric_Pad1.08x0.95mm_HandSolder
C_{RC}1, C_{RC}2: 1n; C_0603_1608Metric_Pad1.08x0.95mm_HandSolder
C_{Y}1, C_{Y}2: 10p; C_0603_1608Metric_Pad1.08x0.95mm_HandSolder
C_{bulk,out}1, C_{bulk,out}2, C_{bulk,out}3, C_{bulk,out}4: C_0603_1608Metric_Pad1.08x0.95mm_HandSolder
C_{byp}1: 0.1u; C_0603_1608Metric_Pad1.08x0.95mm_HandSolder
C_{b}1, C_{b}2: 1u; C_0603_1608Metric_Pad1.08x0.95mm_HandSolder
C_{d}1, C_{d}2: 0.1u; C_0603_1608Metric_Pad1.08x0.95mm_HandSolder
C_{d}3, C_{d}4, C_{d}5, C_{d}6, C_{d}7, C_{d}8: 10u; C_1210_3225Metric_Pad1.33x2.70mm_HandSolder
C_{filter}1, C_{filter}3: 1.2m; C_Radial_D10.0mm_H16.0mm_P5.00mm
C_{filter}2: 100p; C_0603_1608Metric_Pad1.08x0.95mm_HandSolder
C_{l}1, C_{l}2: 1n; C_0603_1608Metric_Pad1.08x0.95mm_HandSolder
C_{smooth}1, C_{smooth}3, C_{smooth}4, C_{smooth}5, C_{smooth}6, C_{smooth}7, C_{smooth}9: 4.7u; C_0603_1608Metric_Pad1.08x0.95mm_HandSolder
C_{smooth}8: 0.47u; C_0603_1608Metric_Pad1.08x0.95mm_HandSolder
HI_{DRV}1, HI_{DRV}2: TestPoint; TestPoint_Keystone_5010-5014_Multipurpose
IC3: INA823DT; SOIC127P600X175-8N
IC4: PGA849RGTR; QFN50P350X350X100-17N-D
IC5, IC6: MAX15019AASA+; SOIC127P600X175-9N
J_{SPI}1: Conn_01x06_Pin; PinSocket_1x06_P2.54mm_Vertical
J_{UART}1: Conn_01x04_Pin; PinSocket_1x04_P2.54mm_Vertical
J_{flash}1: Conn_01x04_Pin; PinSocket_1x04_P2.54mm_Vertical
LO_{DRV}1, LO_{DRV}2: TestPoint; TestPoint_Keystone_5010-5014_Multipurpose
L_{bulk}1: 27u; L_Wurth_WE-HCFT-3635_74437636352702
L_{filter}1: 33u; 74436413300
PSU_{3V3}1: TSR 0.5-2433; Converter_DCDC_TRACO_TSR0.5-24xx_TSR0.5-24xxx_THT
PSU_{24V}1: 490-P7812B-1000; Converter_DCDC_TRACO_TSR0.5-24xx_TSR0.5-24xxx_THT
PS_{Iso5V}1: SCT01F24S05; Converter_DCDC_TRACO_TEA1-xxxx_THT
Q_{bottom}1, Q_{bottom}2: IQDH45N04LM6CGSCATMA1
Q_{top}1, Q_{top}2: IQDH45N04LM6CGSCATMA1
R_{IA}1: 1M; R_0603_1608Metric_Pad0.98x0.95mm_HandSolder
R_{PU}2: 1k; R_0201_0603Metric
R_{RC}1, R_{RC}2: 100; R_0603_1608Metric_Pad0.98x0.95mm_HandSolder
R_{filter}1, R_{filter}4: 0.5; R_0805_2012Metric_Pad1.20x1.40mm_HandSolder
R_{filter}2, R_{filter}3: 100; R_0603_1608Metric_Pad0.98x0.95mm_HandSolder
R_{pu}1: 100; R_0603_1608Metric_Pad0.98x0.95mm_HandSolder
R_{ref,s}1: 5.6k; R_0603_1608Metric_Pad0.98x0.95mm_HandSolder
R_{ref}1: 47k; R_0603_1608Metric_Pad0.98x0.95mm_HandSolder
R_{ref}2: 16k; R_0603_1608Metric_Pad0.98x0.95mm_HandSolder
U1: LM4041LP-ADJ; TO-92_Inline
U3: ACS71240KEXBLT-010B3; Allegro_QFN-12-10-1EP_3x3mm_P0.5mm
U4: M0G3507QDGS32RQ1; VSSOP_0.5mm_32pin_handsolder
U_{iL}1: ACS711xEXLT-31AB; Allegro_QFN-12-10-1EP_3x3mm_P0.5mm
V_{1.65}1, V_{3.3}1, V_{12}1, V_{27.3}1: TestPoint; TP_Passive
V_{MiniPC}1: AMASS_XT30PW-M_1x02_P2.50mm_Horizontal
V_{in}1: AMASS_XT30PW-M_1x02_P2.50mm_Horizontal
V_{out}1: AMASS_XT30PW-F_1x02_P2.50mm_Horizontal
V_{sc}1: AMASS_XT30PW-F_1x02_P2.50mm_Horizontal
V_{sw}1, V_{sw}2: TestPoint; TestPoint_Keystone_5010-5014_Multipurpose
Y1: Crystal; Crystal_SMD_Abracon_ABM3-2Pin_5.0x3.2mm_HandSoldering

Connections:
+3V3: C_{BYP}2.1, C_{D3}1.1, C_{D4}1.1, C_{byp}1.1, C_{d}2.1, C_{smooth}3.1, IC4.7 (LVDD), J_{flash}1.4, PSU_{3V3}1.3 (Vout), R_{PU}2.2, R_{pu}1.2, R_{ref,s}1.1, U3.10 (VCC), U4.7 (VDD), U_{iL}1.10 (VCC), V_{3.3}1.1
/Control/DA_{IN+}: C_{FB}2.2, IC4.9 (DA_IN+)
/Control/DA_{IN-}: C_{FB}1.1, IC4.12 (DA_IN-)
/Control/F_L: R_{PU}2.1, U_{iL}1.4 (~FAULT)
/Control/F_bat: R_{pu}1.1, U3.4 (~FAULT)
/Control/HFXIN: C_{Y}2.1, U4.12 (PA5/HFXIN/FCC_IN), Y1.2
/Control/HFXOUT: C_{Y}1.1, U4.13 (PA6/HFCLK_IN/HFXOUT), Y1.1
/Control/I_L: C_{l}2.1, U_{iL}1.9 (VIOUT)
/Control/I_bat: C_{l}1.1, U3.9 (VIOUT)
/Control/I_{L,-}: L_{bulk}1.2, U_{iL}1.1 (IP+)
/Control/I_{bat,out+}: C_{bulk,out}1.1, C_{bulk,out}2.1, C_{bulk,out}3.1, C_{bulk,out}4.1, C_{d}3.1, C_{d}4.1, C_{d}5.1, C_{d}6.1, C_{d}7.1, C_{d}8.1, L_{filter}1.2, Q_{top}1.1 (D), Q_{top}2.1 (D), R_{filter}1.1, V_{out}1.2 (+)
/Control/I_{bat,sense}: L_{filter}1.1, R_{filter}4.1, U3.2 (IP-)
/Control/RC_{filter,L}: C_{filter}3.1, R_{filter}4.2
/Control/RC_{filter,R}: C_{filter}1.1, R_{filter}1.2
/Control/R_{G1}: IC3.1 (RG_1), R_{IA}1.1
/Control/R_{G2}: IC3.8 (RG_2), R_{IA}1.2
/Control/SWCLK: J_{flash}1.2, U4.27 (PA20/SWCLK)
/Control/SWDIO: J_{flash}1.1, U4.26 (PA19/SWDIO)
/Control/V_{bat,sense}+: C_{filter}2.1, IC4.2 (IN+), R_{filter}2.1
/Control/V_{bat,sense}-: C_{filter}2.2, IC4.3 (IN-), R_{filter}3.1
/Control/V_{bat,sens}: C_{FB}1.2, IC4.11 (OUT), R_{RC}1.1
/Control/V_{core}: C_{smooth}8.1, U4.3 (VCORE)
/Control/V_{sc,+}: IC3.3 (+IN), U_{iL}1.2 (IP-), V_{sc}1.2 (+)
/Control/V_{sc,sens}: IC3.6 (OUT), R_{RC}2.1
/Housekeeping/+1V65: C_{FB}2.1, IC4.10 (REF), R_{ref,s}1.2, R_{ref}1.1, U1.2 (K), V_{1.65}1.1
/Housekeeping/+12V: C_{smooth}6.1, C_{smooth}7.1, IC5.1 (VDD), IC6.1 (VDD), PSU_{24V}1.3 (Vout), V_{12}1.1
/Housekeeping/+24V: C_{smooth}5.1, PSU_{24V}1.1 (Vin), PS_{Iso5V}1.3 (-VOUT), R_{filter}2.2, U3.1 (IP+), V_{in}1.2 (+)
/Housekeeping/+29V: C_{d}1.1, C_{smooth}1.1, IC3.7 (+VS), IC4.6 (VS+), PS_{Iso5V}1.4 (+VOUT), V_{27.3}1.1
/Housekeeping/MiniPC: C_{smooth}4.1, C_{smooth}9.1, PSU_{3V3}1.1 (Vin), PS_{Iso5V}1.2 (+VIN), V_{MiniPC}1.2 (+)
/Housekeeping/V_{fb,d}: R_{ref}1.2, R_{ref}2.1, U1.1 (FB)
/Voltage Converter/HI_DRV_{1}: HI_{DRV}1.1 (1_1), IC5.3 (OUT_H), Q_{top}1.2 (G)
/Voltage Converter/HI_DRV_{2}: HI_{DRV}2.1 (1_1), IC6.3 (OUT_H), Q_{top}2.2 (G)
/Voltage Converter/LO_DRV_{1}: IC5.8 (OUT_L), LO_{DRV}1.1 (1_1), Q_{bottom}1.2 (G)
/Voltage Converter/LO_DRV_{2}: IC6.8 (OUT_L), LO_{DRV}2.1 (1_1), Q_{bottom}2.2 (G)
/Voltage Converter/V_{boot}1: C_{b}1.1, IC5.2 (BST)
/Voltage Converter/V_{boot}2: C_{b}2.1, IC6.2 (BST)
/Voltage Converter/V_{sw,1}: C_{b}1.2, IC5.4 (SW), L_{bulk}1.1, Q_{bottom}1.1 (D), Q_{top}1.3 (S), V_{sw}1.1 (1_1)
/Voltage Converter/V_{sw,2}: C_{b}2.2, IC3.2 (-IN), IC6.4 (SW), Q_{bottom}2.1 (D), Q_{top}2.3 (S), V_{sc}1.1 (-), V_{sw}2.1 (1_1)
GND: C_{BYP}2.2, C_{D3}1.2, C_{D4}1.2, C_{RC}1.2, C_{RC}2.2, C_{Y}1.2, C_{Y}2.2, C_{byp}1.2, C_{d}1.2, C_{d}2.2, C_{l}1.2, C_{l}2.2, C_{smooth}1.2, C_{smooth}3.2, C_{smooth}4.2, C_{smooth}8.2, C_{smooth}9.2, IC3.4 (-VS), IC3.5 (REF), IC4.14 (LVSS), IC4.16 (DGND), J_{flash}1.3, PSU_{3V3}1.2 (GND), PS_{Iso5V}1.1 (-VIN), R_{ref}2.2, U1.3 (A), U3.3 (GND), U4.8 (VSS), U_{iL}1.3 (GND), V_{1.65}1.2, V_{3.3}1.2, V_{MiniPC}1.1 (-)
GNDPWR: C_{bulk,out}1.2, C_{bulk,out}2.2, C_{bulk,out}3.2, C_{bulk,out}4.2, C_{d}3.2, C_{d}4.2, C_{d}5.2, C_{d}6.2, C_{d}7.2, C_{d}8.2, C_{filter}1.2, C_{filter}3.2, C_{smooth}5.2, C_{smooth}6.2, C_{smooth}7.2, IC4.1 (A2), IC4.4 (A0), IC4.5 (A1), IC4.15 (VS-), IC4.17 (VS-), IC5.7 (GND), IC5.9 (GND), IC6.7 (GND), IC6.9 (GND), PSU_{24V}1.2 (GND), Q_{bottom}1.3 (S), Q_{bottom}2.3 (S), R_{filter}3.2, V_{12}1.2, V_{27.3}1.2, V_{in}1.1 (-), V_{out}1.1 (-)
unnamed: C_{RC}1.1, R_{RC}1.2
unnamed: C_{RC}2.1, R_{RC}2.2
