ut-ras/rm_electrical-supercap_v2/Supercap.kicad_pcb

## KiCad design Supercap.kicad_pcb (2026-05-07)

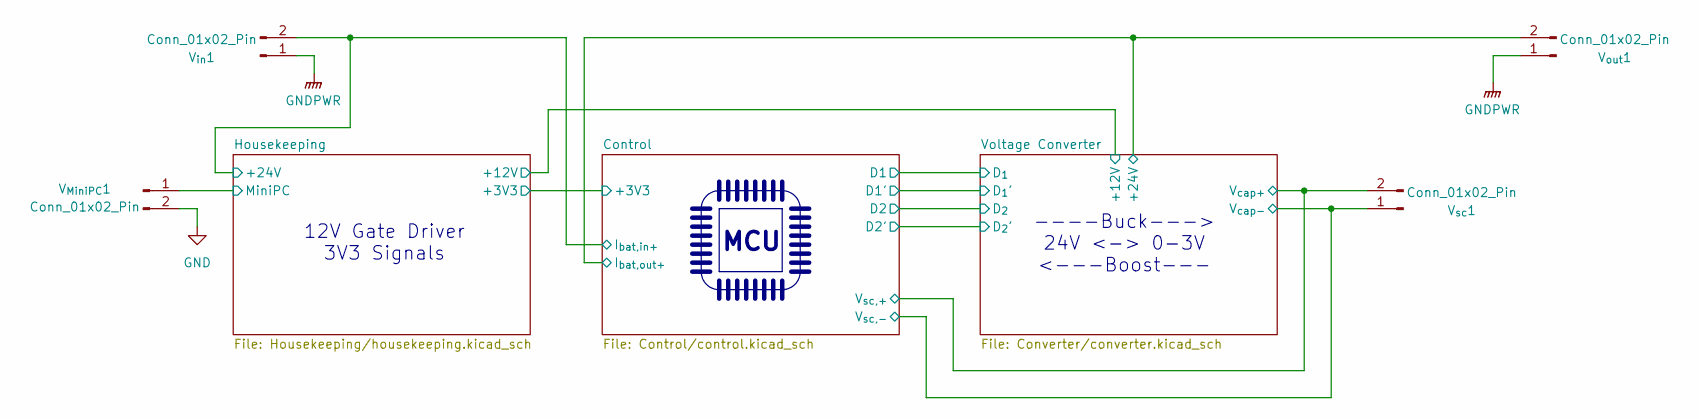
[picture p27: schematic Supercap.kicad_sch]

Parts:
V_{MiniPC}1: Conn_01x02_Pin; AMASS_XT30PW-F_1x02_P2.50mm_Horizontal
V_{in}1: Conn_01x02_Pin; AMASS_XT30PW-M_1x02_P2.50mm_Horizontal
V_{out}1: Conn_01x02_Pin; AMASS_XT30PW-F_1x02_P2.50mm_Horizontal
V_{sc}1: Conn_01x02_Pin; AMASS_XT30PW-M_1x02_P2.50mm_Horizontal

Connections:
/Control/I_{bat,in+}: V_{in}1.2; also elsewhere on the board
/Control/I_{bat,out+}: V_{out}1.2; also elsewhere on the board
/Control/V_{sc,+}: V_{sc}1.2; also elsewhere on the board
/Housekeeping/MiniPC: V_{MiniPC}1.1; also elsewhere on the board
/Voltage Converter/V_{sw,2}: V_{sc}1.1; also elsewhere on the board
GND: V_{MiniPC}1.2; also elsewhere on the board
GNDPWR: V_{in}1.1, V_{out}1.1; also elsewhere on the board

Notes on the sheet:
----Buck---> 24V <-> 0-3V <---Boost---
MCU
12V Gate Driver 3V3 Signals

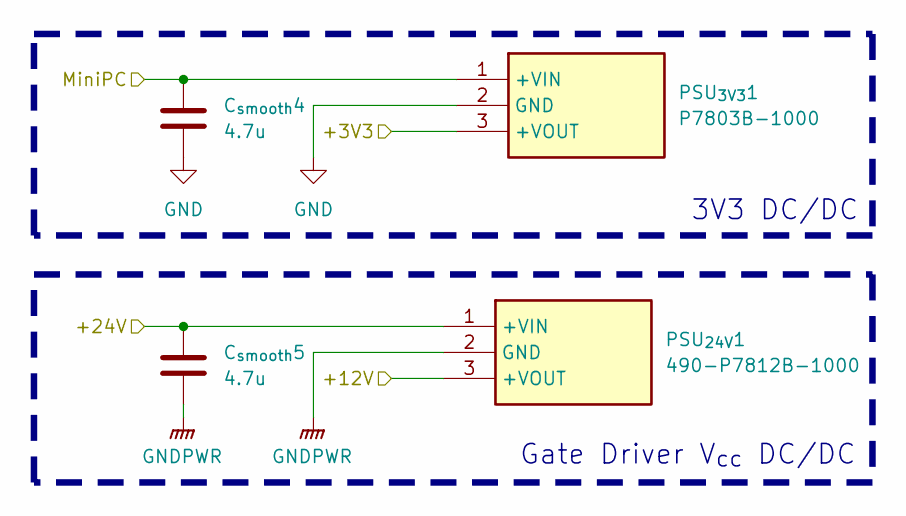
[picture p28: schematic housekeeping.kicad_sch, Housekeeping Board]

Parts:
C_{smooth}4, C_{smooth}5: 4.7u; C_0603_1608Metric_Pad1.08x0.95mm_HandSolder; Manufacturer_Part_Number CL10A475KO8NNNC; Mouser Part Number 187-CL10A475KO8NNNC
PSU_{3V3}1: P7803B-1000; P7812B1000; Manufacturer_Part_Number P7803B-1000; Mouser Part Number 490-P7803B-1000
PSU_{24V}1: 490-P7812B-1000; P7812B1000; Manufacturer_Part_Number P7812B-1000; Mouser Part Number 490-P7812B-1000

Connections:
/Control/+3V3: PSU_{3V3}1.3 (+VOUT); also elsewhere on the board
/Control/I_{bat,in+}: C_{smooth}5.1, PSU_{24V}1.1 (+VIN); also elsewhere on the board
/Housekeeping/+12V: PSU_{24V}1.3 (+VOUT); also elsewhere on the board
/Housekeeping/MiniPC: C_{smooth}4.1, PSU_{3V3}1.1 (+VIN); also elsewhere on the board
GND: C_{smooth}4.2, PSU_{3V3}1.2 (GND); also elsewhere on the board
GNDPWR: C_{smooth}5.2, PSU_{24V}1.2 (GND); also elsewhere on the board

Notes on the sheet:
Gate Driver V_{cc} DC/DC
3V3 DC/DC

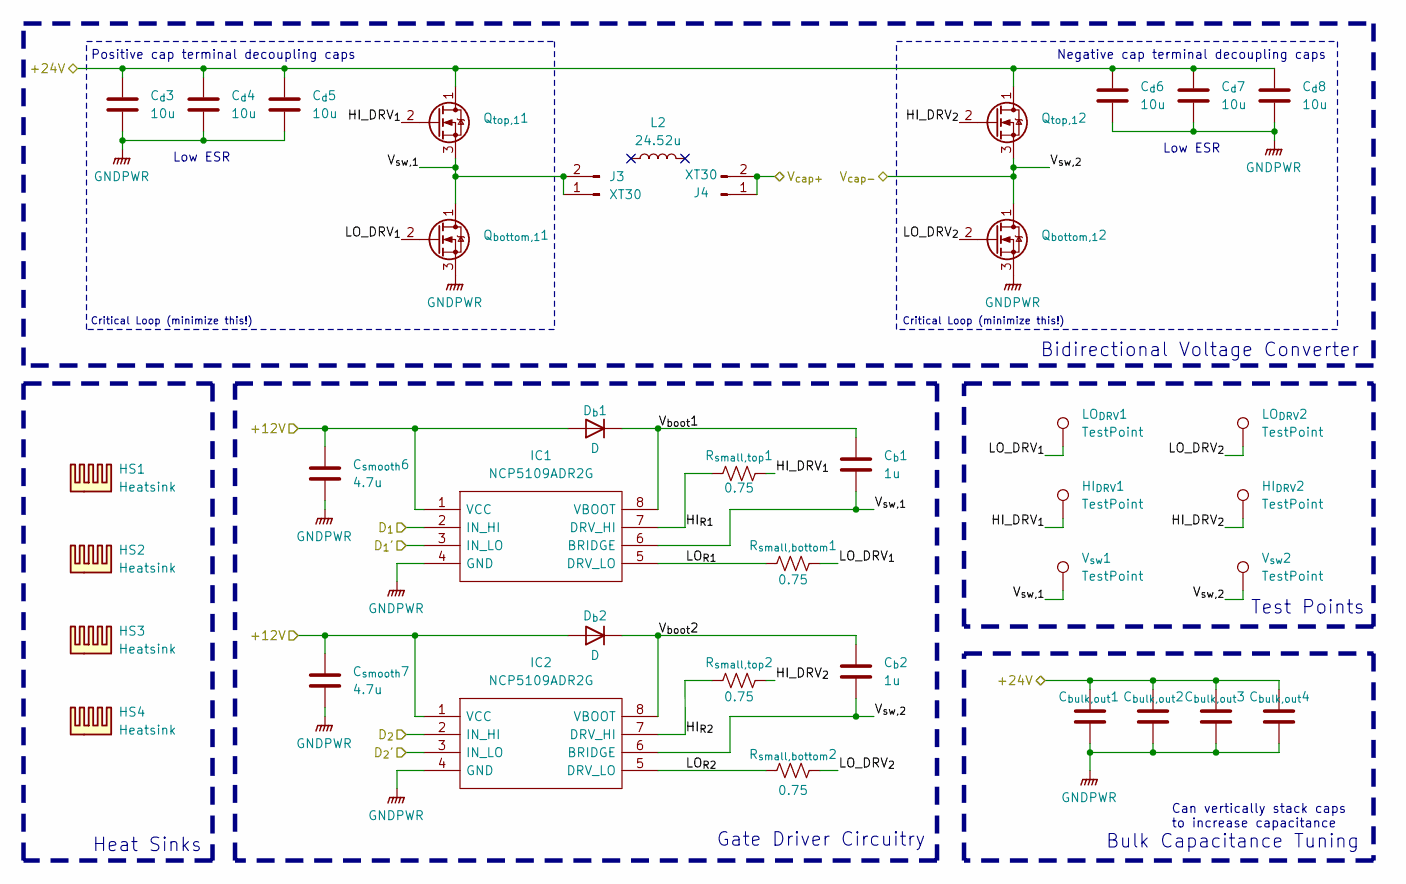
[picture p29: schematic converter.kicad_sch, DC/DC Converter and Gate Driver Board]

Parts:
C_{bulk,out}1, C_{bulk,out}2, C_{bulk,out}3, C_{bulk,out}4: C_0603_1608Metric_Pad1.08x0.95mm_HandSolder; Voltage Rating 50V
C_{b}1, C_{b}2: 1u; C_0603_1608Metric_Pad1.08x0.95mm_HandSolder; Manufacturer_Part_Number 963-MAJCT168BB7105KT; Mouser Part Number 963-MAJCT168BB7105KT
C_{d}3, C_{d}4, C_{d}5, C_{d}6, C_{d}7, C_{d}8: 10u; C_1210_3225Metric_Pad1.33x2.70mm_HandSolder; Voltage Rating 50V; Mouser Part Number 187-CL32B106KMVNNWE
C_{smooth}6, C_{smooth}7: 4.7u; C_0603_1608Metric_Pad1.08x0.95mm_HandSolder; Manufacturer_Part_Number CL10A475KO8NNNC; Mouser Part Number 187-CL10A475KO8NNNC
D_{b}1, D_{b}2: D; D_MicroSMP_AK; Manufacturer_Part_Number V1P22HM3_A/H; Mouser Part Number 78-V1P22HM3_A/H
HI_{DRV}1, HI_{DRV}2: TestPoint; TestPoint_Bridge_Pitch2.0mm_Drill0.7mm
HS1, HS2, HS3, HS4: Heatsink; Manufacturer_Part_Number HSB01-080808; Mouser Part Number 490-HSB01-080808
IC1, IC2: NCP5109ADR2G; SOIC127P600X175-8N; Mouser Part Number 863-NCP5109ADR2G
J3, J4: XT30; AMASS_XT30UPB-F_1x02_P5.0mm_Vertical
L2: 24.52u
LO_{DRV}1, LO_{DRV}2: TestPoint; TestPoint_Bridge_Pitch2.0mm_Drill0.7mm
Q_{bottom,1}1, Q_{bottom,1}2: IQDH45N04LM6CGSCATMA1; Manufacturer_Part_Number IQDH35N03LM5CGSCATMA1; Mouser Part Number 726-IQDH35N03LM5CGSC
Q_{top,1}1, Q_{top,1}2: IQDH45N04LM6CGSCATMA1; Manufacturer_Part_Number IQDH35N03LM5CGSCATMA1; Mouser Part Number 726-IQDH35N03LM5CGSC
R_{small,bottom}1, R_{small,bottom}2: 0.75; R_0603_1608Metric_Pad0.98x0.95mm_HandSolder; Manufacturer_Part_Number RL0603FR-070R75L; Mouser Part Number 603-RL0603FR-070R75L
R_{small,top}1, R_{small,top}2: 0.75; R_0603_1608Metric_Pad0.98x0.95mm_HandSolder; Manufacturer_Part_Number RL0603FR-070R75L; Mouser Part Number 603-RL0603FR-070R75L
V_{sw}1, V_{sw}2: TestPoint; TestPoint_Bridge_Pitch2.0mm_Drill0.7mm

Connections:
/Control/I_{bat,out+}: C_{bulk,out}1.1, C_{bulk,out}2.1, C_{bulk,out}3.1, C_{bulk,out}4.1, C_{d}3.1, C_{d}4.1, C_{d}5.1, C_{d}6.1, C_{d}7.1, C_{d}8.1, Q_{top,1}1.1 (D), Q_{top,1}2.1 (D); also elsewhere on the board
/Control/PA8: IC1.2 (IN_HI); also elsewhere on the board
/Control/PA22: IC1.3 (IN_LO); also elsewhere on the board
/Control/PA25: IC2.3 (IN_LO); also elsewhere on the board
/Control/PB9: IC2.2 (IN_HI); also elsewhere on the board
/Control/V_{sc,+}: J4.1, J4.2; also elsewhere on the board
/Housekeeping/+12V: C_{smooth}6.1, C_{smooth}7.1, D_{b}1.2 (A), D_{b}2.2 (A), IC1.1 (VCC), IC2.1 (VCC); also elsewhere on the board
/Voltage Converter/HI_DRV_{1}: HI_{DRV}1.1, Q_{top,1}1.2 (G), R_{small,top}1.2
/Voltage Converter/HI_DRV_{2}: HI_{DRV}2.1, Q_{top,1}2.2 (G), R_{small,top}2.2
/Voltage Converter/HI_{R1}: IC1.7 (DRV_HI), R_{small,top}1.1
/Voltage Converter/HI_{R2}: IC2.7 (DRV_HI), R_{small,top}2.1
/Voltage Converter/LO_DRV_{1}: LO_{DRV}1.1, Q_{bottom,1}1.2 (G), R_{small,bottom}1.2
/Voltage Converter/LO_DRV_{2}: LO_{DRV}2.1, Q_{bottom,1}2.2 (G), R_{small,bottom}2.2
/Voltage Converter/LO_{R1}: IC1.5 (DRV_LO), R_{small,bottom}1.1
/Voltage Converter/LO_{R2}: IC2.5 (DRV_LO), R_{small,bottom}2.1
/Voltage Converter/V_{boot}1: C_{b}1.1, D_{b}1.1 (K), IC1.8 (VBOOT)
/Voltage Converter/V_{boot}2: C_{b}2.1, D_{b}2.1 (K), IC2.8 (VBOOT)
/Voltage Converter/V_{sw,1}: C_{b}1.2, IC1.6 (BRIDGE), J3.1, J3.2, Q_{bottom,1}1.1 (D), Q_{top,1}1.3 (S), V_{sw}1.1
/Voltage Converter/V_{sw,2}: C_{b}2.2, IC2.6 (BRIDGE), Q_{bottom,1}2.1 (D), Q_{top,1}2.3 (S), V_{sw}2.1; also elsewhere on the board
GNDPWR: C_{bulk,out}1.2, C_{bulk,out}2.2, C_{bulk,out}3.2, C_{bulk,out}4.2, C_{d}3.2, C_{d}4.2, C_{d}5.2, C_{d}6.2, C_{d}7.2, C_{d}8.2, C_{smooth}6.2, C_{smooth}7.2, IC1.4 (GND), IC2.4 (GND), Q_{bottom,1}1.3 (S), Q_{bottom,1}2.3 (S); also elsewhere on the board

Notes on the sheet:
Heat Sinks
Critical Loop (minimize this!)
Negative cap terminal decoupling caps
Test Points
Bidirectional Voltage Converter
Bulk Capacitance Tuning
Gate Driver Circuitry
Low ESR
Can vertically stack caps to increase capacitance
Positive cap terminal decoupling caps

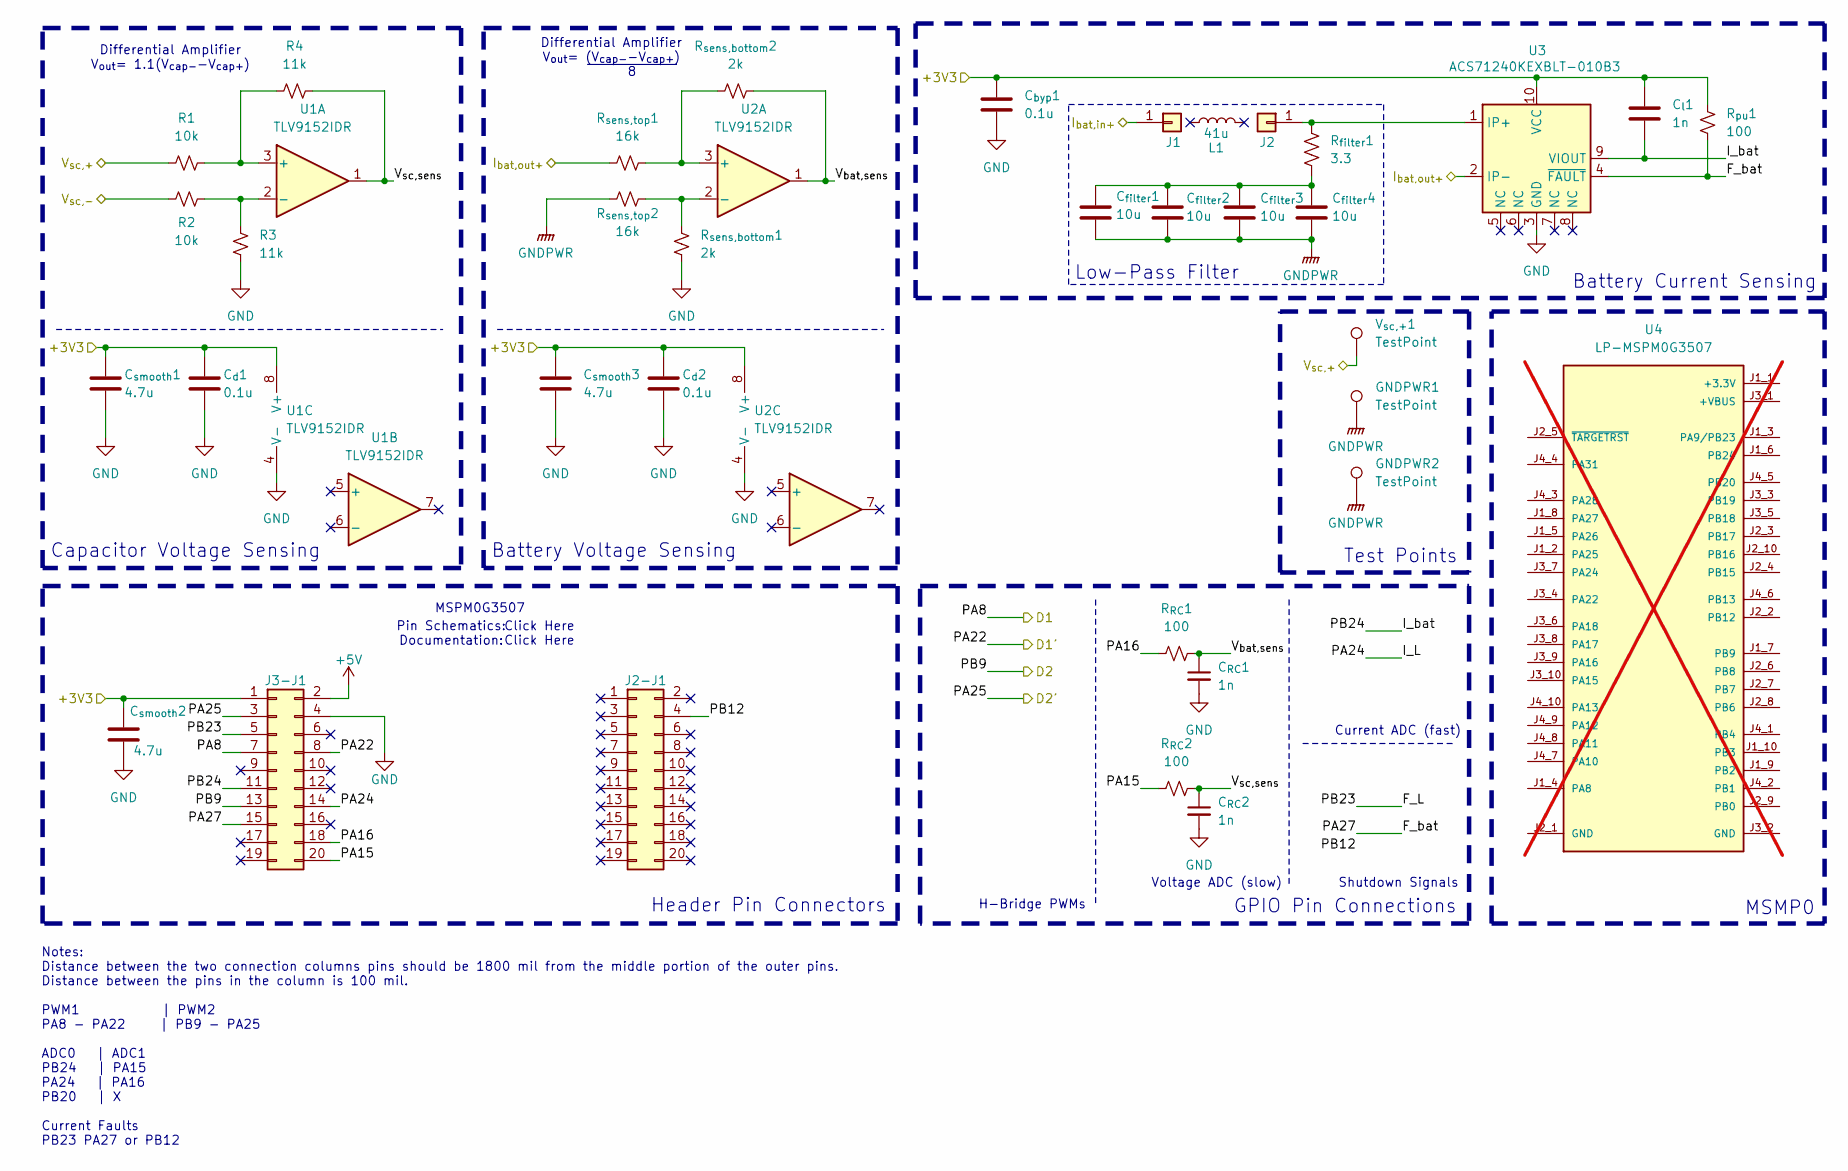
[picture p30: schematic control.kicad_sch, Controls and Sensing Board]

Parts:
C_{RC}1, C_{RC}2: 1n; C_0603_1608Metric_Pad1.08x0.95mm_HandSolder; Manufacturer_Part_Number CC0603JRX7R7BB102; Mouser Part Number 603-CC0603JR7R7BB102
C_{byp}1: 0.1u; C_0603_1608Metric_Pad1.08x0.95mm_HandSolder; Manufacturer_Part_Number MCAST168SB5104KTNA01; Mouser Part Number 963-MCAST168SB5104KT
C_{d}1, C_{d}2: 0.1u; C_0603_1608Metric_Pad1.08x0.95mm_HandSolder; Manufacturer_Part_Number KGM15BR71H104JM; Mouser Part Number 581-KGM15BR71H104JM
C_{filter}1, C_{filter}2, C_{filter}3, C_{filter}4: 10u; C_0603_1608Metric_Pad1.08x0.95mm_HandSolder; Mouser# 81-GRM188R6YA106MA3D
C_{l}1: 1n; C_0603_1608Metric_Pad1.08x0.95mm_HandSolder; Manufacturer_Part_Number CC0603JRX7R7BB102; Mouser Part Number 603-CC0603JR7R7BB102
C_{smooth}1, C_{smooth}2, C_{smooth}3: 4.7u; C_0603_1608Metric_Pad1.08x0.95mm_HandSolder; Manufacturer_Part_Number CL10A475KO8NNNC; Mouser Part Number 187-CL10A475KO8NNNC
GNDPWR1, GNDPWR2: TestPoint; TestPoint_Bridge_Pitch2.0mm_Drill0.7mm
J1, J2: Conn_01x01; Inductor_wire_conn
J2-J1, J3-J1: Conn_01x10; PinSocket_2x10_P2.54mm_Vertical; Manufacturer_Part_Number 2044-2X10G00SA; Digi-Key Part Number 2553-2044-2X10G00SA-ND
L1: 41u
R1, R2: 10k; R_0603_1608Metric_Pad0.98x0.95mm_HandSolder; Manufacturer_Part_Number RN73R1JTTD1002B50; Mouser Part Number 660-RN73R1JTD1002B50
R3, R4: 11k; R_0603_1608Metric_Pad0.98x0.95mm_HandSolder; Manufacturer_Part_Number RN73R1JTTD1102B25; Mouser Part Number 660-RN73R1JTD1102B25
R_{RC}1, R_{RC}2: 100; R_0603_1608Metric_Pad0.98x0.95mm_HandSolder; Manufacturer_Part_Number CRGCQ0603F100R; Mouser Part Number 279-CRGCQ0603F100R
R_{filter}1: 3.3; R_0603_1608Metric_Pad0.98x0.95mm_HandSolder; Manufacturer_Part_Number ERJ-H3QD3R30V; Mouser Part Number 667-ERJ-H3QD3R30V
R_{pu}1: 100; R_0603_1608Metric_Pad0.98x0.95mm_HandSolder; Manufacturer_Part_Number CRGCQ0603F100R; Mouser Part Number 279-CRGCQ0603F100R
R_{sens,bottom}1, R_{sens,bottom}2: 2k; R_0603_1608Metric_Pad0.98x0.95mm_HandSolder; Manufacturer_Part_Number AT0603DRD072KL; Mouser Part Number 603-AT0603DRD072KL
R_{sens,top}1, R_{sens,top}2: 16k; R_0603_1608Metric_Pad0.98x0.95mm_HandSolder; Manufacturer_Part_Number RT0603DRD0716KL; Mouser Part Number 603-RT0603DRD0716KL
U1, U2: TLV9152IDR; SOIC-8_3.9x4.9mm_P1.27mm; Manufacturer_Part_Number TLV9152IDR; Mouser Part Number 595-TLV9152IDR
U3: ACS71240KEXBLT-010B3; Allegro_QFN-12-10-1EP_3x3mm_P0.5mm; Manufacturer_Part_Number ACS71240KEXBLT-010B3; Mouser Part Number 250-71240KEXBLT010B3
U4: LP-MSPM0G3507; ti_LP_MSPM0G3507; not fitted
V_{sc,+}1: TestPoint; TestPoint_Bridge_Pitch2.0mm_Drill0.7mm

Connections:
+5V: J3-J1.2
/Control/+3V3: C_{byp}1.1, C_{d}1.1, C_{d}2.1, C_{l}1.1, C_{smooth}1.1, C_{smooth}2.1, C_{smooth}3.1, J3-J1.1, R_{pu}1.2, U1.8 (V+), U2.8 (V+), U3.10 (VCC); also elsewhere on the board
/Control/F_L: J3-J1.5
/Control/F_bat: J3-J1.15, R_{pu}1.1, U3.4 (~FAULT)
/Control/I_L: J3-J1.14
/Control/I_bat: C_{l}1.2, J3-J1.11, U3.9 (VIOUT)
/Control/I_{bat,in+}: J1.1; also elsewhere on the board
/Control/I_{bat,out+}: R_{sens,top}1.1, U3.2 (IP-); also elsewhere on the board
/Control/PA8: J3-J1.7; also elsewhere on the board
/Control/PA15: J3-J1.20, R_{RC}2.2
/Control/PA16: J3-J1.18, R_{RC}1.2
/Control/PA22: J3-J1.8; also elsewhere on the board
/Control/PA25: J3-J1.3; also elsewhere on the board
/Control/PB9: J3-J1.13; also elsewhere on the board
/Control/PB12: J2-J1.4
/Control/V_{bat,sens}: C_{RC}1.1, R_{RC}1.1, R_{sens,bottom}2.2, U2.1
/Control/V_{sc,+}: R1.1, V_{sc,+}1.1; also elsewhere on the board
/Control/V_{sc,sens}: C_{RC}2.1, R4.2, R_{RC}2.1, U1.1
/Voltage Converter/V_{sw,2}: R2.1; also elsewhere on the board
GND: C_{RC}1.2, C_{RC}2.2, C_{byp}1.2, C_{d}1.2, C_{d}2.2, C_{smooth}1.2, C_{smooth}2.2, C_{smooth}3.2, J3-J1.4, R3.2, R_{sens,bottom}1.1, U1.4 (V-), U2.4 (V-), U3.3 (GND); also elsewhere on the board
GNDPWR: C_{filter}1.2, C_{filter}2.2, C_{filter}3.2, C_{filter}4.2, GNDPWR1.1, GNDPWR2.1, R_{sens,top}2.1; also elsewhere on the board
unnamed: C_{filter}1.1, C_{filter}2.1, C_{filter}3.1, C_{filter}4.1, R_{filter}1.2
unnamed: J2.1, R_{filter}1.1, U3.1 (IP+)
unnamed: R1.2, R4.1, U1.3 (+)
unnamed: R2.2, R3.1, U1.2 (-)
unnamed: R_{sens,bottom}2.1, R_{sens,top}1.2, U2.3 (+)
unnamed: R_{sens,bottom}1.2, R_{sens,top}2.2, U2.2 (-)

Notes on the sheet:
Shutdown Signals
Pin Schematics: Documentation:
MSMP0
MSPM0G3507
Battery Current Sensing
Current ADC (fast)
Low-Pass Filter
Voltage ADC (slow)
Header Pin Connectors
Click Here
Differential Amplifier V_{out}= (V_{cap-}-V_{cap+}) ~{ 8 }
Test Points
GPIO Pin Connections
H-Bridge PWMs
Capacitor Voltage Sensing
Battery Voltage Sensing
Differential Amplifier V_{out}= 1.1(V_{cap-}-V_{cap+})
Notes: Distance between the two connection columns pins should be 1800 mil from the middle portion of the outer pins. Distance between the pins in the column is 100 mil. PWM1 | PWM2 PA8 - PA22 | PB9 - PA25 ADC0 | ADC1 PB24 | PA15 PA24 | PA16 PB20 | X Current Faults PB23 PA27 or PB12

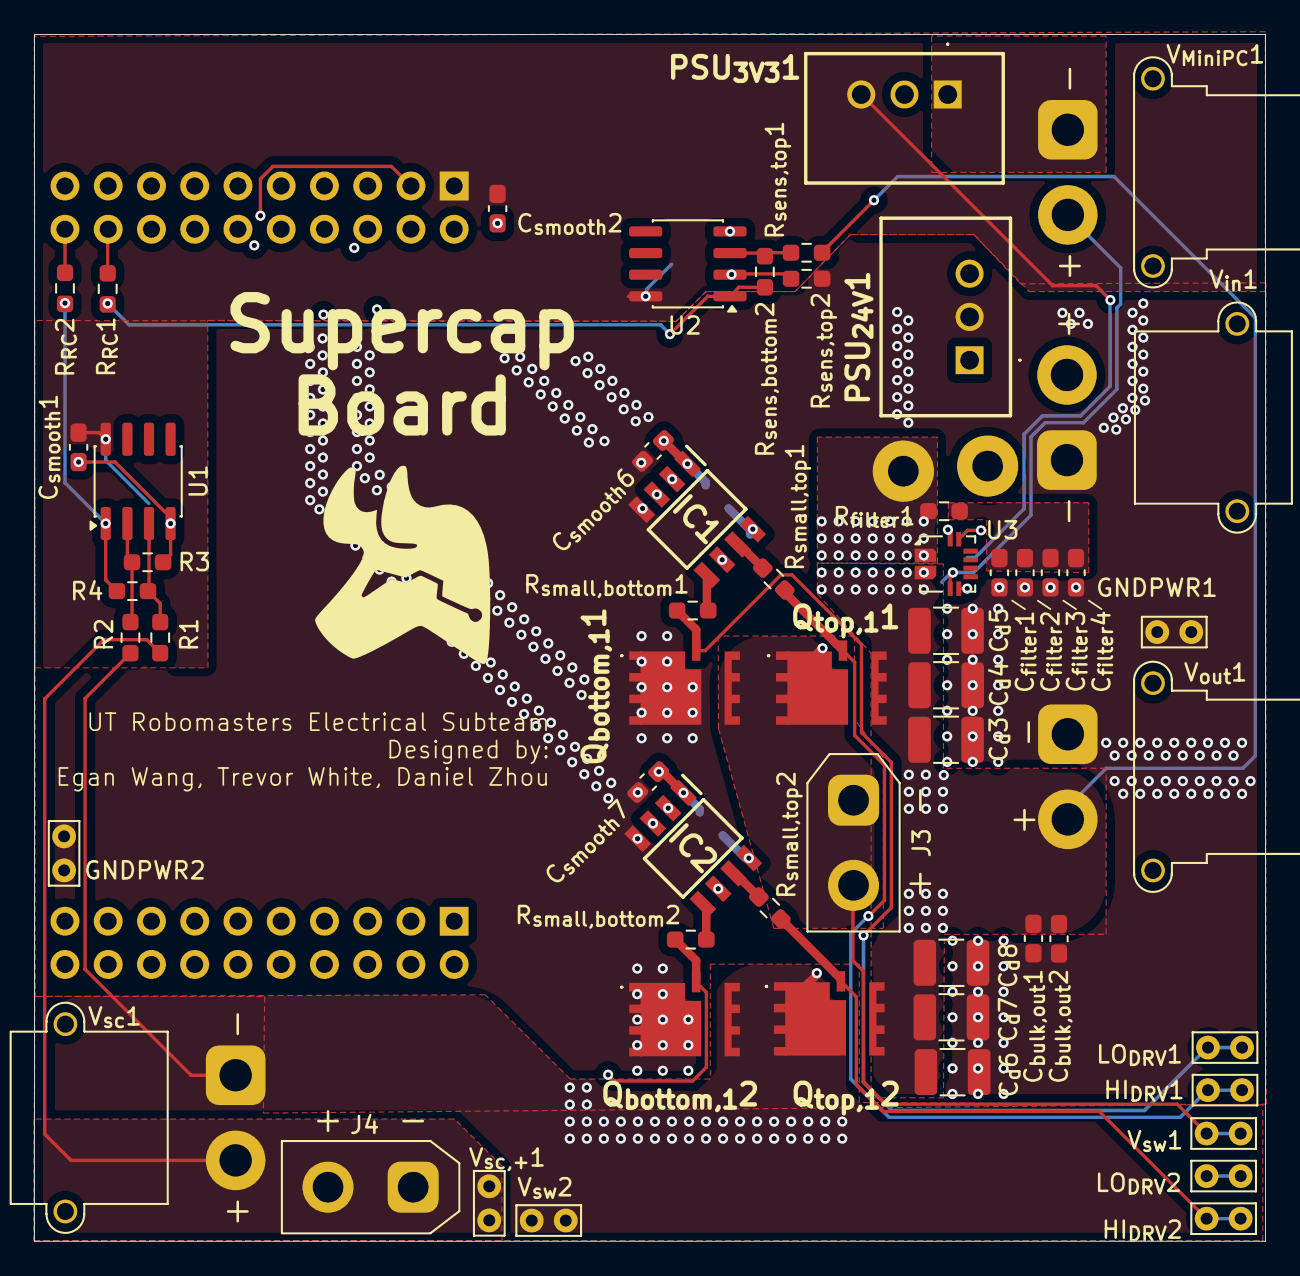
[picture p31: board Supercap.kicad_pcb from above]

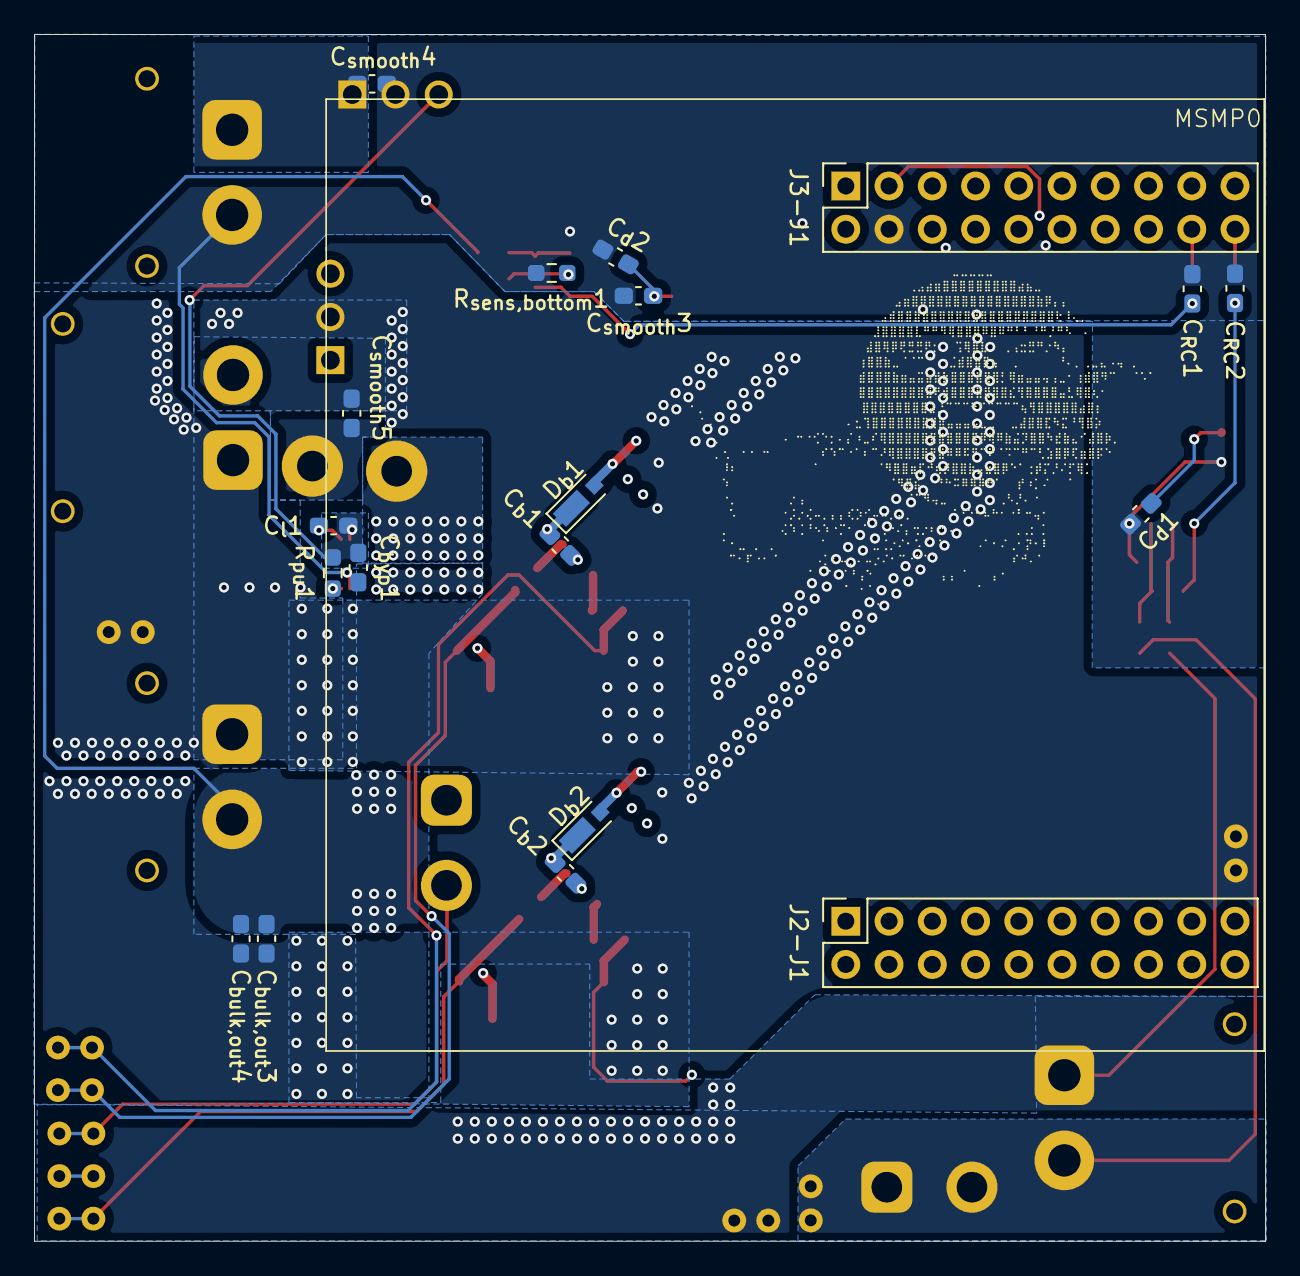
[picture p32: board Supercap.kicad_pcb from below]

Board: 4 copper layers, 72.3 x 70.9 mm, 77 parts (20 on the bottom side), 36 nets.
