ut-ras/rm_electrical-supercap_v2/TrevorsMasterpiece/empty.c

#include "ti_msp_dl_config.h"
//#include <math.h>

volatile uint16_t voltage1 = 0;
volatile uint16_t current1 = 0;
volatile uint16_t voltage2 = 0;
volatile uint16_t current2 = 0;
volatile uint16_t inductorVoltage = 0;

// Function prototypes
void set_PWM_Edges(uint32_t ch1_up_tick, uint32_t ch0_down_tick);
void test_PWM_Output(void);

int main(void)
{
    // Initilize Hardware
    SYSCFG_DL_init();
    // Enable ADC interupt
    NVIC_EnableIRQ(ADC12_0_INST_INT_IRQN);
    // Enable error signal interupts
    NVIC_EnableIRQ(PWM_0_INST_INT_IRQN);
    DL_TimerA_enableInterrupt(PWM_0_INST, DL_TIMER_INTERRUPT_FAULT_EVENT);
    // Turn off LED
    DL_GPIO_clearPins(GPIO_GRP_0_PORT, GPIO_GRP_0_PIN_0_PIN);
    // Turn on adc
    DL_ADC12_enableConversions(ADC12_0_INST);
    DL_ADC12_enableConversions(ADC12_1_INST);
    //TEMP code for setting initil PWM output
    test_PWM_Output();
    //fuck
    DL_TimerA_enableFaultInput(PWM_0_INST);
    // Furn on timer for PWM and ADCs
    DL_TimerA_startCounter(PWM_0_INST);
    while (1) {
        __WFI(); 
    }
}

// ------------------------------------------------------------------
// INTERRUPT SERVICE ROUTINE (Runs at 120 kHz)
void ADC12_0_INST_IRQHandler(void)
{
    switch (DL_ADC12_getPendingInterrupt(ADC12_0_INST)) {
        case DL_ADC12_IIDX_MEM1_RESULT_LOADED:
            
            // Read all ADC channels
            voltage1 = DL_ADC12_getMemResult(ADC12_0_INST, DL_ADC12_MEM_IDX_0);
            current1 = DL_ADC12_getMemResult(ADC12_0_INST, DL_ADC12_MEM_IDX_1);
            voltage2 = DL_ADC12_getMemResult(ADC12_1_INST, DL_ADC12_MEM_IDX_0);
            current2 = DL_ADC12_getMemResult(ADC12_1_INST, DL_ADC12_MEM_IDX_1);
            
            // PUT THE FF PI CONTROLER HERE
            
            break;
            
        default:
            break;
    }
}

// ------------------------------------------------------------------
// TIMER FAULT INTERRUPT HANDLER
void PWM_0_INST_IRQHandler(void)
{
    // Check which timer event triggered the interrupt
    switch (DL_TimerA_getPendingInterrupt(PWM_0_INST)) {
        
        case DL_TIMER_IIDX_FAULT:
            DL_GPIO_setPins(GPIO_GRP_0_PORT, GPIO_GRP_0_PIN_0_PIN);
            __asm("nop");
            // Clear interrupt flag, I don't think we will need this for our application
            DL_TimerA_clearInterruptStatus(PWM_0_INST, DL_TIMER_INTERRUPT_FAULT_EVENT);
            break;
            
        default:
            break;
    }
}


// ------------------------------------------------------------------
// HELPER & TEST FUNCTIONS
// ------------------------------------------------------------------

// Sets the exact timer ticks (0 to 133) where the pins drop LOW
void set_PWM_Edges(uint32_t ch1_up_tick, uint32_t ch0_down_tick)
{
    // Max timer count is 133 for 120kHz at 32MHz (32MHz / 120kHz / 2 - 1 for center, but 133 here)
    if (ch1_up_tick > 133) ch1_up_tick = 133;
    if (ch0_down_tick > 133) ch0_down_tick = 133;

    // Calculate the midpoint between the two falling edges for ADC trigger
    uint32_t midpoint_tick = (ch1_up_tick + ch0_down_tick) / 2;

    // PWM edges (Edge-Aligned: both start HIGH at 0, fall at CC match)
    DL_TimerA_setCaptureCompareValue(PWM_0_INST, ch1_up_tick, DL_TIMER_CC_1_INDEX);
    DL_TimerA_setCaptureCompareValue(PWM_0_INST, ch0_down_tick, DL_TIMER_CC_0_INDEX);

    // Set the ADC trigger point halfway between the edges
    DL_TimerA_setCaptureCompareValue(PWM_0_INST, midpoint_tick, DL_TIMER_CC_2_INDEX);
}

// Starting PWM value for testing
void test_PWM_Output(void)
{
    set_PWM_Edges(60, 100);
}
