ut-ras/rm_electrical-supercap_v2/(commit log)

2025-10-31 Initial organization and commit
    [Supercap.kicad_pcb, Supercap.kicad_sch]
2025-10-31 add input buck
    [InputBuck 1B.kicad_pcb, InputBuck 1B.kicad_sch, buck.kicad_sch]
2025-11-01 Current Sense
    [CurrSens 1B.kicad_pcb, CurrSens 1B.kicad_sch]
2025-11-02 began setup of hierarchial boards for supercap
    [InputBuck.kicad_pcb, InputBuck.kicad_sch, Supercap.kicad_sch, control.kicad_sch, converter.kicad_sch, housekeeping.kicad_sch, supercap.kicad_sch]
2025-11-04 added more flesh to overall structure, primarily on converter stage
    [Supercap.kicad_sch, converter.kicad_sch, supercap.kicad_sch, supercap_board.kicad_sch]
2025-11-05 finished first pass of general block diagram
    [Supercap.kicad_sch, control.kicad_sch, housekeeping.kicad_sch]
2025-11-05 replaced 2p2s caps with full parallel
    [Supercap.kicad_sch, supercap_board.kicad_sch]
2025-11-09 created PLECS simulation file, need to figure out what is going on with ringing behavior
    [supercap_board.kicad_sch]
2025-11-15 Updated power stage PLECS simulation
2025-11-22 added switch-cycle average model with parameters for constant current control in open loop
2025-11-27 removed unnecessary critical loop
    [converter.kicad_sch]
2025-12-20 switched capacitor topology to 4S
    [Supercap.kicad_sch, supercap_board.kicad_sch]
2026-01-30 changed converter topology to full-bridge design
    [Supercap.kicad_sch, converter.kicad_sch, supercap_board.kicad_sch]
2026-02-08 dc/dc converter
    [housekeeping.kicad_sch]
2026-02-15 began work on adding gate driver circuitry
    [converter.kicad_sch, housekeeping.kicad_sch]
2026-02-16 Added schematic, footprints, and datasheets for voltage sense
    [Voltage_Sense_SupCap.kicad_pcb, Voltage_Sense_SupCap.kicad_sch]
2026-02-20 added symbol libraries and finished gate driver circuitry schematic
    [Supercap.kicad_sch, control.kicad_sch, converter.kicad_sch, housekeeping.kicad_sch]
2026-02-22 fixed converter section
    [Supercap.kicad_sch, converter.kicad_sch, supercap_board.kicad_sch]
2026-02-22 MSPM0 Connections
    [control.kicad_sch]
2026-02-22 added mosfet footprints and assigned to switch symbols
    [converter.kicad_sch]
2026-02-22 Diff Amp
    [control.kicad_sch]
2026-02-22 assigned footprints for some passives
    [converter.kicad_sch, housekeeping.kicad_sch]
2026-03-01 attempting to push kicad library mosfet sym/foot
2026-03-01 more simulation work + fixed some things in root schematic
    [Supercap.kicad_sch, control.kicad_sch, converter.kicad_sch]
2026-03-01 DCDCconverter modified
    [housekeeping.kicad_sch]
2026-03-01 wiring connected, now only need msmp0 pinout and footprint assignments
    [Supercap.kicad_sch, control.kicad_sch, housekeeping.kicad_sch]
2026-03-01 fixed inductor connection
    [converter.kicad_sch, housekeeping.kicad_sch]
2026-03-01 decoupling capacitors assigned
    [converter.kicad_sch]
2026-03-01 removed v1 files and assigned mouser part numbers
    [CurrSens 1B.kicad_pcb, CurrSens 1B.kicad_sch, InputBuck.kicad_pcb, InputBuck.kicad_sch, Supercap.kicad_sch, Voltage_Sense_SupCap.kicad_pcb, Voltage_Sense_SupCap.kicad_sch, buck.kicad_sch]
2026-03-02 began layout
    [Supercap.kicad_pcb, Supercap.kicad_sch, control.kicad_sch, converter.kicad_sch, housekeeping.kicad_sch, supercap_board.kicad_sch]
2026-03-03 mostly done with first order layout
    [Supercap.kicad_pcb, Supercap.kicad_sch, control.kicad_sch, converter.kicad_sch, housekeeping.kicad_sch, supercap_board.kicad_sch]
2026-03-04 I FINALLY FIGURED OUT THE CONTROL SCHEME I NEEDED A SQUARE ROOT
    [Supercap.kicad_pcb, control.kicad_sch]
2026-03-06 added sample data to MATLAB
2026-03-07 critical loops trace
    [Supercap.kicad_pcb, control.kicad_sch]
2026-03-08 hopefully: did crit and driver loops for rt half bridge, swapped decoupling caps and Cd/Csmooth 6 and 7 for organization purposes
    [Supercap.kicad_pcb]
2026-03-08 bigger trace push before trevor starts
    [Supercap.kicad_pcb]
2026-03-08 ok hopefully this doesnt break everything, committing after doing in kicadlib submod
    [Supercap.kicad_pcb, Supercap.kicad_sch, control.kicad_sch]
2026-03-08 added mspm0 fp, still need to map pin nets on sym in schematic, in process of doing redesign to min power path
    [Supercap.kicad_pcb, Supercap.kicad_sch, control.kicad_sch]
2026-03-09 WORKING SWITCH-CYCLE AVERAGE MODEL LESGOOOOOO
2026-03-10 more screwing around with open loop control
2026-03-12 large expansion to explanation powerpoint + some brushing up on toy model
2026-03-13 via stitching on fets, fixed sheet pin (not label on parent) for isense, messed around with design
    [Supercap.kicad_pcb, Supercap.kicad_sch, control.kicad_sch]
2026-03-21 big progress on layout
    [Supercap.kicad_pcb, Supercap.kicad_sch, control.kicad_sch, converter.kicad_sch, housekeeping.kicad_sch, supercap_board.kicad_sch]
2026-03-21 FINISHED EXCEPT FOR FAULT TRACES YIPPEE
    [Supercap.kicad_pcb, control.kicad_sch, converter.kicad_sch]
2026-03-22 jed irl review
    [Supercap.kicad_pcb]
2026-03-23 Fault Code & Pins
    Added the config for the hardware fault handing of the current sensors. When the fault signal falls low all pwm signals and their complements are set to grounod. Additionally the traces for this were run on the board.
    Other: Changed some ADC input pins to avoid double use with the launch pad board.
    [Supercap.kicad_pcb, Supercap.kicad_sch, control.kicad_sch, converter.kicad_sch]
2026-03-24 minor PCB tweaks
    [Supercap.kicad_pcb]
2026-03-24 made corners better for switch nodes, hopefully
    [Supercap.kicad_pcb]
2026-03-27 started work on reverse charging functionality
2026-03-28 updated powerpoint
2026-03-29 finished sensitivity theoretical section of powerpoint
2026-03-29 updated sensitivity
    [Supercap.kicad_pcb]
2026-03-29 Sensor White Noise Slide
2026-04-01 FAULT HANDELR WORKING!!!!
    There is still an issue where the ISR is not running so we currently can't clear the fault but that might be desired.
    [empty.c]
2026-04-05 worked a lil on the FFPI
    Problem with imported math function but the code is saved in a text document called FFPI
    [empty.c]
2026-04-10 Matlab for LC filter
2026-04-11 Matlab and Excel for Pi filter values, poles, and zero
    [PI Filter Values (RM_Electrical '26).xlsx]
2026-04-11 moving files
    [PI Filter Values (RM_Electrical '26).xlsx]
2026-04-12 updated matlab + Bode plotting
    [PI Filter Values (RM_Electrical '26).xlsx, pi_filter_solutions.xlsx]
2026-04-14 minor tweaks to model + filter design
2026-04-17 added Heath revision
2026-05-05 finished power stage modeling powerpoint
2026-05-07 big ahhhh merge + partial bringup guide written
    [Standalone Board.kicad_sch, Supercap.kicad_pcb, Supercap.kicad_sch, control.kicad_sch, converter.kicad_sch, housekeeping.kicad_sch, supercap_board.kicad_sch]
2026-10-11 updated kicad library
2026-11-07 Added VSSOP-32 Chip, Crystal, Inductor current sensor, and changed low pass filter capacitor
2026-11-08 moving kicad library wip
2026-11-08 added heath sensor for real this time
2026-11-08 schematic rewiring
2026-11-08 added filter design
2026-11-10 began prelim pcb layout
2026-11-11 small pcb
